FredericSegard/MH6502_v4/README.md

# MH6502-4
 This is my masterpiece MH6502-4.
