FredericSegard/MH6502_v4/Images and docs/Revision 4.pdf

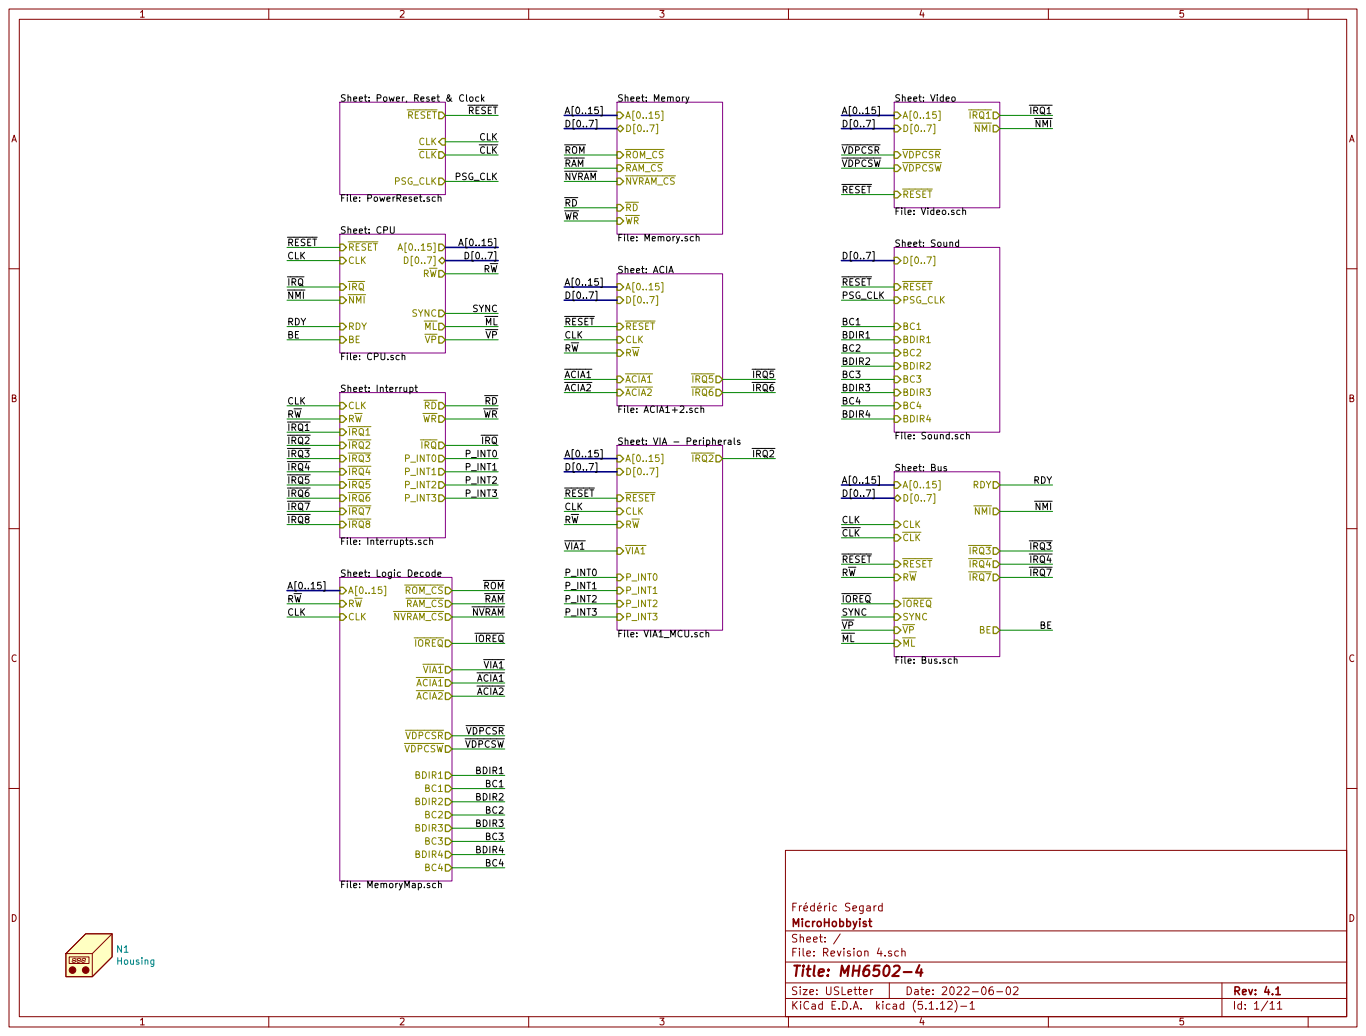
[picture p1: page 1]

Sheet: Power, Reset & Clock File: PowerReset.sch RESET CLK CLK

Sheet: Video File: Video.sch RESET
IRQ1 NMI A[0..15] VDPCSR
Sheet: Sound File: Sound.sch D[0..7] RESET BC1 BDIR1 PSG_CLK

Sheet: ACIA
File: ACIA1+2.sch A[0..15] CLK RW

IRQ
File: CPU.sch NMI

Sheet: Bus File: Bus.sch CLK CLK RESET RW
IRQ3 A[0..15]
NMI SYNC

Frédéric Segard
File: Revision 4.sch Sheet: / MicroHobbyist

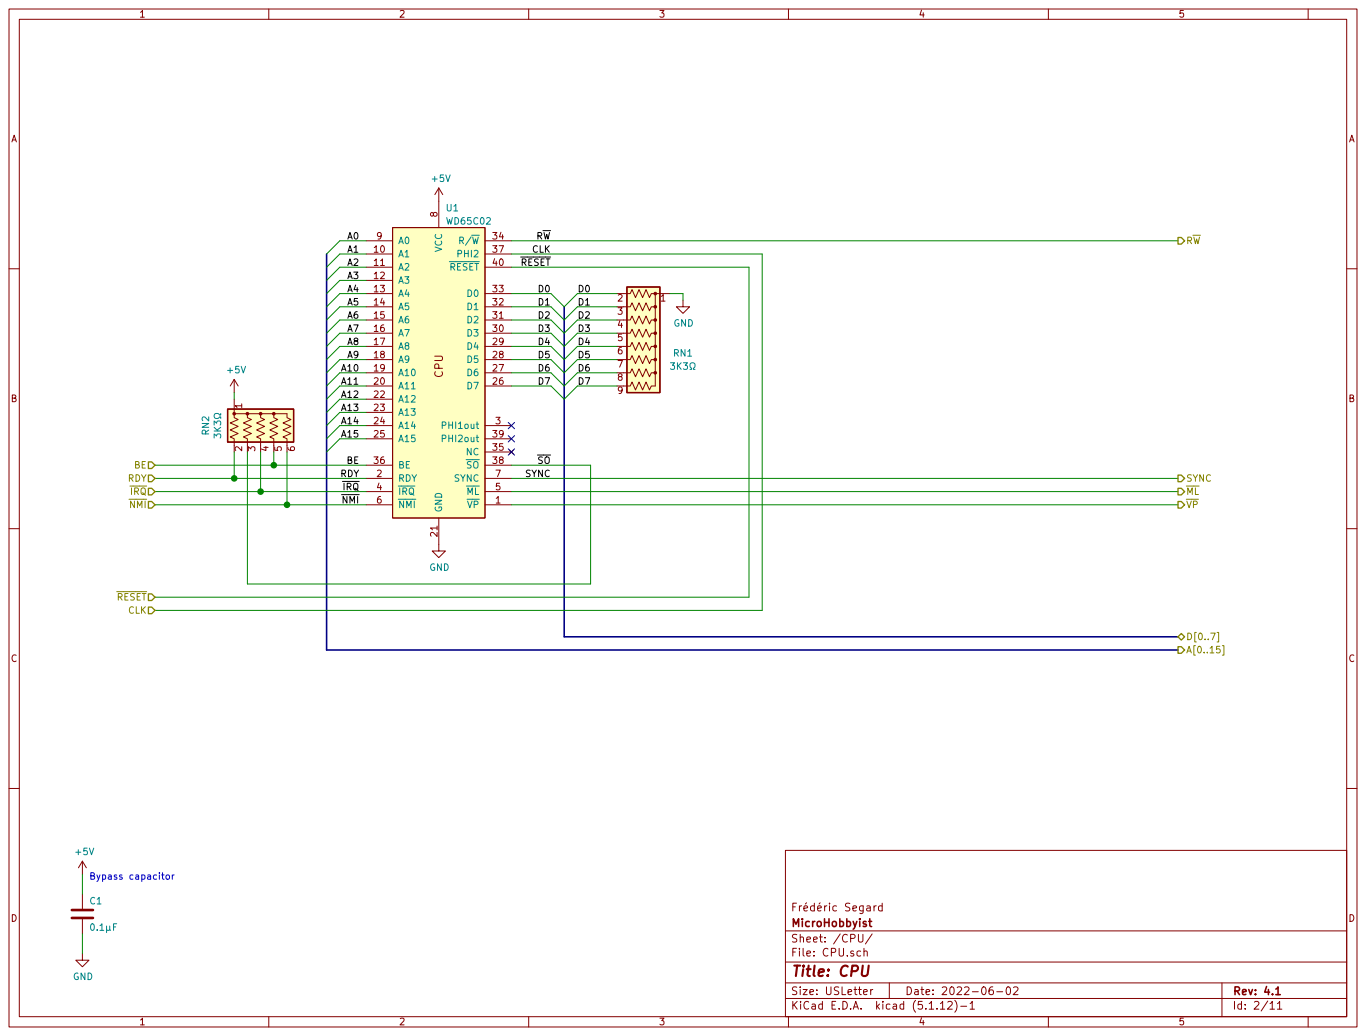
[picture p2: page 2]

Frédéric Segard
File: CPU.sch Sheet: /CPU/ MicroHobbyist

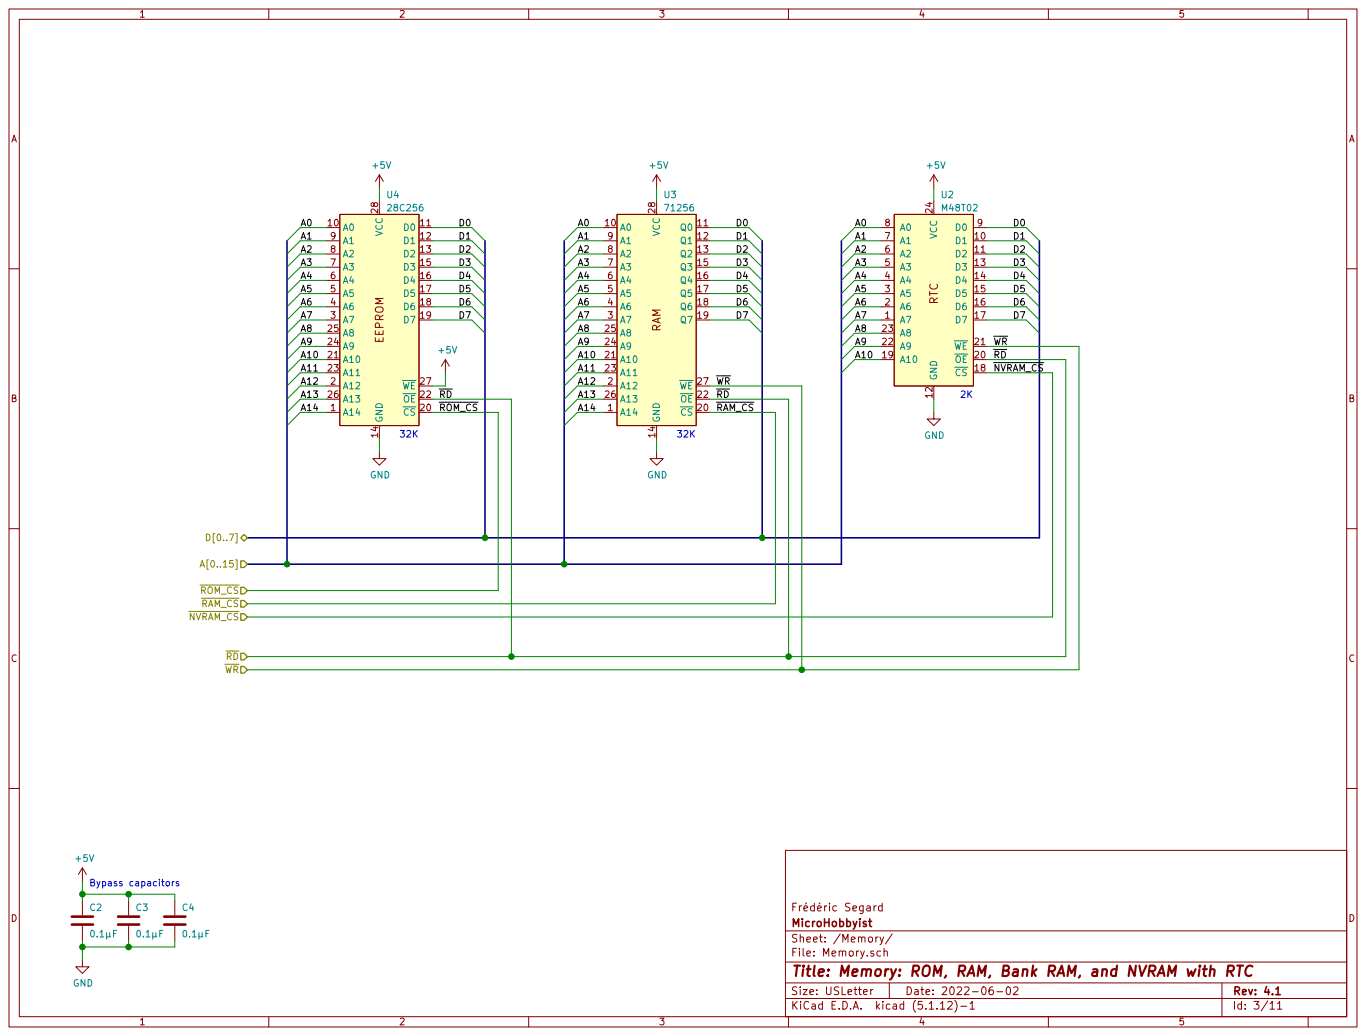
[picture p3: page 3]

Frédéric Segard GND EEPROM

MicroHobbyist
Sheet: /Memory/
File: Memory.sch
Id: 3/11 Title: Memory: ROM, RAM, Bank RAM, and NVRAM with RTC

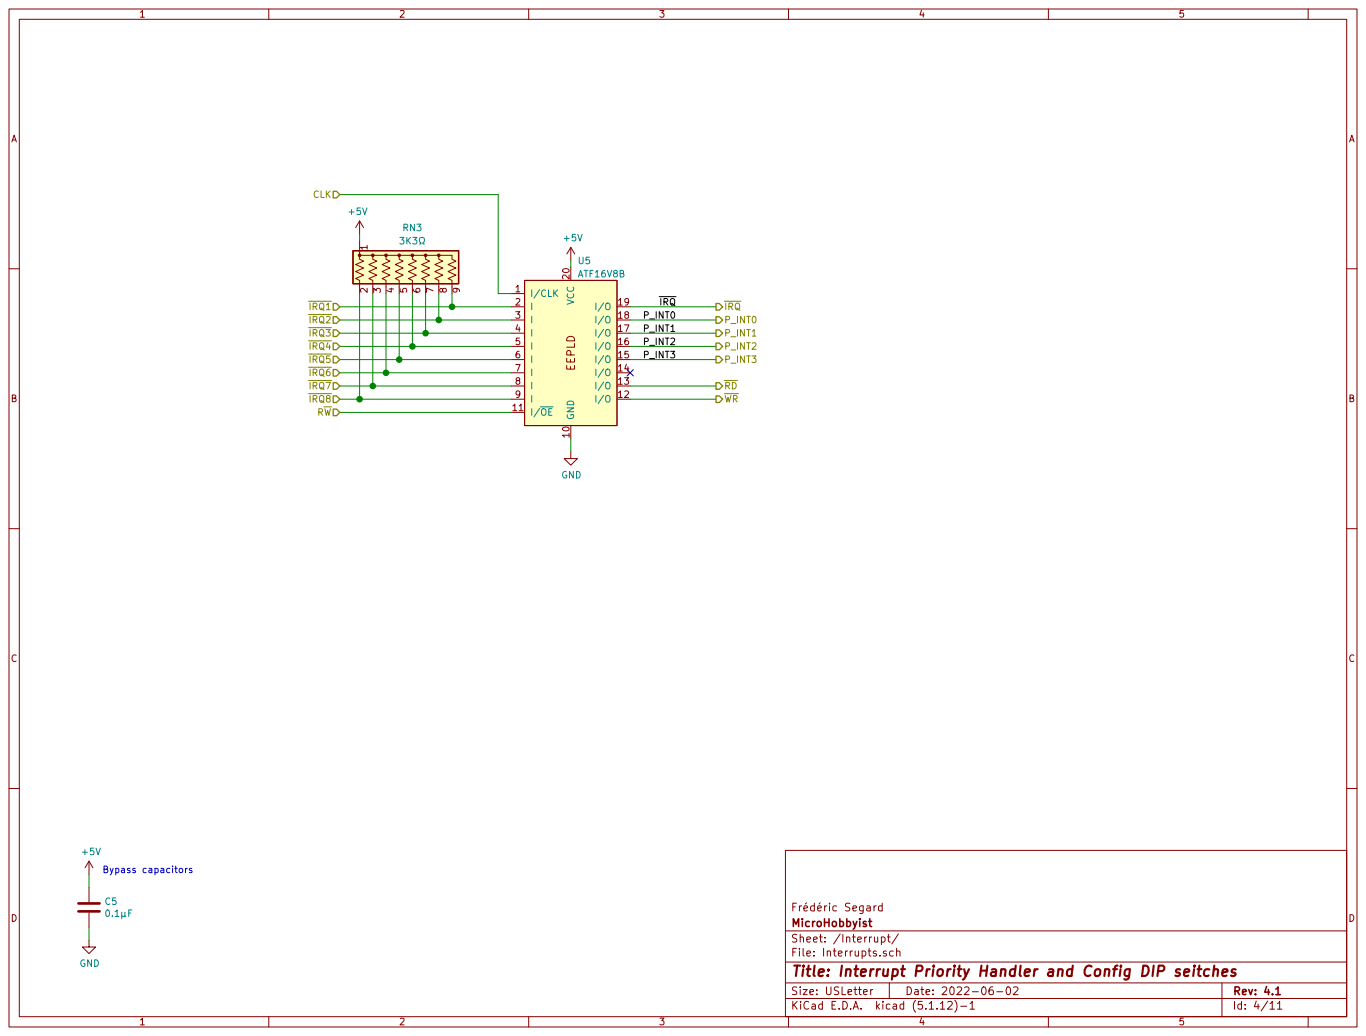
[picture p4: page 4]

MicroHobbyist
Sheet: /Interrupt/
File: Interrupts.sch
Id: 4/11 Title: Interrupt Priority Handler and Config DIP seitches

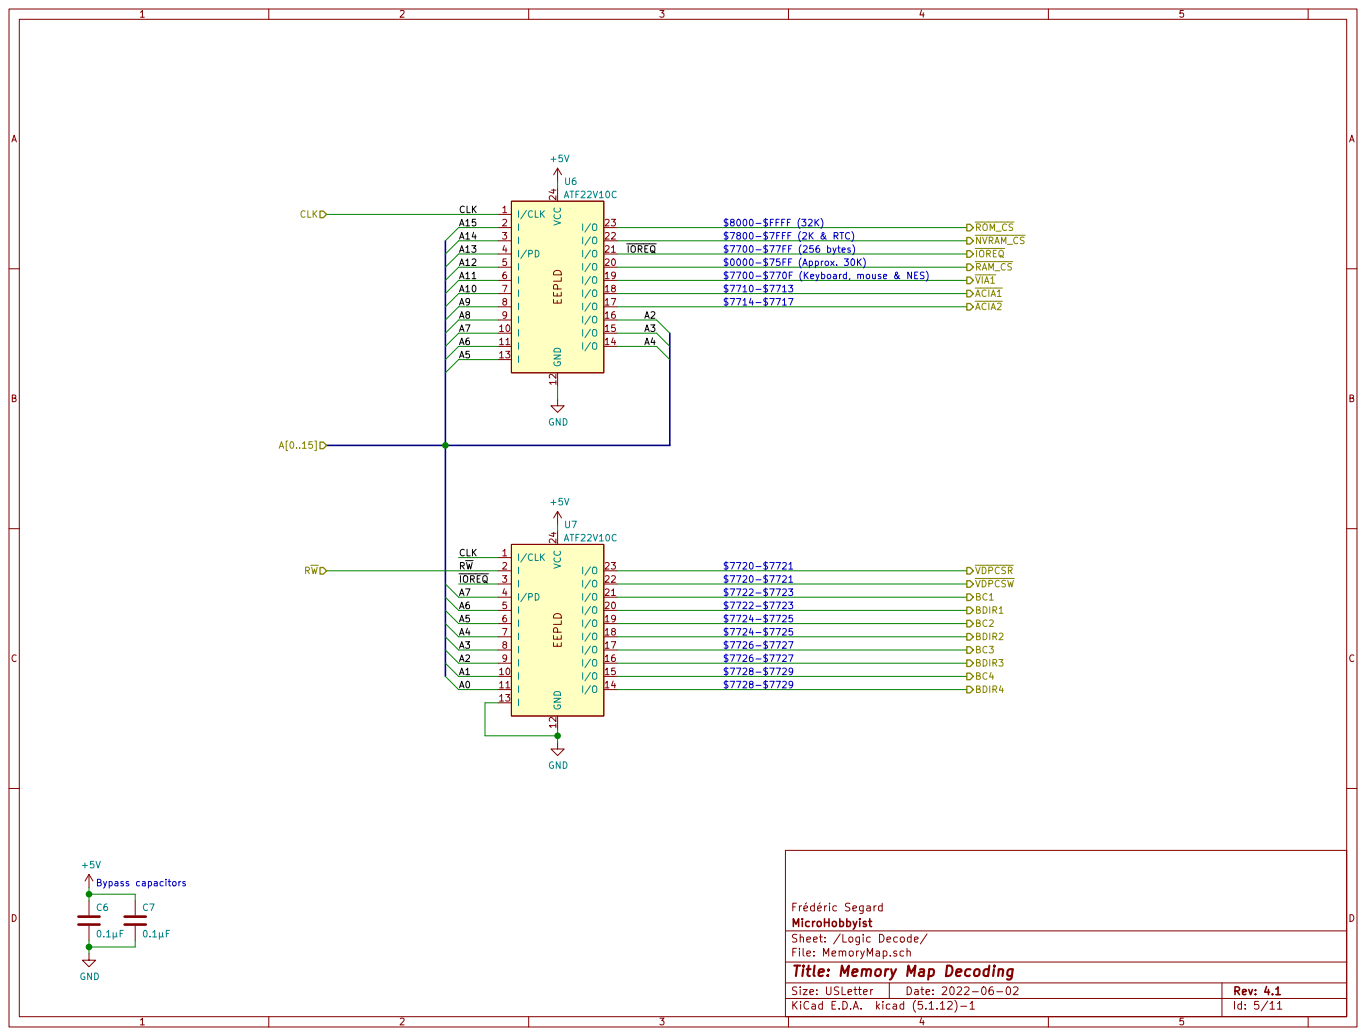
[picture p5: page 5]

MicroHobbyist
Sheet: /Logic Decode/
File: MemoryMap.sch
Id: 5/11 Title: Memory Map Decoding

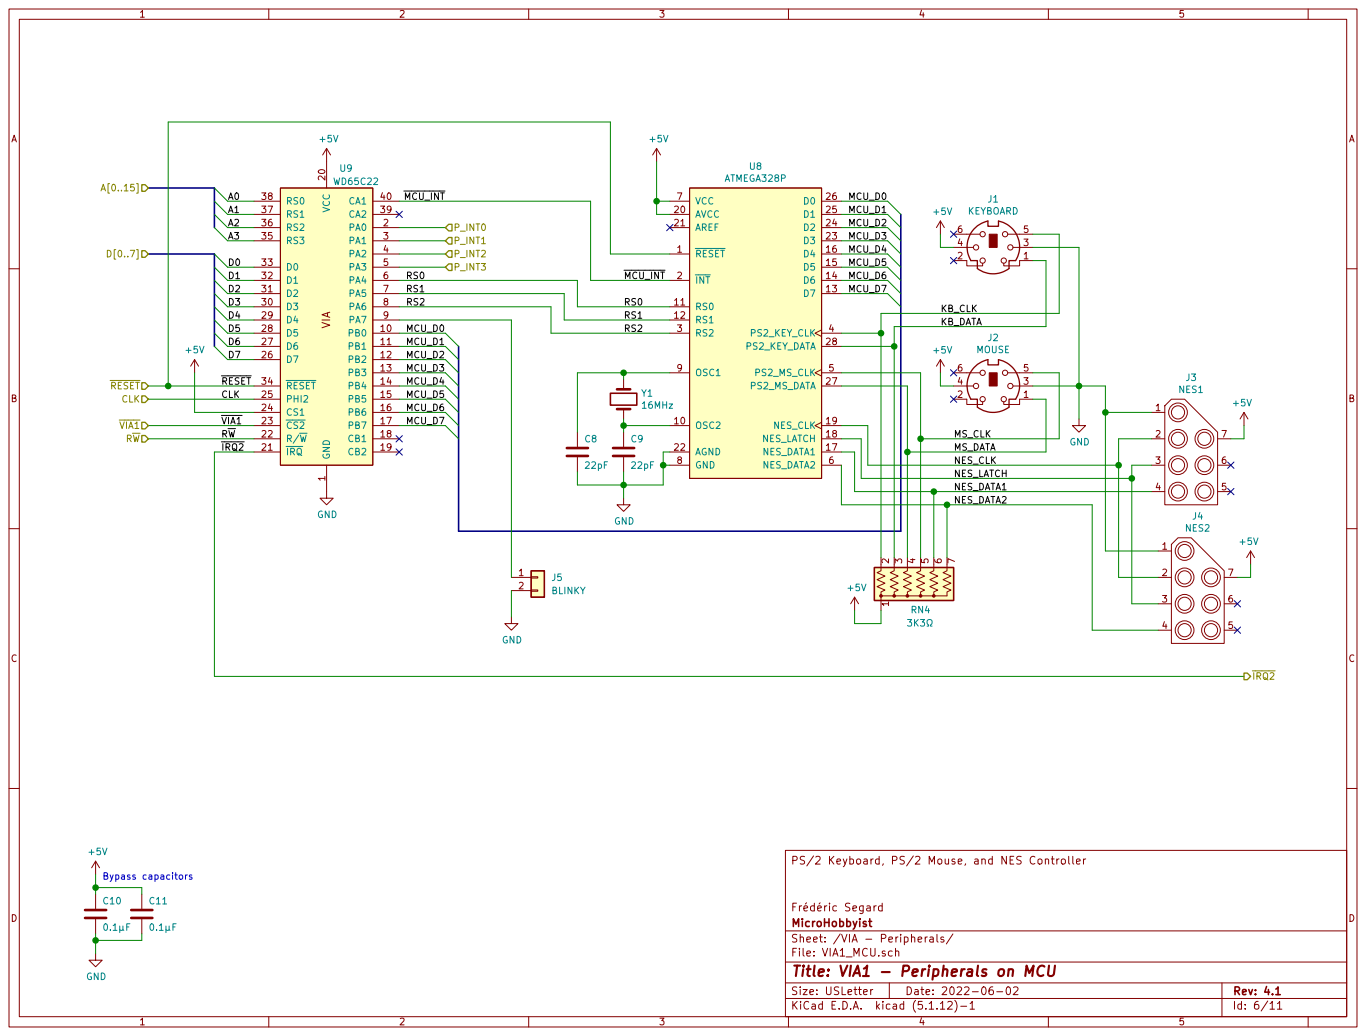
[picture p6: page 6]

PS/2 Keyboard, PS/2 Mouse, and NES Controller

Frédéric Segard
MicroHobbyist
Sheet: /VIA - Peripherals/
File: VIA1_MCU.sch
Id: 6/11 Title: VIA1 - Peripherals on MCU

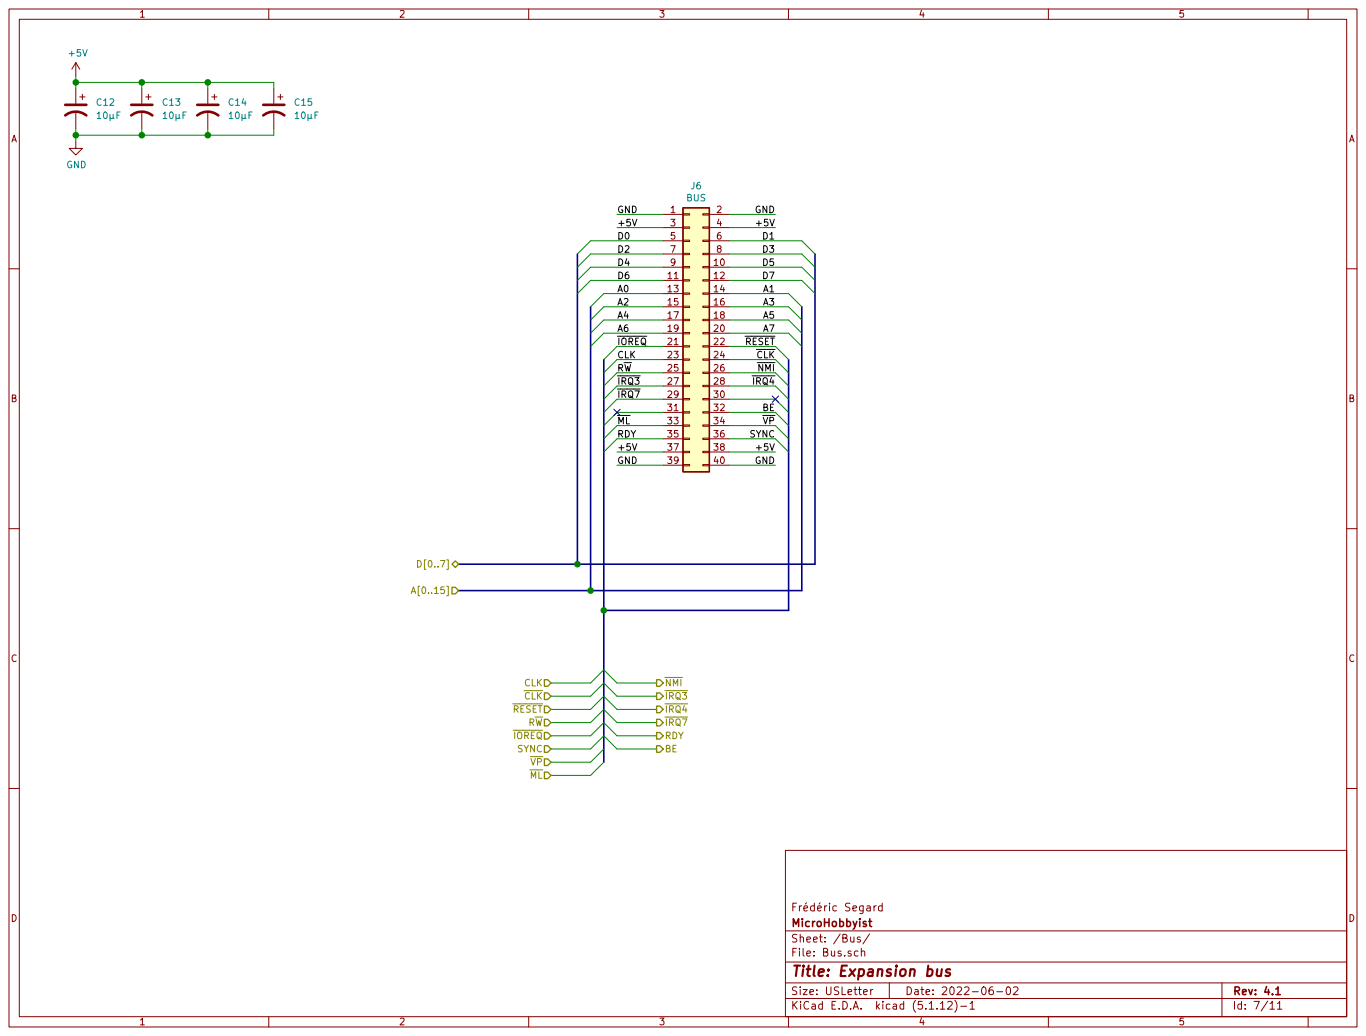
[picture p7: page 7]

Frédéric Segard
File: Bus.sch Sheet: /Bus/ MicroHobbyist

Id: 7/11 Title: Expansion bus

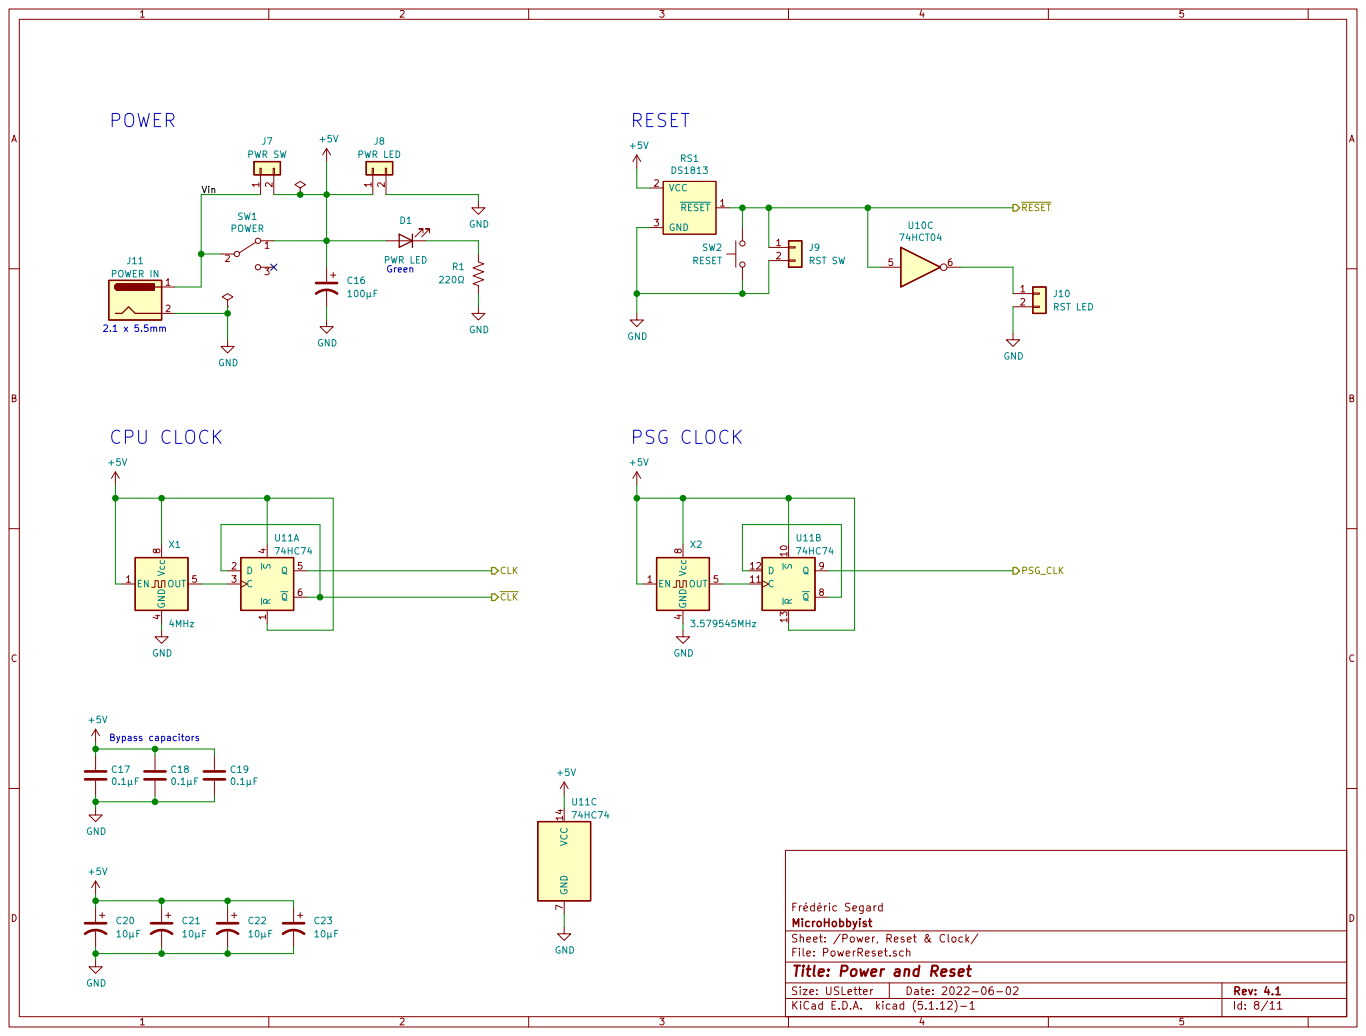
[picture p8: page 8]

Frédéric Segard
MicroHobbyist
Id: 8/11 Title: Power and Reset File: PowerReset.sch Sheet: /Power, Reset & Clock/

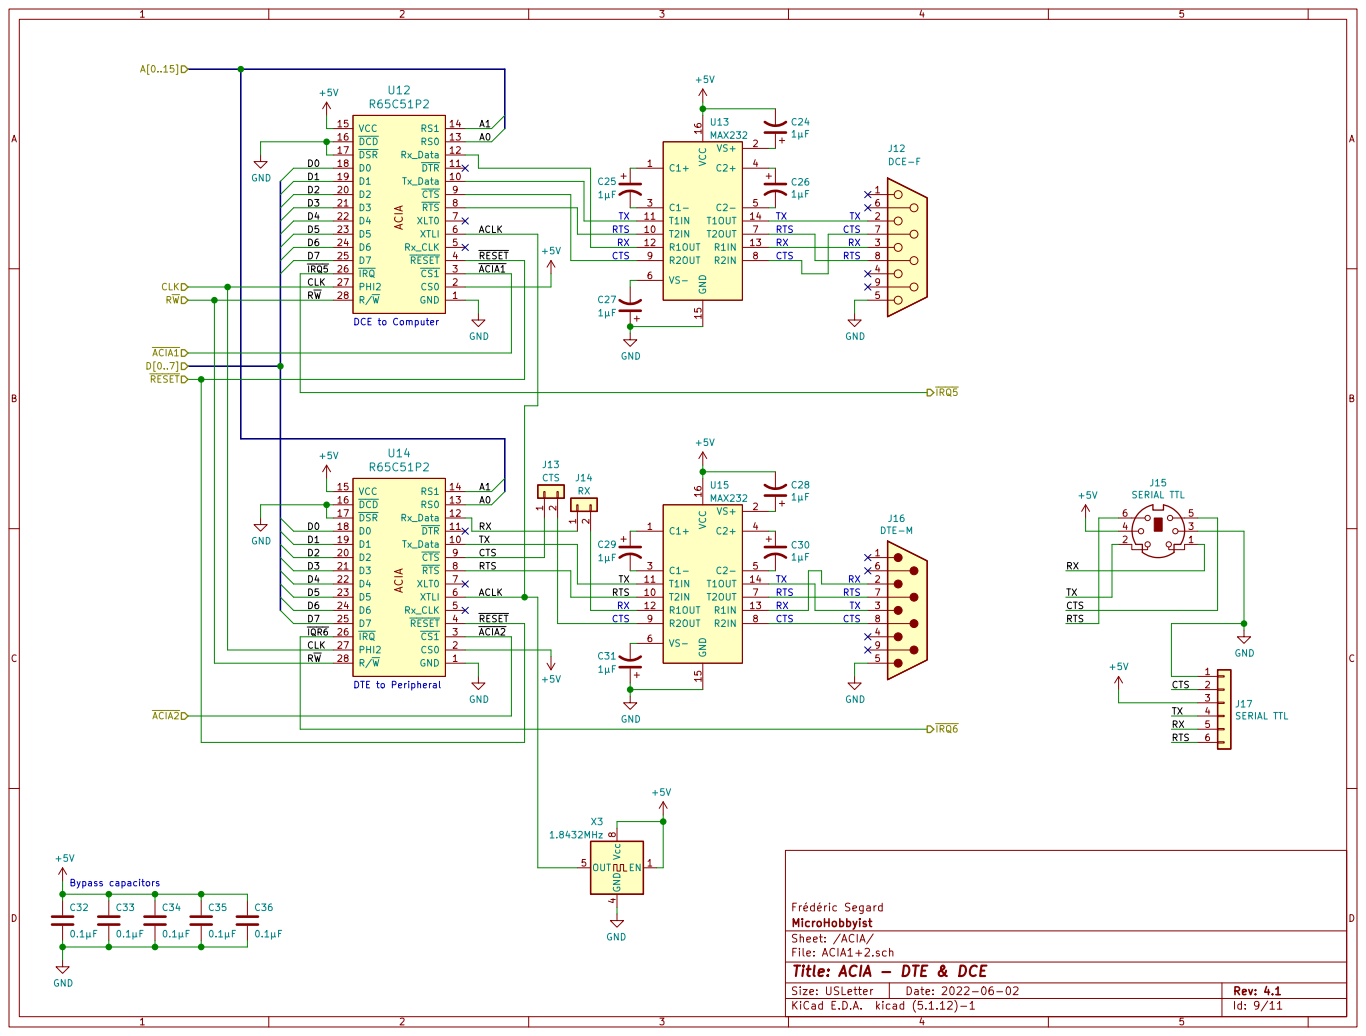
[picture p9: page 9]

Frédéric Segard
File: ACIA1+2.sch Sheet: /ACIA/ MicroHobbyist

Id: 9/11 Title: ACIA - DTE & DCE

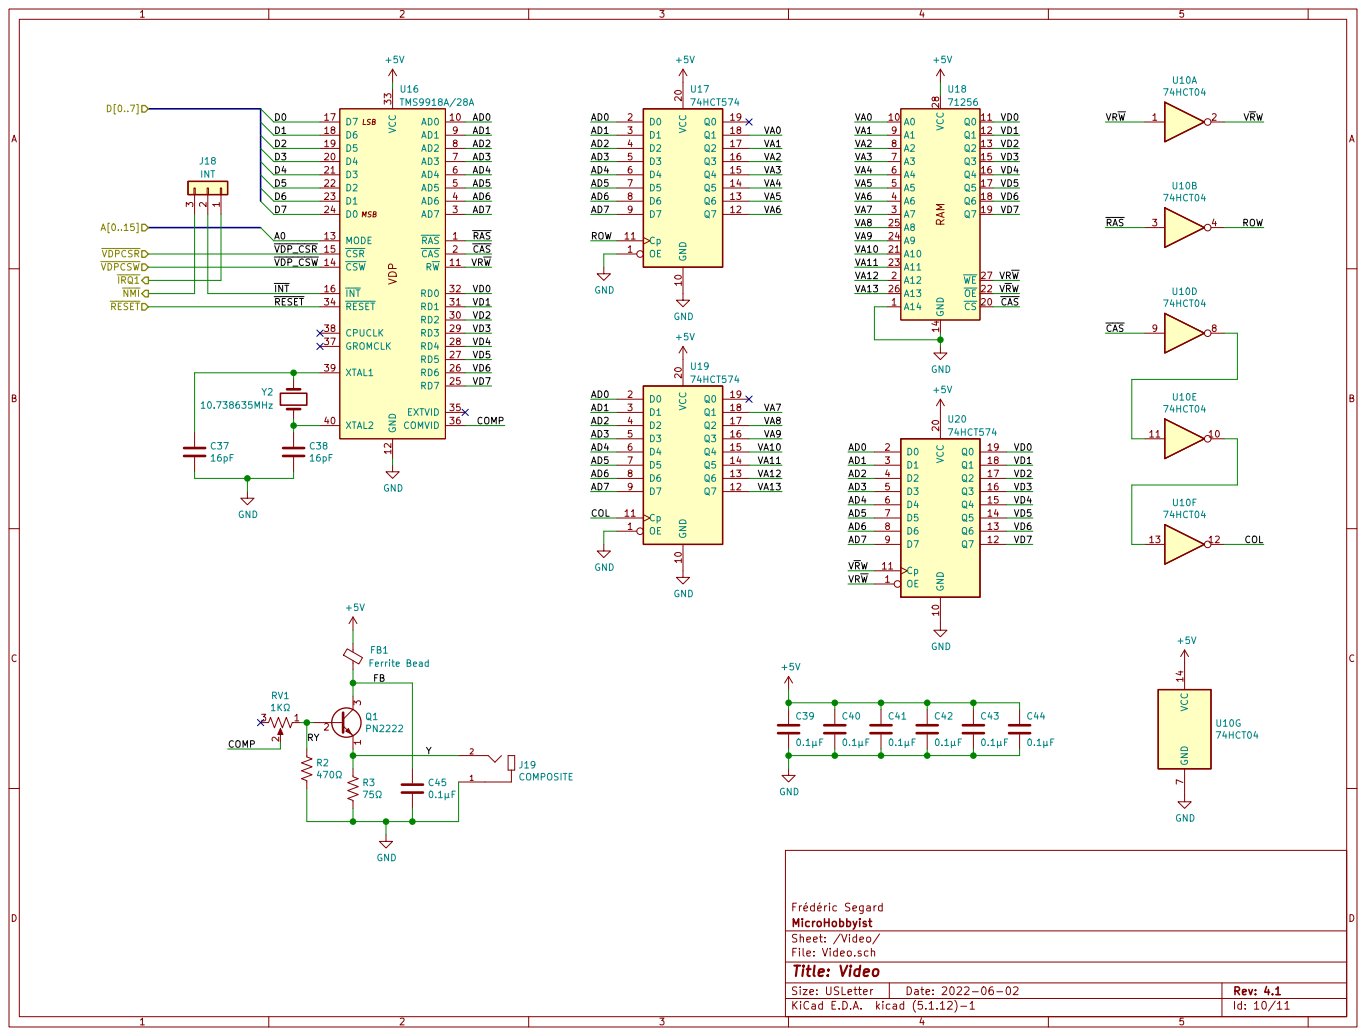
[picture p10: page 10]

File: Video.sch Sheet: /Video/ MicroHobbyist

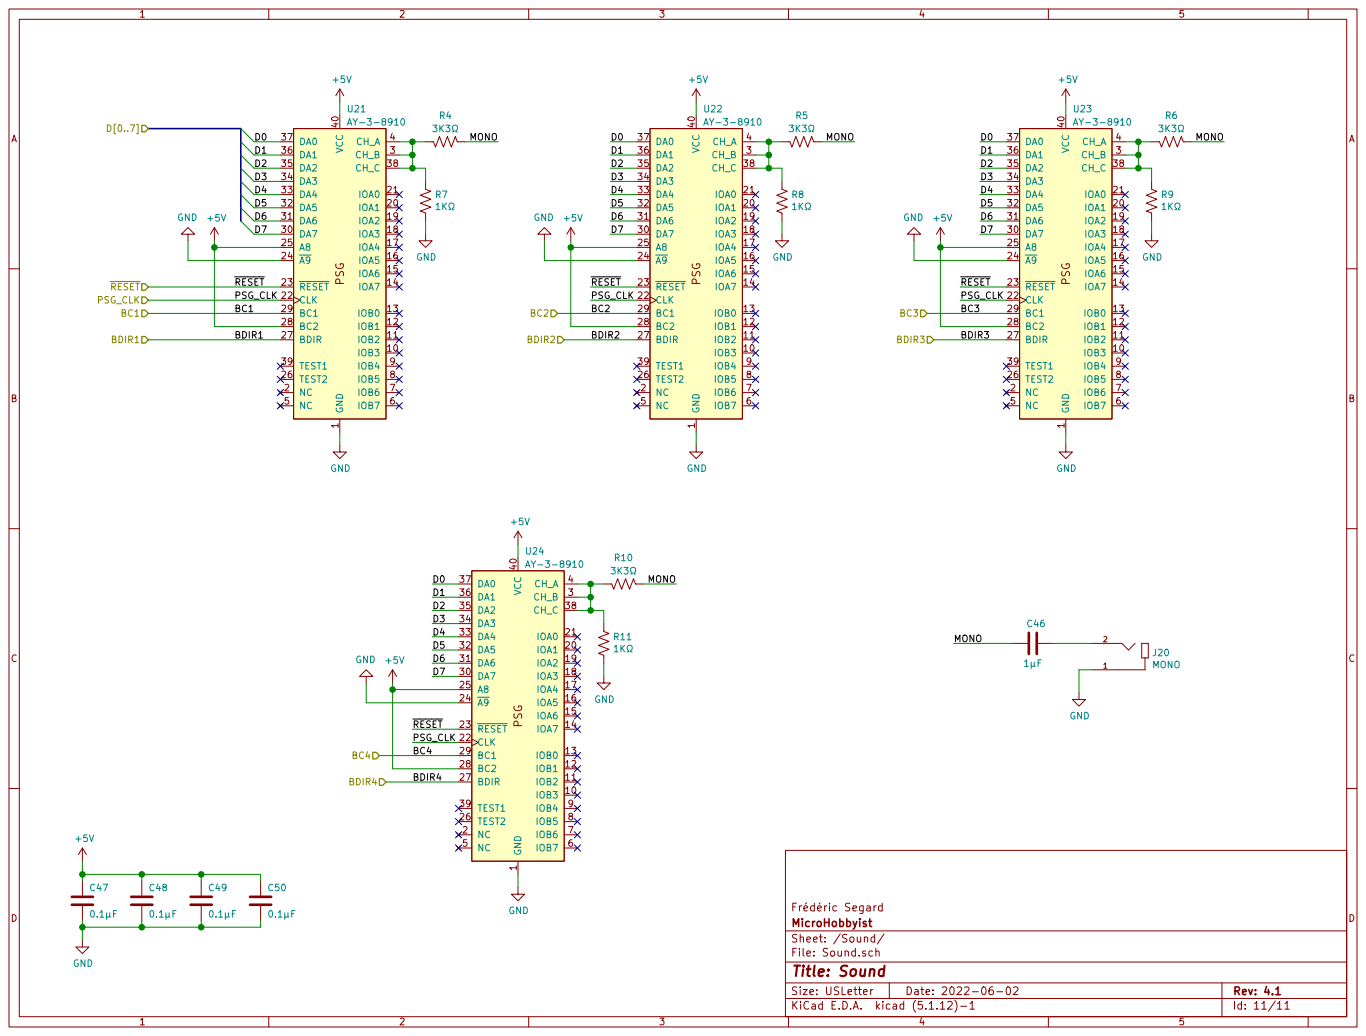
[picture p11: page 11]

Frédéric Segard
File: Sound.sch Sheet: /Sound/ MicroHobbyist
