FredericSegard/MH6502_v4/Schematic/Revision 4.kicad_pcb

## KiCad design Schematic/Revision 4.kicad_pcb (2023-08-16)

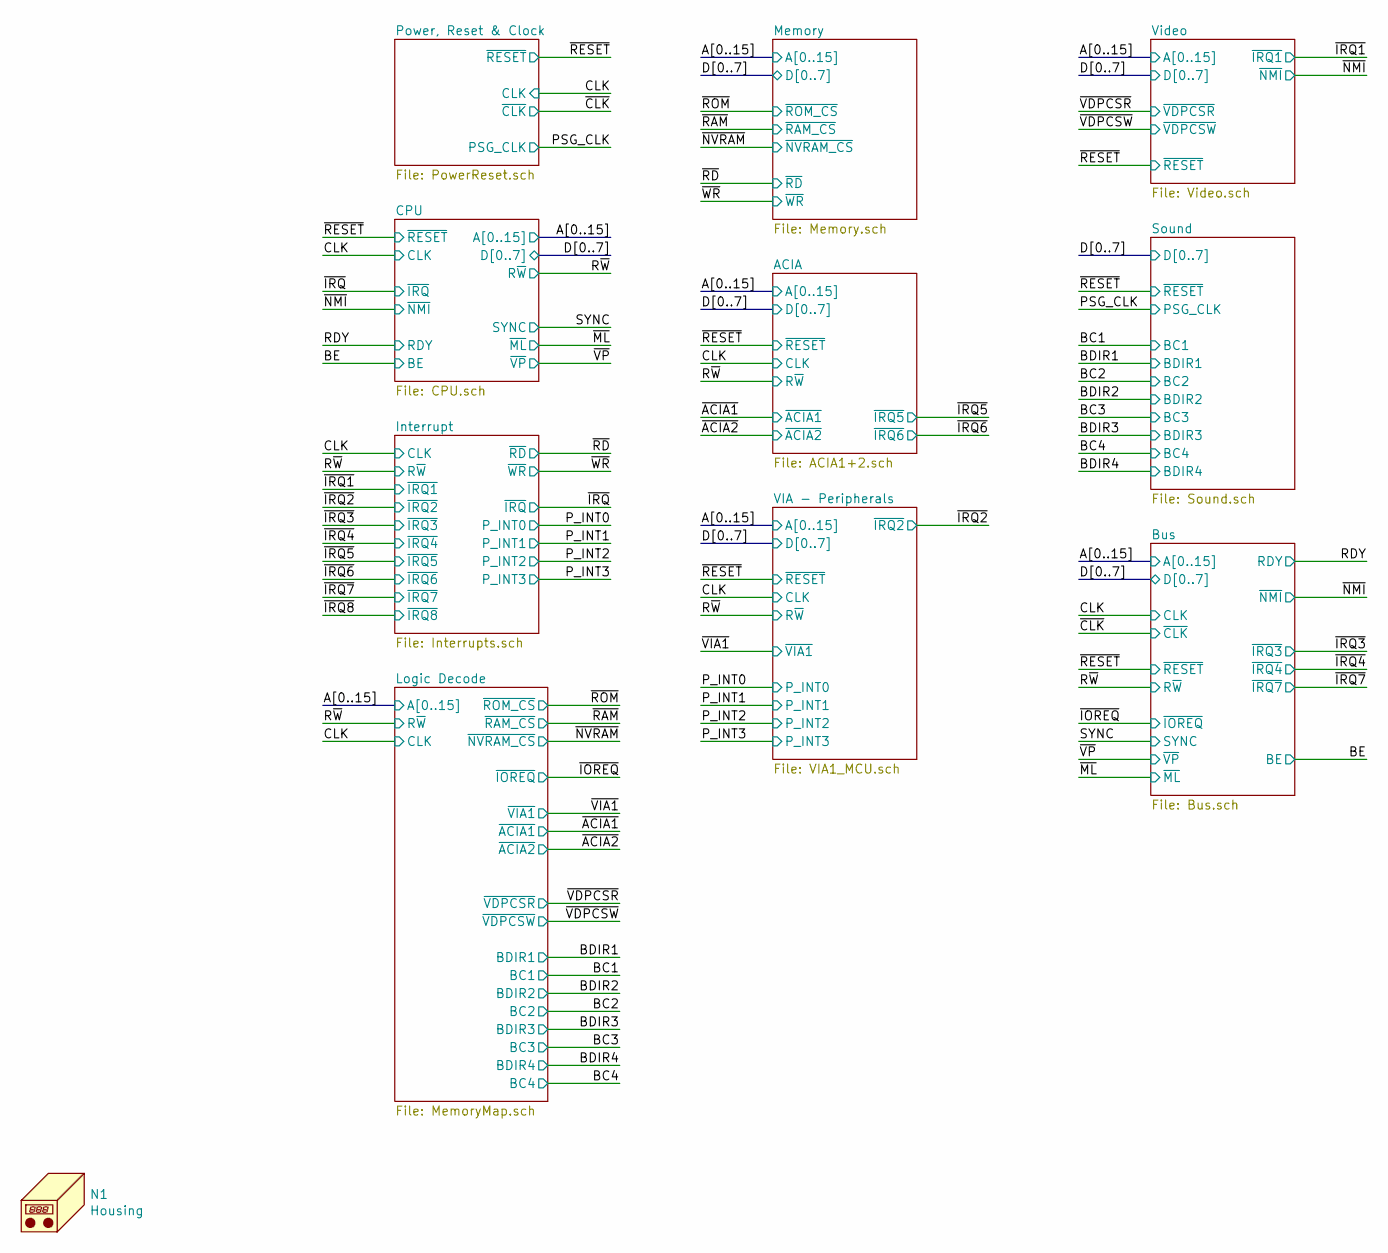
[picture p12: schematic Revision 4.sch, MH6502-4]

Parts:
N1: Housing; 18877_Housing

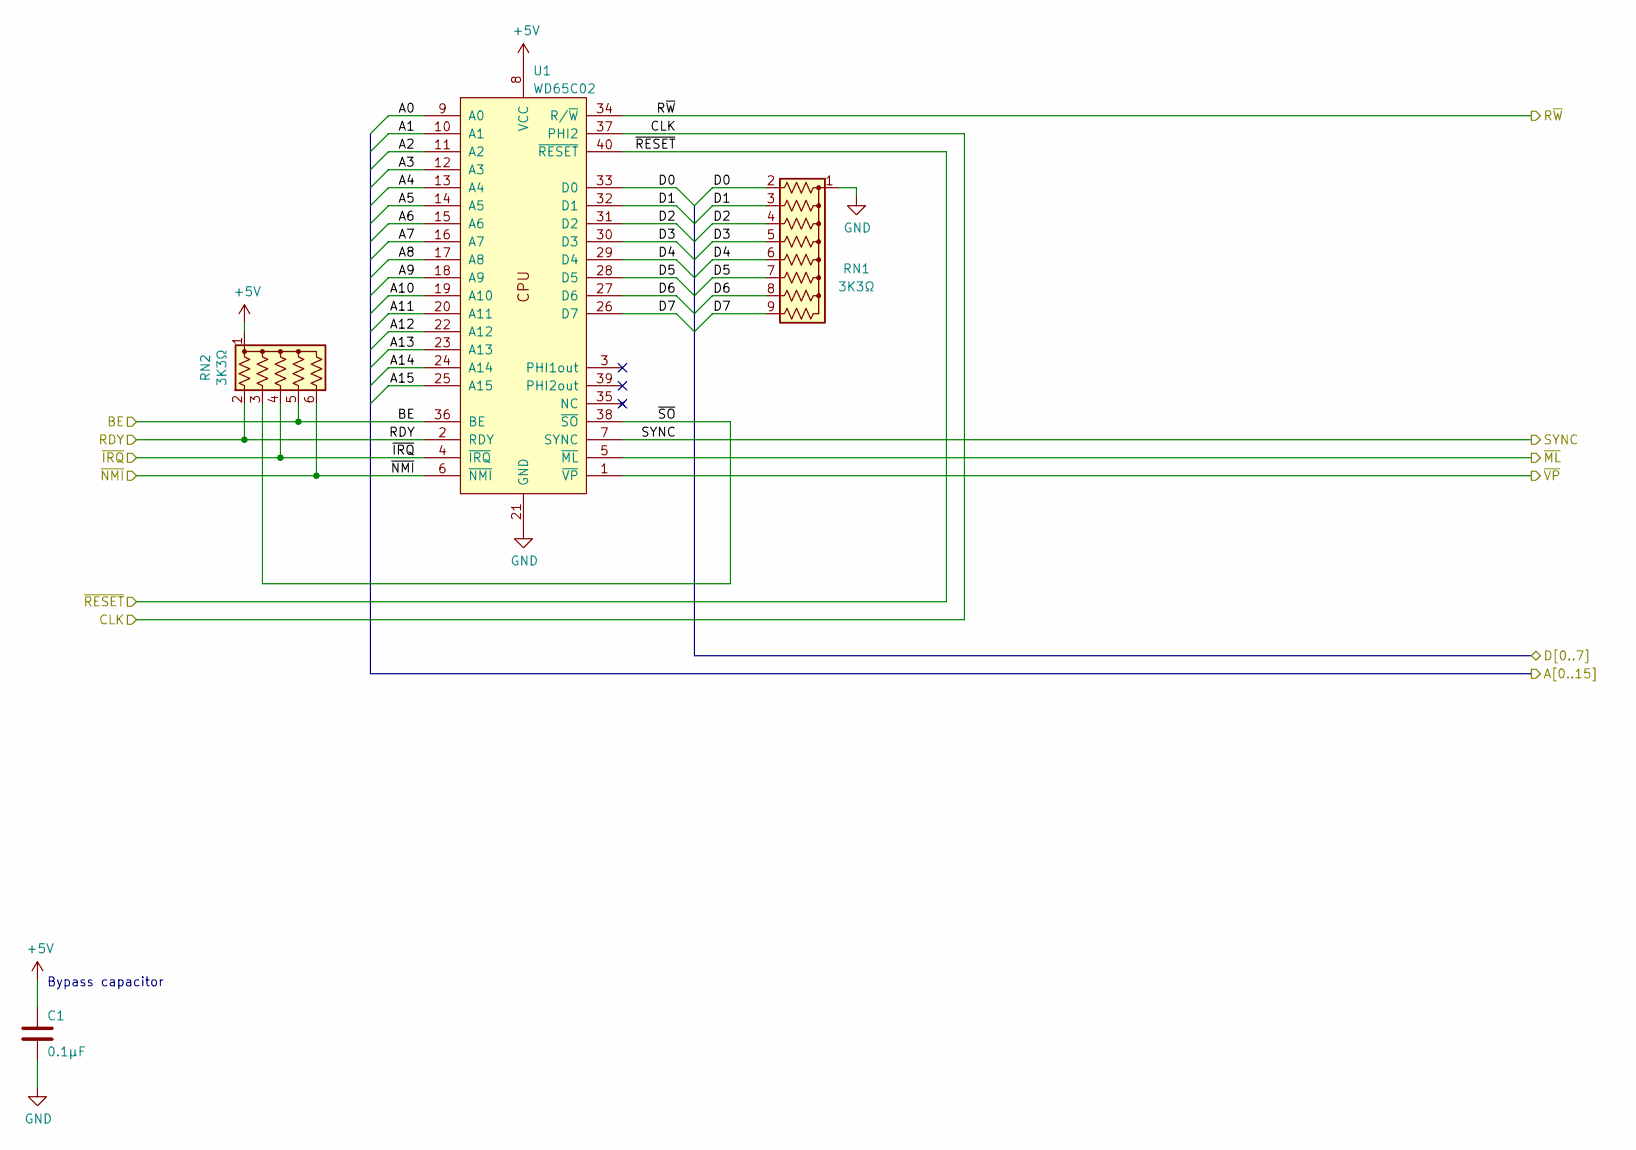
[picture p13: schematic CPU.sch]

Parts:
C1: 0.1µF; C_Disc_D3.0mm_W1.6mm_P2.50mm
RN1: 3K3Ω; R_Array_SIP9
RN2: 3K3Ω; R_Array_SIP6
U1: WD65C02; DIP-40_W15.24mm_Socket

Connections:
+5V: C1.1, RN2.1 (common), U1.8 (VCC); also elsewhere on the board
/ACIA/A0: U1.9 (A0); also elsewhere on the board
/ACIA/A1: U1.10 (A1); also elsewhere on the board
/ACIA/D0: RN1.2 (R1), U1.33 (D0); also elsewhere on the board
/ACIA/D1: RN1.3 (R2), U1.32 (D1); also elsewhere on the board
/ACIA/D2: RN1.4 (R3), U1.31 (D2); also elsewhere on the board
/ACIA/D3: RN1.5 (R4), U1.30 (D3); also elsewhere on the board
/ACIA/D4: RN1.6 (R5), U1.29 (D4); also elsewhere on the board
/ACIA/D5: RN1.7 (R6), U1.28 (D5); also elsewhere on the board
/ACIA/D6: RN1.8 (R7), U1.27 (D6); also elsewhere on the board
/ACIA/D7: RN1.9 (R8), U1.26 (D7); also elsewhere on the board
/BE: RN2.5 (R4), U1.36 (BE); also elsewhere on the board
/Bus/A2: U1.11 (A2); also elsewhere on the board
/Bus/A3: U1.12 (A3); also elsewhere on the board
/Bus/A4: U1.13 (A4); also elsewhere on the board
/Bus/A5: U1.14 (A5); also elsewhere on the board
/Bus/A6: U1.15 (A6); also elsewhere on the board
/Bus/A7: U1.16 (A7); also elsewhere on the board
/CLK: U1.37 (PHI2); also elsewhere on the board
/CPU/A8: U1.17 (A8); also elsewhere on the board
/CPU/A9: U1.18 (A9); also elsewhere on the board
/CPU/A10: U1.19 (A10); also elsewhere on the board
/CPU/A11: U1.20 (A11); also elsewhere on the board
/CPU/A12: U1.22 (A12); also elsewhere on the board
/CPU/A13: U1.23 (A13); also elsewhere on the board
/CPU/A14: U1.24 (A14); also elsewhere on the board
/CPU/A15: U1.25 (A15); also elsewhere on the board
/CPU/~SO: RN2.3 (R2), U1.38 (~SO)
/RDY: RN2.2 (R1), U1.2 (RDY); also elsewhere on the board
/R~W: U1.34 (R/~W); also elsewhere on the board
/SYNC: U1.7 (SYNC); also elsewhere on the board
/~IRQ: RN2.4 (R3), U1.4 (~IRQ); also elsewhere on the board
/~ML: U1.5 (~ML); also elsewhere on the board
/~NMI: RN2.6 (R5), U1.6 (~NMI); also elsewhere on the board
/~RESET: U1.40 (~RESET); also elsewhere on the board
/~VP: U1.1 (~VP); also elsewhere on the board
GND: C1.2, RN1.1 (common), U1.21 (GND); also elsewhere on the board

Notes on the sheet:
Bypass capacitor

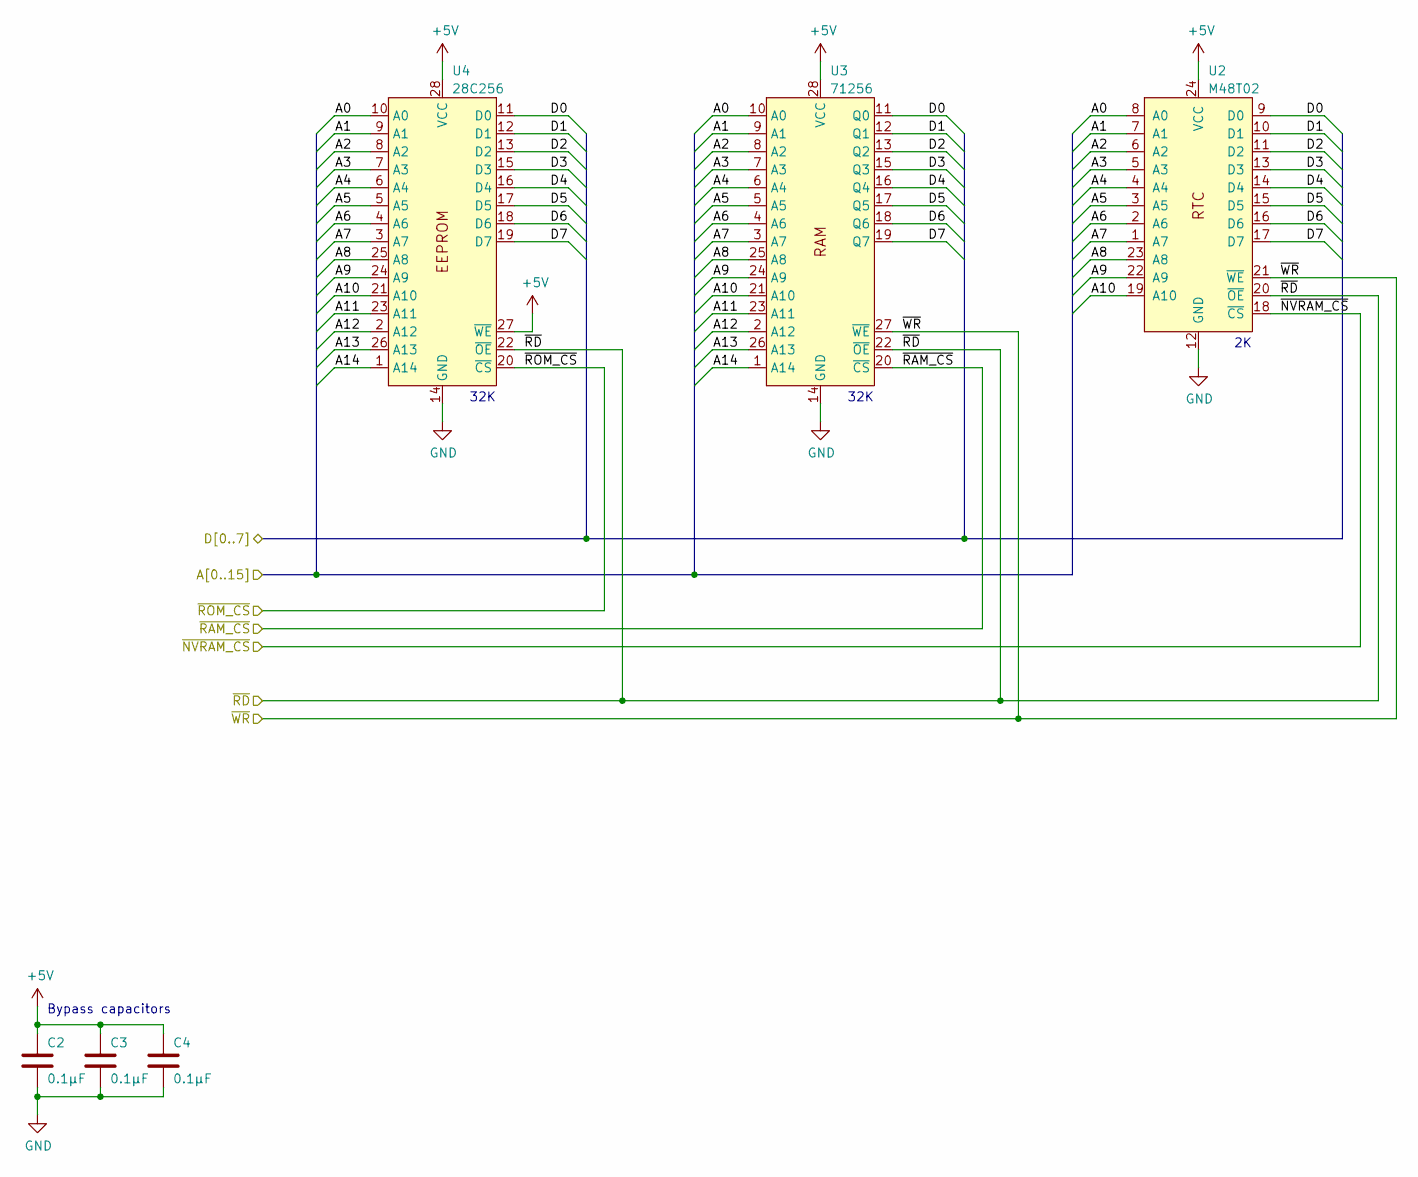
[picture p14: schematic Memory.sch, Memory: ROM, RAM, Bank RAM, and NVRAM with RTC]

Parts:
C2, C3, C4: 0.1µF; C_Disc_D3.0mm_W1.6mm_P2.50mm
U2: M48T02; DIP-24_W15.24mm_Socket
U3: 71256; DIP-28_W7.62mm_Socket
U4: 28C256; ZIF-28

Connections:
+5V: C2.1, C3.1, C4.1, U2.24 (VCC), U3.28 (VCC), U4.27 (~WE), U4.28 (VCC); also elsewhere on the board
/ACIA/A0: U2.8 (A0), U3.10 (A0), U4.10 (A0); also elsewhere on the board
/ACIA/A1: U2.7 (A1), U3.9 (A1), U4.9 (A1); also elsewhere on the board
/ACIA/D0: U2.9 (D0), U3.11 (Q0), U4.11 (D0); also elsewhere on the board
/ACIA/D1: U2.10 (D1), U3.12 (Q1), U4.12 (D1); also elsewhere on the board
/ACIA/D2: U2.11 (D2), U3.13 (Q2), U4.13 (D2); also elsewhere on the board
/ACIA/D3: U2.13 (D3), U3.15 (Q3), U4.15 (D3); also elsewhere on the board
/ACIA/D4: U2.14 (D4), U3.16 (Q4), U4.16 (D4); also elsewhere on the board
/ACIA/D5: U2.15 (D5), U3.17 (Q5), U4.17 (D5); also elsewhere on the board
/ACIA/D6: U2.16 (D6), U3.18 (Q6), U4.18 (D6); also elsewhere on the board
/ACIA/D7: U2.17 (D7), U3.19 (Q7), U4.19 (D7); also elsewhere on the board
/Bus/A2: U2.6 (A2), U3.8 (A2), U4.8 (A2); also elsewhere on the board
/Bus/A3: U2.5 (A3), U3.7 (A3), U4.7 (A3); also elsewhere on the board
/Bus/A4: U2.4 (A4), U3.6 (A4), U4.6 (A4); also elsewhere on the board
/Bus/A5: U2.3 (A5), U3.5 (A5), U4.5 (A5); also elsewhere on the board
/Bus/A6: U2.2 (A6), U3.4 (A6), U4.4 (A6); also elsewhere on the board
/Bus/A7: U2.1 (A7), U3.3 (A7), U4.3 (A7); also elsewhere on the board
/CPU/A8: U2.23 (A8), U3.25 (A8), U4.25 (A8); also elsewhere on the board
/CPU/A9: U2.22 (A9), U3.24 (A9), U4.24 (A9); also elsewhere on the board
/CPU/A10: U2.19 (A10), U3.21 (A10), U4.21 (A10); also elsewhere on the board
/CPU/A11: U3.23 (A11), U4.23 (A11); also elsewhere on the board
/CPU/A12: U3.2 (A12), U4.2 (A12); also elsewhere on the board
/CPU/A13: U3.26 (A13), U4.26 (A13); also elsewhere on the board
/CPU/A14: U3.1 (A14), U4.1 (A14); also elsewhere on the board
/~NVRAM: U2.18 (~CS); also elsewhere on the board
/~RAM: U3.20 (~CS); also elsewhere on the board
/~RD: U2.20 (~OE), U3.22 (~OE), U4.22 (~OE); also elsewhere on the board
/~ROM: U4.20 (~CS); also elsewhere on the board
/~WR: U2.21 (~WE), U3.27 (~WE); also elsewhere on the board
GND: C2.2, C3.2, C4.2, U2.12 (GND), U3.14 (GND), U4.14 (GND); also elsewhere on the board

Notes on the sheet:
32K
Bypass capacitors

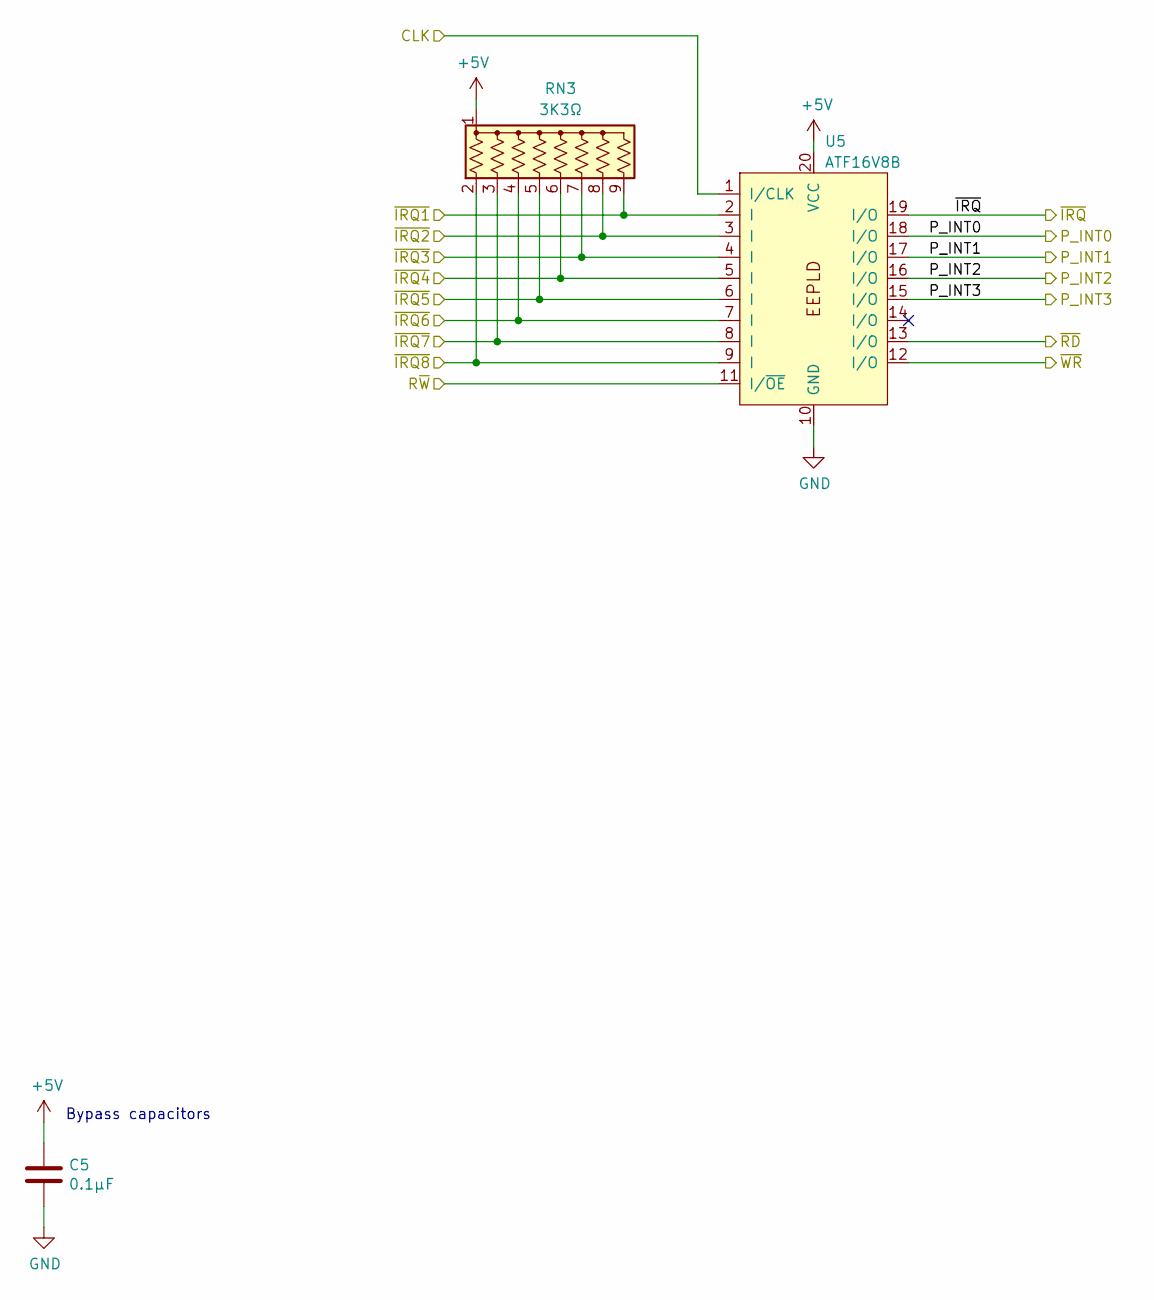
[picture p15: schematic Interrupts.sch, Interrupt Priority Handler and Config DIP seitches]

Parts:
C5: 0.1µF; C_Disc_D3.0mm_W1.6mm_P2.50mm
RN3: 3K3Ω; R_Array_SIP9
U5: ATF16V8B; DIP-20_W7.62mm_Socket

Connections:
+5V: C5.1, RN3.1 (common), U5.20 (VCC); also elsewhere on the board
/CLK: U5.1 (I/CLK); also elsewhere on the board
/P_INT0: U5.18 (I/O); also elsewhere on the board
/P_INT1: U5.17 (I/O); also elsewhere on the board
/P_INT2: U5.16 (I/O); also elsewhere on the board
/P_INT3: U5.15 (I/O); also elsewhere on the board
/R~W: U5.11 (I/~OE); also elsewhere on the board
/~IRQ: U5.19 (I/O); also elsewhere on the board
/~IRQ1: RN3.9 (R8), U5.2 (I); also elsewhere on the board
/~IRQ2: RN3.8 (R7), U5.3 (I); also elsewhere on the board
/~IRQ3: RN3.7 (R6), U5.4 (I); also elsewhere on the board
/~IRQ4: RN3.6 (R5), U5.5 (I); also elsewhere on the board
/~IRQ5: RN3.5 (R4), U5.6 (I); also elsewhere on the board
/~IRQ6: RN3.4 (R3), U5.7 (I); also elsewhere on the board
/~IRQ7: RN3.3 (R2), U5.8 (I); also elsewhere on the board
/~IRQ8: RN3.2 (R1), U5.9 (I)
/~RD: U5.13 (I/O); also elsewhere on the board
/~WR: U5.12 (I/O); also elsewhere on the board
GND: C5.2, U5.10 (GND); also elsewhere on the board

Notes on the sheet:
Bypass capacitors

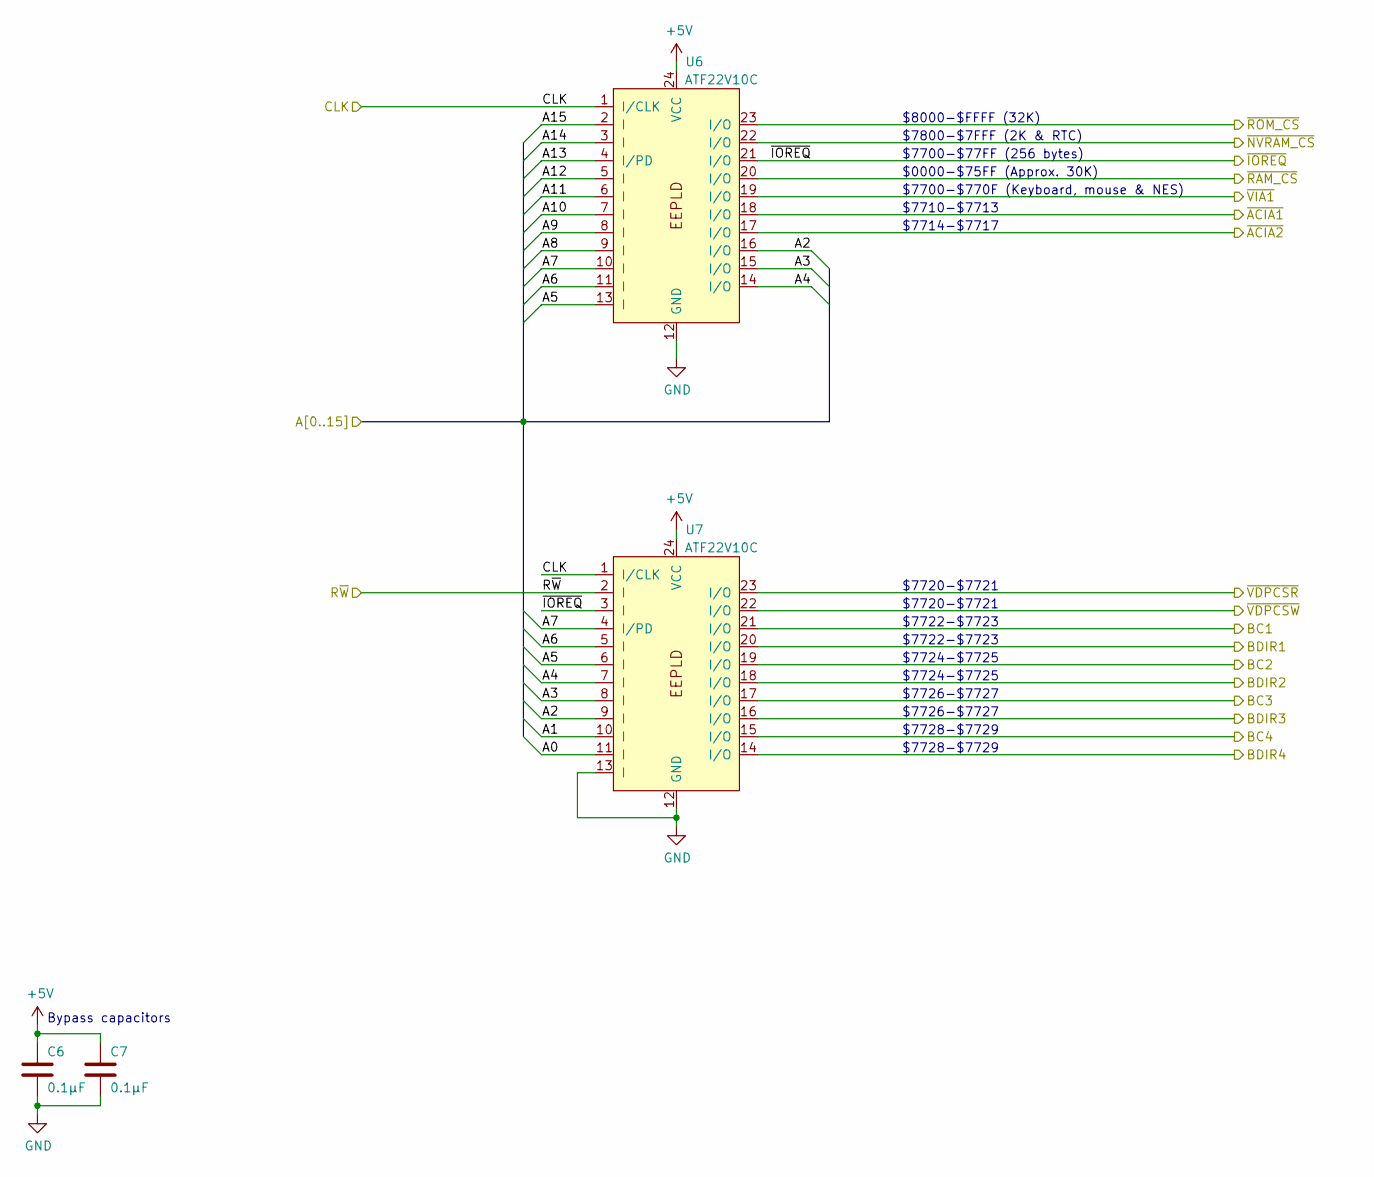
[picture p16: schematic MemoryMap.sch, Memory Map Decoding]

Parts:
C6, C7: 0.1µF; C_Disc_D3.0mm_W1.6mm_P2.50mm
U6, U7: ATF22V10C; DIP-24_W7.62mm_Socket

Connections:
+5V: C6.1, C7.1, U6.24 (VCC), U7.24 (VCC); also elsewhere on the board
/ACIA/A0: U7.11 (I); also elsewhere on the board
/ACIA/A1: U7.10 (I); also elsewhere on the board
/BC1: U7.21 (I/O); also elsewhere on the board
/BC2: U7.19 (I/O); also elsewhere on the board
/BC3: U7.17 (I/O); also elsewhere on the board
/BC4: U7.15 (I/O); also elsewhere on the board
/BDIR1: U7.20 (I/O); also elsewhere on the board
/BDIR2: U7.18 (I/O); also elsewhere on the board
/BDIR3: U7.16 (I/O); also elsewhere on the board
/BDIR4: U7.14 (I/O); also elsewhere on the board
/Bus/A2: U6.16 (I/O), U7.9 (I); also elsewhere on the board
/Bus/A3: U6.15 (I/O), U7.8 (I); also elsewhere on the board
/Bus/A4: U6.14 (I/O), U7.7 (I); also elsewhere on the board
/Bus/A5: U6.13 (I), U7.6 (I); also elsewhere on the board
/Bus/A6: U6.11 (I), U7.5 (I); also elsewhere on the board
/Bus/A7: U6.10 (I), U7.4 (I/PD); also elsewhere on the board
/CLK: U6.1 (I/CLK), U7.1 (I/CLK); also elsewhere on the board
/CPU/A8: U6.9 (I); also elsewhere on the board
/CPU/A9: U6.8 (I); also elsewhere on the board
/CPU/A10: U6.7 (I); also elsewhere on the board
/CPU/A11: U6.6 (I); also elsewhere on the board
/CPU/A12: U6.5 (I); also elsewhere on the board
/CPU/A13: U6.4 (I/PD); also elsewhere on the board
/CPU/A14: U6.3 (I); also elsewhere on the board
/CPU/A15: U6.2 (I); also elsewhere on the board
/R~W: U7.2 (I); also elsewhere on the board
/~ACIA1: U6.18 (I/O); also elsewhere on the board
/~ACIA2: U6.17 (I/O); also elsewhere on the board
/~IOREQ: U6.21 (I/O), U7.3 (I); also elsewhere on the board
/~NVRAM: U6.22 (I/O); also elsewhere on the board
/~RAM: U6.20 (I/O); also elsewhere on the board
/~ROM: U6.23 (I/O); also elsewhere on the board
/~VDPCSR: U7.23 (I/O); also elsewhere on the board
/~VDPCSW: U7.22 (I/O); also elsewhere on the board
/~VIA1: U6.19 (I/O); also elsewhere on the board
GND: C6.2, C7.2, U6.12 (GND), U7.12 (GND), U7.13 (I); also elsewhere on the board

Notes on the sheet:
Bypass capacitors
$8000-$FFFF (32K)
$7800-$7FFF (2K & RTC)
$7700-$77FF (256 bytes)
$0000-$75FF (Approx. 30K)
$7714-$7717
$7700-$770F (Keyboard, mouse & NES)
$7720-$7721
$7722-$7723
$7724-$7725
$7726-$7727
$7710-$7713
$7728-$7729

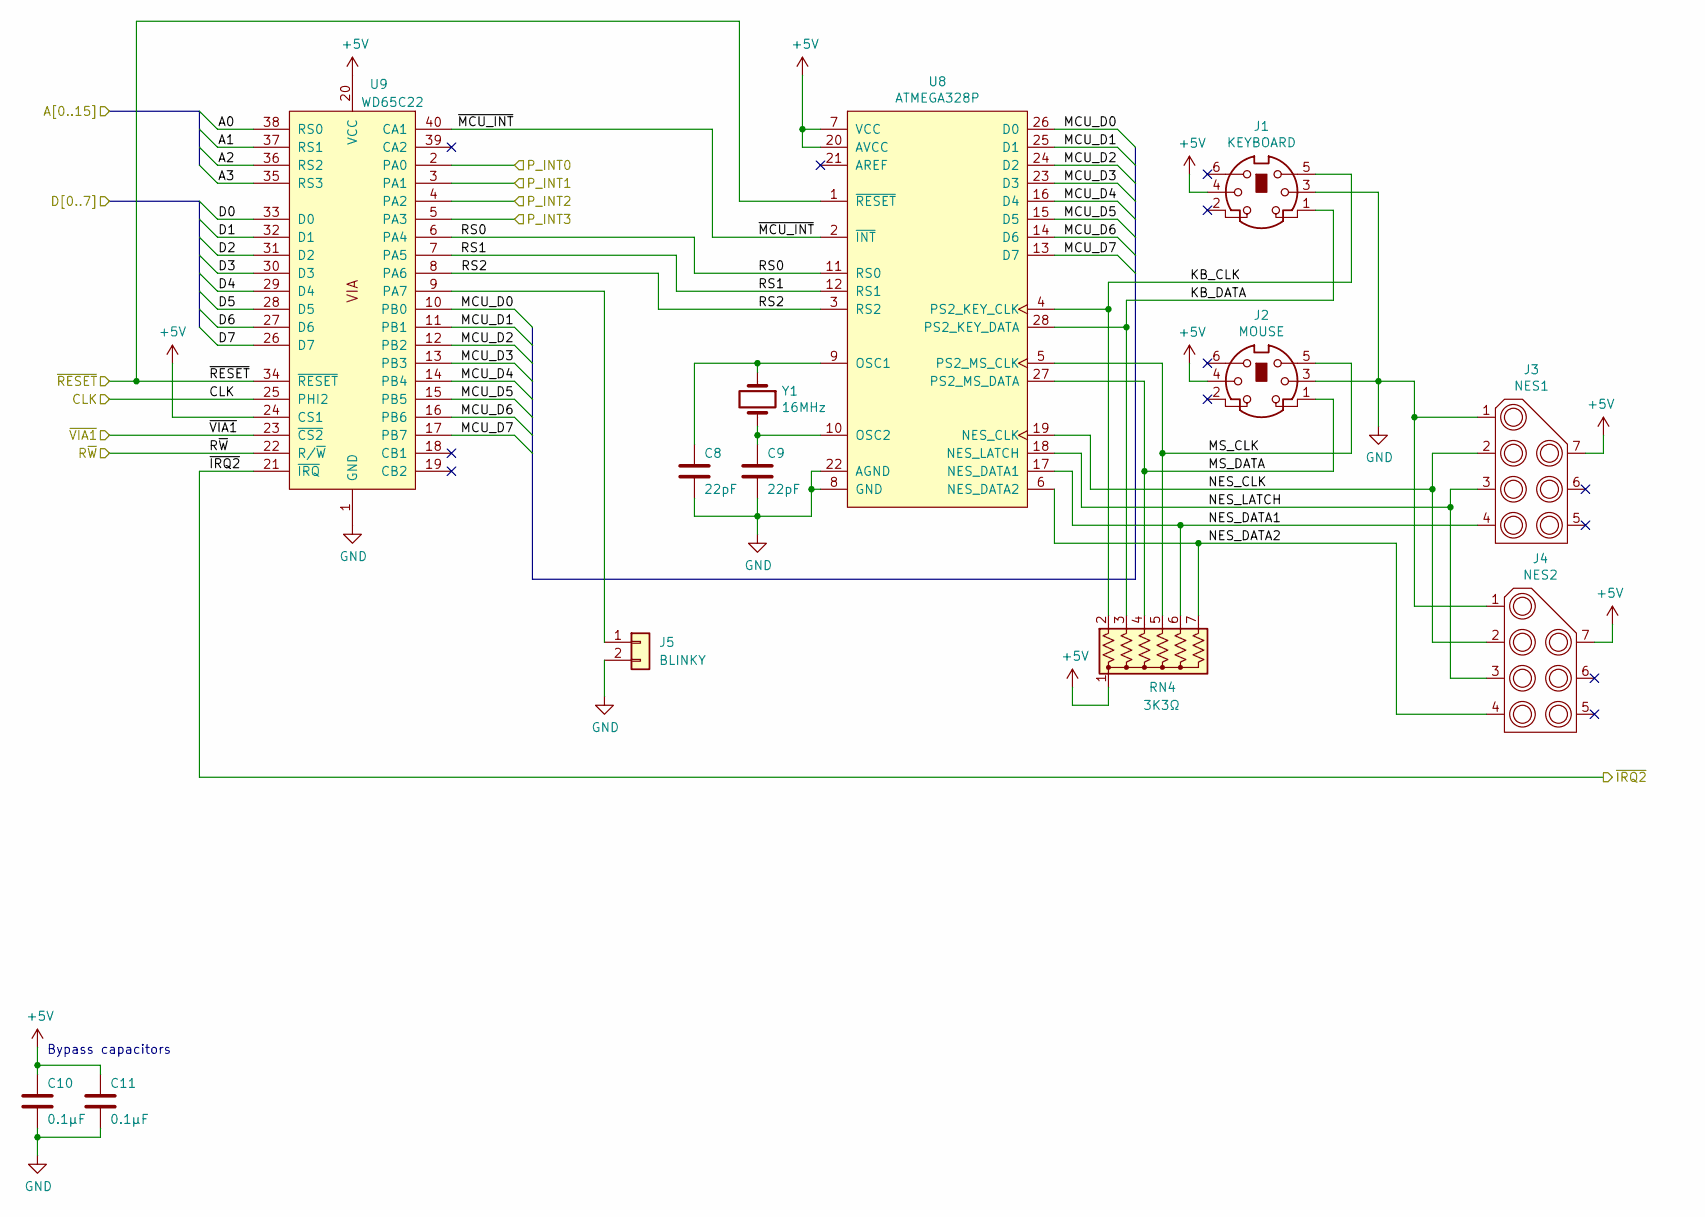
[picture p17: schematic VIA1_MCU.sch, VIA1 - Peripherals on MCU]

Parts:
C8, C9: 22pF; C_Disc_D3.0mm_W1.6mm_P2.50mm
C10, C11: 0.1µF; C_Disc_D3.0mm_W1.6mm_P2.50mm
J1: KEYBOARD; Mini-DIN_6p
J2: MOUSE; Mini-DIN_6p
J3: NES1; NES_Connector
J4: NES2; NES_Connector
J5: BLINKY; PinHeader_1x02_P2.54mm_Vertical
RN4: 3K3Ω; R_Array_SIP7
U8: ATMEGA328P; DIP-28_W7.62mm_Socket
U9: WD65C22; DIP-40_W15.24mm_Socket
Y1: 16MHz; Crystal_HC18-U_Vertical

Connections:
+5V: C10.1, C11.1, J1.4, J2.4, J3.7, J4.7, RN4.1 (common), U8.7 (VCC), U8.20 (AVCC), U9.20 (VCC), U9.24 (CS1); also elsewhere on the board
/ACIA/A0: U9.38 (RS0); also elsewhere on the board
/ACIA/A1: U9.37 (RS1); also elsewhere on the board
/ACIA/D0: U9.33 (D0); also elsewhere on the board
/ACIA/D1: U9.32 (D1); also elsewhere on the board
/ACIA/D2: U9.31 (D2); also elsewhere on the board
/ACIA/D3: U9.30 (D3); also elsewhere on the board
/ACIA/D4: U9.29 (D4); also elsewhere on the board
/ACIA/D5: U9.28 (D5); also elsewhere on the board
/ACIA/D6: U9.27 (D6); also elsewhere on the board
/ACIA/D7: U9.26 (D7); also elsewhere on the board
/Bus/A2: U9.36 (RS2); also elsewhere on the board
/Bus/A3: U9.35 (RS3); also elsewhere on the board
/CLK: U9.25 (PHI2); also elsewhere on the board
/P_INT0: U9.2 (PA0); also elsewhere on the board
/P_INT1: U9.3 (PA1); also elsewhere on the board
/P_INT2: U9.4 (PA2); also elsewhere on the board
/P_INT3: U9.5 (PA3); also elsewhere on the board
/R~W: U9.22 (R/~W); also elsewhere on the board
/VIA - Peripherals/KB_CLK: J1.5, RN4.2 (R1), U8.4 (PS2_KEY_CLK)
/VIA - Peripherals/KB_DATA: J1.1, RN4.3 (R2), U8.28 (PS2_KEY_DATA)
/VIA - Peripherals/MCU_D0: U8.26 (D0), U9.10 (PB0)
/VIA - Peripherals/MCU_D1: U8.25 (D1), U9.11 (PB1)
/VIA - Peripherals/MCU_D2: U8.24 (D2), U9.12 (PB2)
/VIA - Peripherals/MCU_D3: U8.23 (D3), U9.13 (PB3)
/VIA - Peripherals/MCU_D4: U8.16 (D4), U9.14 (PB4)
/VIA - Peripherals/MCU_D5: U8.15 (D5), U9.15 (PB5)
/VIA - Peripherals/MCU_D6: U8.14 (D6), U9.16 (PB6)
/VIA - Peripherals/MCU_D7: U8.13 (D7), U9.17 (PB7)
/VIA - Peripherals/MS_CLK: J2.5, RN4.5 (R4), U8.5 (PS2_MS_CLK)
/VIA - Peripherals/MS_DATA: J2.1, RN4.4 (R3), U8.27 (PS2_MS_DATA)
/VIA - Peripherals/NES_CLK: J3.2, J4.2, U8.19 (NES_CLK)
/VIA - Peripherals/NES_DATA1: J3.4, RN4.6 (R5), U8.17 (NES_DATA1)
/VIA - Peripherals/NES_DATA2: J4.4, RN4.7 (R6), U8.6 (NES_DATA2)
/VIA - Peripherals/NES_LATCH: J3.3, J4.3, U8.18 (NES_LATCH)
/VIA - Peripherals/RS0: U8.11 (RS0), U9.6 (PA4)
/VIA - Peripherals/RS1: U8.12 (RS1), U9.7 (PA5)
/VIA - Peripherals/RS2: U8.3 (RS2), U9.8 (PA6)
/VIA - Peripherals/~MCU_INT: U8.2 (~INT), U9.40 (CA1)
/~IRQ2: U9.21 (~IRQ); also elsewhere on the board
/~RESET: U8.1 (~RESET), U9.34 (~RESET); also elsewhere on the board
/~VIA1: U9.23 (~CS2); also elsewhere on the board
GND: C8.2, C9.2, C10.2, C11.2, J1.3, J2.3, J3.1, J4.1, J5.2, U8.8 (GND), U8.22 (AGND), U9.1 (GND); also elsewhere on the board
unnamed: C8.1, U8.9 (OSC1), Y1.1
unnamed: C9.1, U8.10 (OSC2), Y1.2
unnamed: J5.1, U9.9 (PA7)

Notes on the sheet:
Bypass capacitors

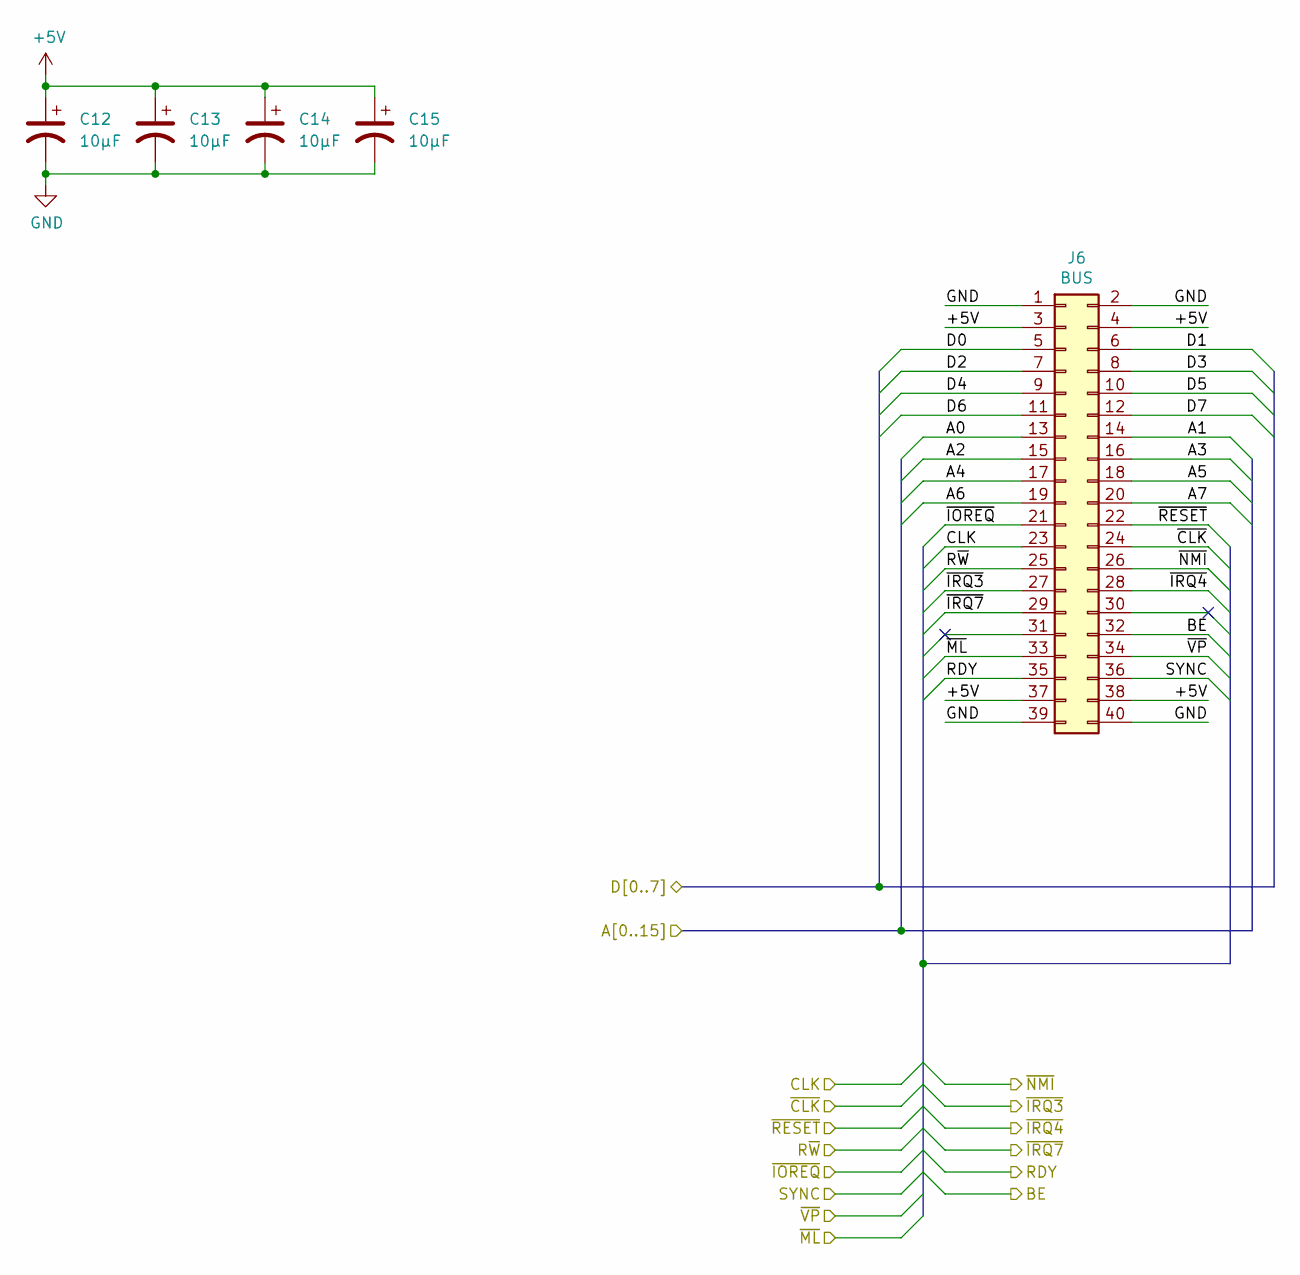
[picture p18: schematic Bus.sch, Expansion bus]

Parts:
C12, C13, C14, C15: 10µF; CP_Radial_D6.3mm_P2.50mm
J6: BUS; PinHeader_2x20_P2.54mm_Vertical

Connections:
+5V: C12.1, C13.1, C14.1, C15.1, J6.3, J6.4, J6.37, J6.38; also elsewhere on the board
/ACIA/A0: J6.13; also elsewhere on the board
/ACIA/A1: J6.14; also elsewhere on the board
/ACIA/D0: J6.5; also elsewhere on the board
/ACIA/D1: J6.6; also elsewhere on the board
/ACIA/D2: J6.7; also elsewhere on the board
/ACIA/D3: J6.8; also elsewhere on the board
/ACIA/D4: J6.9; also elsewhere on the board
/ACIA/D5: J6.10; also elsewhere on the board
/ACIA/D6: J6.11; also elsewhere on the board
/ACIA/D7: J6.12; also elsewhere on the board
/BE: J6.32; also elsewhere on the board
/Bus/A2: J6.15; also elsewhere on the board
/Bus/A3: J6.16; also elsewhere on the board
/Bus/A4: J6.17; also elsewhere on the board
/Bus/A5: J6.18; also elsewhere on the board
/Bus/A6: J6.19; also elsewhere on the board
/Bus/A7: J6.20; also elsewhere on the board
/CLK: J6.23; also elsewhere on the board
/RDY: J6.35; also elsewhere on the board
/R~W: J6.25; also elsewhere on the board
/SYNC: J6.36; also elsewhere on the board
/~CLK: J6.24; also elsewhere on the board
/~IOREQ: J6.21; also elsewhere on the board
/~IRQ3: J6.27; also elsewhere on the board
/~IRQ4: J6.28; also elsewhere on the board
/~IRQ7: J6.29; also elsewhere on the board
/~ML: J6.33; also elsewhere on the board
/~NMI: J6.26; also elsewhere on the board
/~RESET: J6.22; also elsewhere on the board
/~VP: J6.34; also elsewhere on the board
GND: C12.2, C13.2, C14.2, C15.2, J6.1, J6.2, J6.39, J6.40; also elsewhere on the board

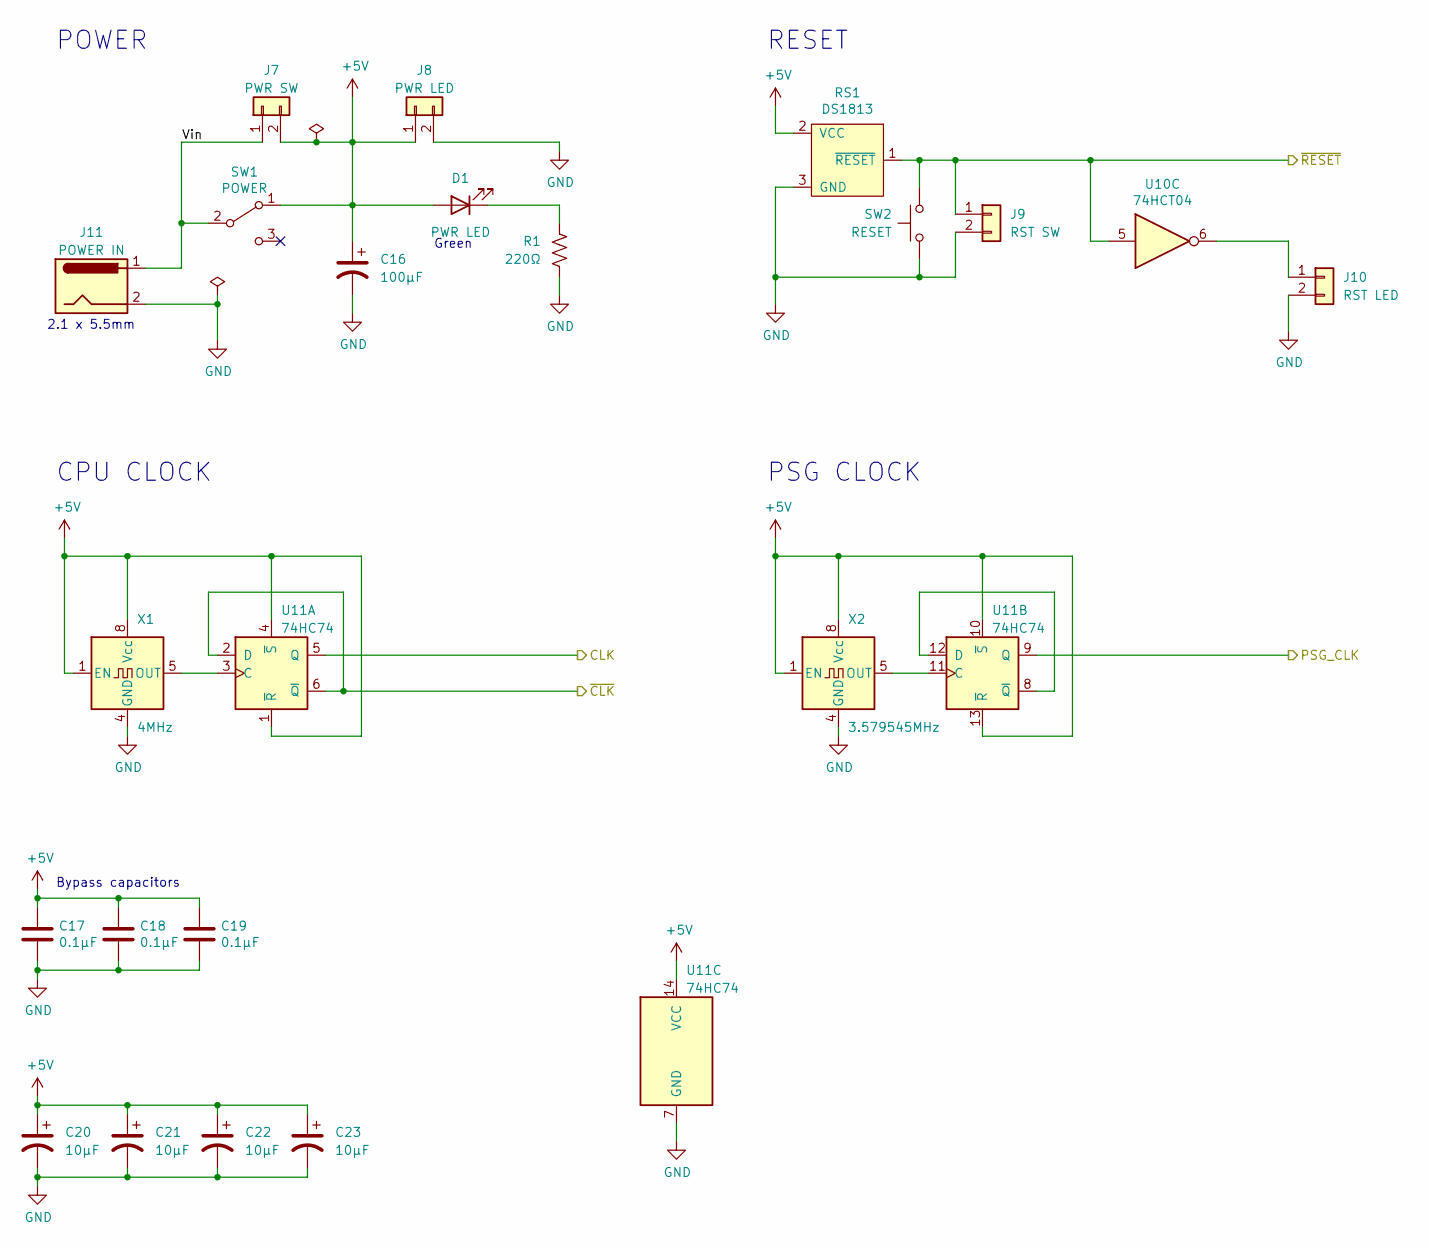
[picture p19: schematic PowerReset.sch, Power and Reset]

Parts:
C16: 100µF; CP_Radial_D8.0mm_P3.80mm
C17, C18, C19: 0.1µF; C_Disc_D3.0mm_W1.6mm_P2.50mm
C20, C21, C22, C23: 10µF; CP_Radial_D6.3mm_P2.50mm
D1: PWR LED; LED_D3.0mm
J7: PWR SW; PinHeader_1x02_P2.54mm_Vertical
J8: PWR LED; PinHeader_1x02_P2.54mm_Vertical
J9: RST SW; PinHeader_1x02_P2.54mm_Vertical
J10: RST LED; PinHeader_1x02_P2.54mm_Vertical
J11: POWER IN; BarrelJack_Horizontal
R1: 220Ω; R_Axial_DIN0207_L6.3mm_D2.5mm_P10.16mm_Horizontal
RS1: DS1813; TO-92L_Inline_Wide
SW1: POWER; Microswitch_3mm_spacing_2
SW2: RESET; SW_PUSH_6mm
U10: 74HCT04; DIP-14_W7.62mm_Socket
U11: 74HC74; DIP-14_W7.62mm_Socket
X1: 4MHz; Oscillator_DIP-8
X2: 3.579545MHz; Oscillator_DIP-8

Connections:
+5V: C16.1, C17.1, C18.1, C19.1, C20.1, C21.1, C22.1, C23.1, D1.2 (A), J7.2, J8.1, RS1.2 (VCC), SW1.1 (A), U11.1 (~R), U11.4 (~S), U11.10 (~S), U11.13 (~R), U11.14 (VCC), X1.1 (EN), X1.8 (Vcc), X2.1 (EN), X2.8 (Vcc); also elsewhere on the board
/CLK: U11.5 (Q); also elsewhere on the board
/PSG_CLK: U11.9 (Q); also elsewhere on the board
/Power, Reset & Clock/Vin: J7.1, J11.1, SW1.2 (B)
/~CLK: U11.2 (D), U11.6 (~Q); also elsewhere on the board
/~RESET: J9.1, RS1.1 (~RESET), SW2.1, U10.5; also elsewhere on the board
GND: C16.2, C17.2, C18.2, C19.2, C20.2, C21.2, C22.2, C23.2, J8.2, J9.2, J10.2, J11.2, R1.1, RS1.3 (GND), SW2.2, U11.7 (GND), X1.4 (GND), X2.4 (GND); also elsewhere on the board
unnamed: D1.1 (K), R1.2
unnamed: J10.1, U10.6
unnamed: U11.3 (C), X1.5 (OUT)
unnamed: U11.11 (C), X2.5 (OUT)
unnamed: U11.8 (~Q), U11.12 (D)

Notes on the sheet:
Bypass capacitors
RESET
CPU CLOCK
PSG CLOCK
POWER
Green
2.1 x 5.5mm
