FredericSegard/MH6502_v4/Schematic/Revision 4.kicad_pcb

## KiCad design Schematic/Revision 4.kicad_pcb (continued)

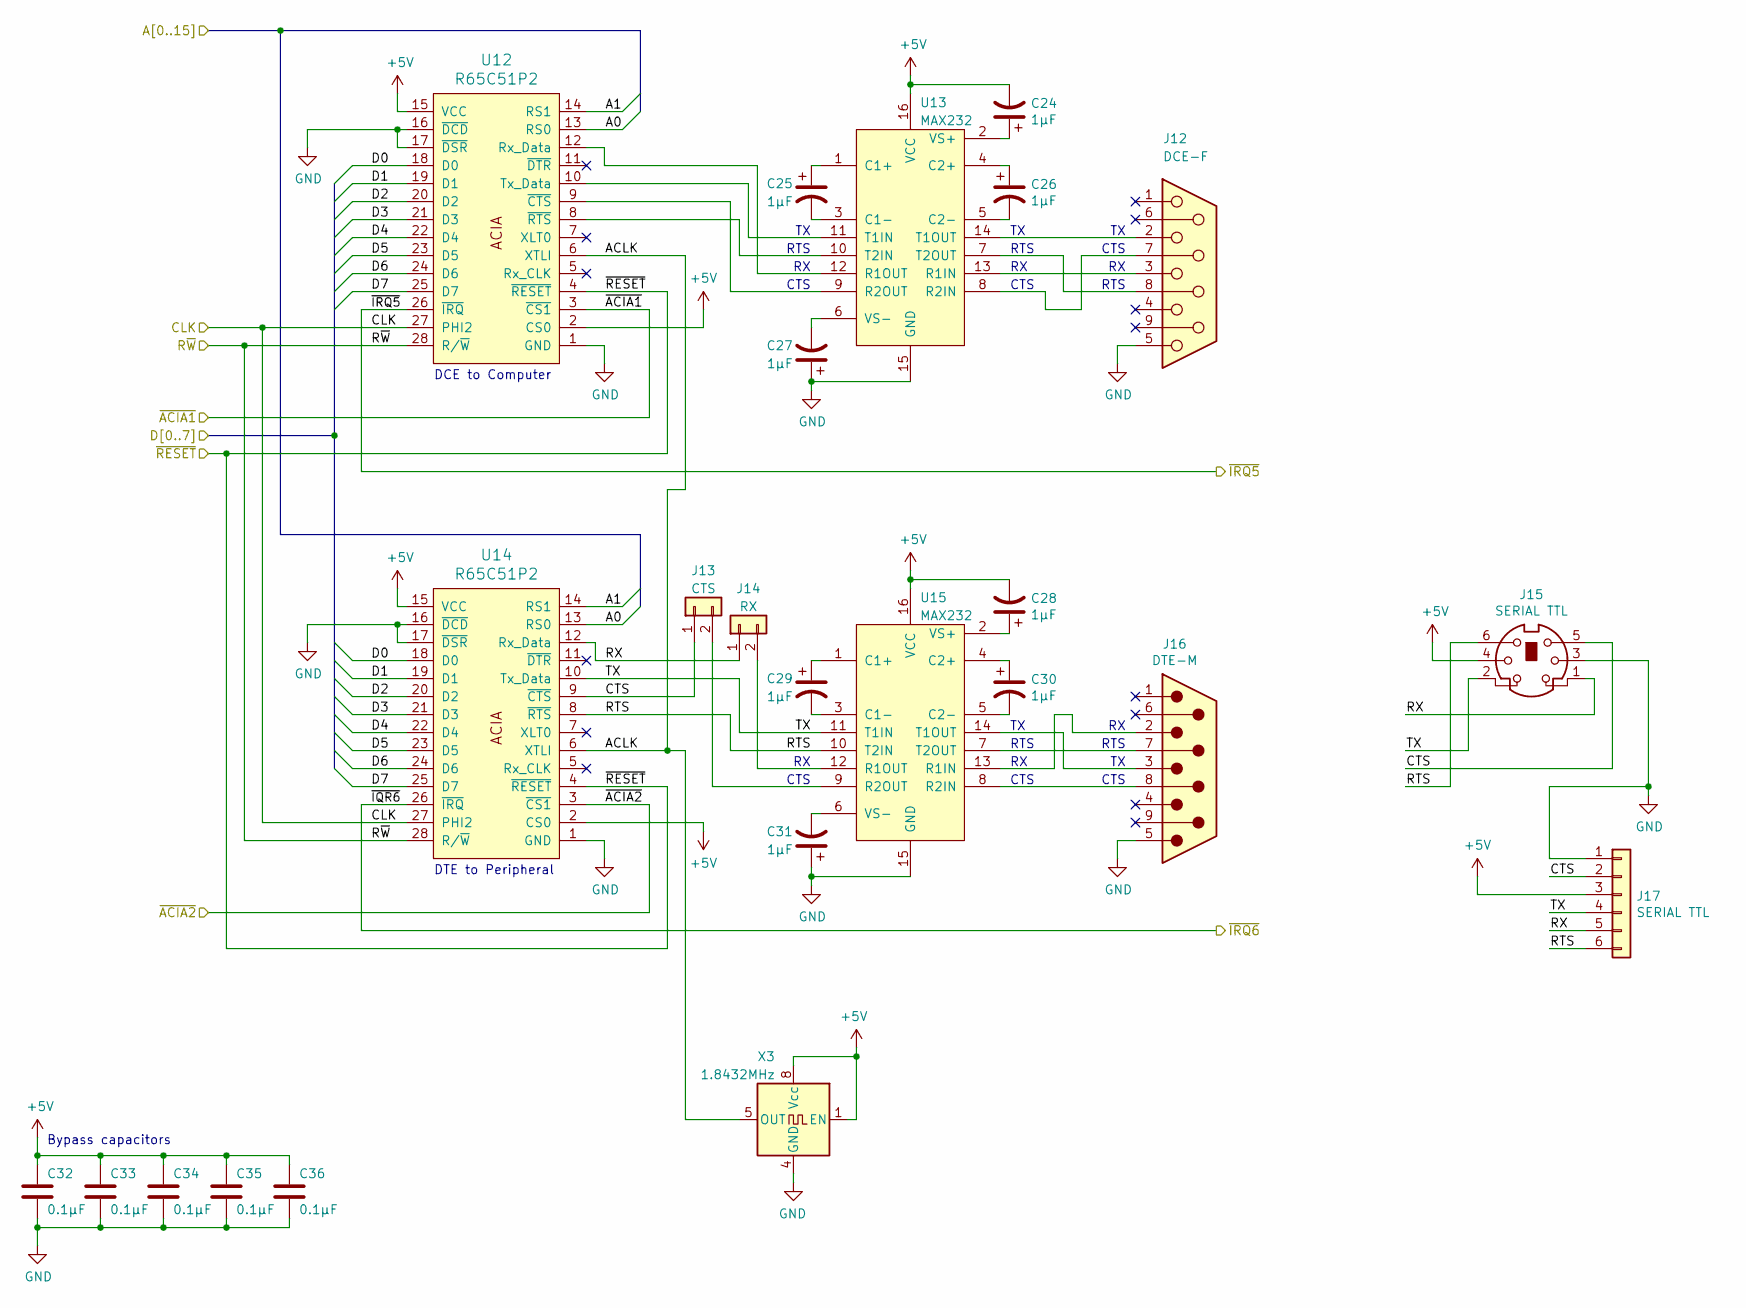
[picture p20: schematic ACIA1+2.sch, ACIA - DTE & DCE]

Parts:
C24, C25, C26, C27, C28, C29, C30, C31: 1µF; C_Disc_D3.0mm_W1.6mm_P2.50mm
C32, C33, C34, C35, C36: 0.1µF; C_Disc_D3.0mm_W1.6mm_P2.50mm
J12: DCE-F; DSUB-9_Female_Horizontal_P2.77x2.84mm_EdgePinOffset7.70mm_H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
J13: CTS; PinHeader_1x02_P2.54mm_Vertical
J14: RX; PinHeader_1x02_P2.54mm_Vertical
J15: SERIAL TTL; Mini-DIN_6p
J16: DTE-M; DSUB-9_Male_Horizontal_P2.77x2.84mm_EdgePinOffset7.70mm_Hou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
J17: SERIAL TTL; PinHeader_1x06_P2.54mm_Vertical
U12, U14: R65C51P2; DIP-28_W15.24mm_Socket
U13, U15: MAX232; DIP-16_W7.62mm_Socket
X3: 1.8432MHz; Oscillator_DIP-8

Connections:
+5V: C24.2, C28.2, C32.1, C33.1, C34.1, C35.1, C36.1, J15.4, J17.3, U12.2 (CS0), U12.15 (VCC), U13.16 (VCC), U14.2 (CS0), U14.15 (VCC), U15.16 (VCC), X3.1 (EN), X3.8 (Vcc); also elsewhere on the board
/ACIA/A0: U12.13 (RS0), U14.13 (RS0); also elsewhere on the board
/ACIA/A1: U12.14 (RS1), U14.14 (RS1); also elsewhere on the board
/ACIA/ACLK: U12.6 (XTLI), U14.6 (XTLI), X3.5 (OUT)
/ACIA/CTS: J13.1, J15.5, J17.2, U14.9 (~CTS)
/ACIA/D0: U12.18 (D0), U14.18 (D0); also elsewhere on the board
/ACIA/D1: U12.19 (D1), U14.19 (D1); also elsewhere on the board
/ACIA/D2: U12.20 (D2), U14.20 (D2); also elsewhere on the board
/ACIA/D3: U12.21 (D3), U14.21 (D3); also elsewhere on the board
/ACIA/D4: U12.22 (D4), U14.22 (D4); also elsewhere on the board
/ACIA/D5: U12.23 (D5), U14.23 (D5); also elsewhere on the board
/ACIA/D6: U12.24 (D6), U14.24 (D6); also elsewhere on the board
/ACIA/D7: U12.25 (D7), U14.25 (D7); also elsewhere on the board
/ACIA/RTS: J15.6, J17.6, U14.8 (~RTS), U15.10 (T2IN)
/ACIA/RX: J14.1, J15.1, J17.5, U14.12 (Rx_Data)
/ACIA/TX: J15.2, J17.4, U14.10 (Tx_Data), U15.11 (T1IN)
/CLK: U12.27 (PHI2), U14.27 (PHI2); also elsewhere on the board
/R~W: U12.28 (R/~W), U14.28 (R/~W); also elsewhere on the board
/~ACIA1: U12.3 (~CS1); also elsewhere on the board
/~ACIA2: U14.3 (~CS1); also elsewhere on the board
/~IRQ5: U12.26 (~IRQ); also elsewhere on the board
/~IRQ6: U14.26 (~IRQ); also elsewhere on the board
/~RESET: U12.4 (~RESET), U14.4 (~RESET); also elsewhere on the board
GND: C27.1, C31.1, C32.2, C33.2, C34.2, C35.2, C36.2, J12.5, J15.3, J16.5, J17.1, U12.1 (GND), U12.16 (~DCD), U12.17 (~DSR), U13.15 (GND), U14.1 (GND), U14.16 (~DCD), U14.17 (~DSR), U15.15 (GND), X3.4 (GND); also elsewhere on the board
unnamed: C24.1, U13.2 (VS+)
unnamed: C25.1, U13.1 (C1+)
unnamed: C25.2, U13.3 (C1-)
unnamed: C26.1, U13.4 (C2+)
unnamed: C26.2, U13.5 (C2-)
unnamed: C27.2, U13.6 (VS-)
unnamed: C28.1, U15.2 (VS+)
unnamed: C29.1, U15.1 (C1+)
unnamed: C29.2, U15.3 (C1-)
unnamed: C30.1, U15.4 (C2+)
unnamed: C30.2, U15.5 (C2-)
unnamed: C31.2, U15.6 (VS-)
unnamed: J12.2, U13.14 (T1OUT)
unnamed: J12.3, U13.13 (R1IN)
unnamed: J12.7, U13.8 (R2IN)
unnamed: J12.8, U13.7 (T2OUT)
unnamed: J13.2, U15.9 (R2OUT)
unnamed: J14.2, U15.12 (R1OUT)
unnamed: J16.2, U15.13 (R1IN)
unnamed: J16.3, U15.14 (T1OUT)
unnamed: J16.7, U15.7 (T2OUT)
unnamed: J16.8, U15.8 (R2IN)
unnamed: U12.8 (~RTS), U13.10 (T2IN)
unnamed: U12.9 (~CTS), U13.9 (R2OUT)
unnamed: U12.10 (Tx_Data), U13.11 (T1IN)
unnamed: U12.12 (Rx_Data), U13.12 (R1OUT)

Notes on the sheet:
RTS
CTS
DCE to Computer
DTE to Peripheral
Bypass capacitors

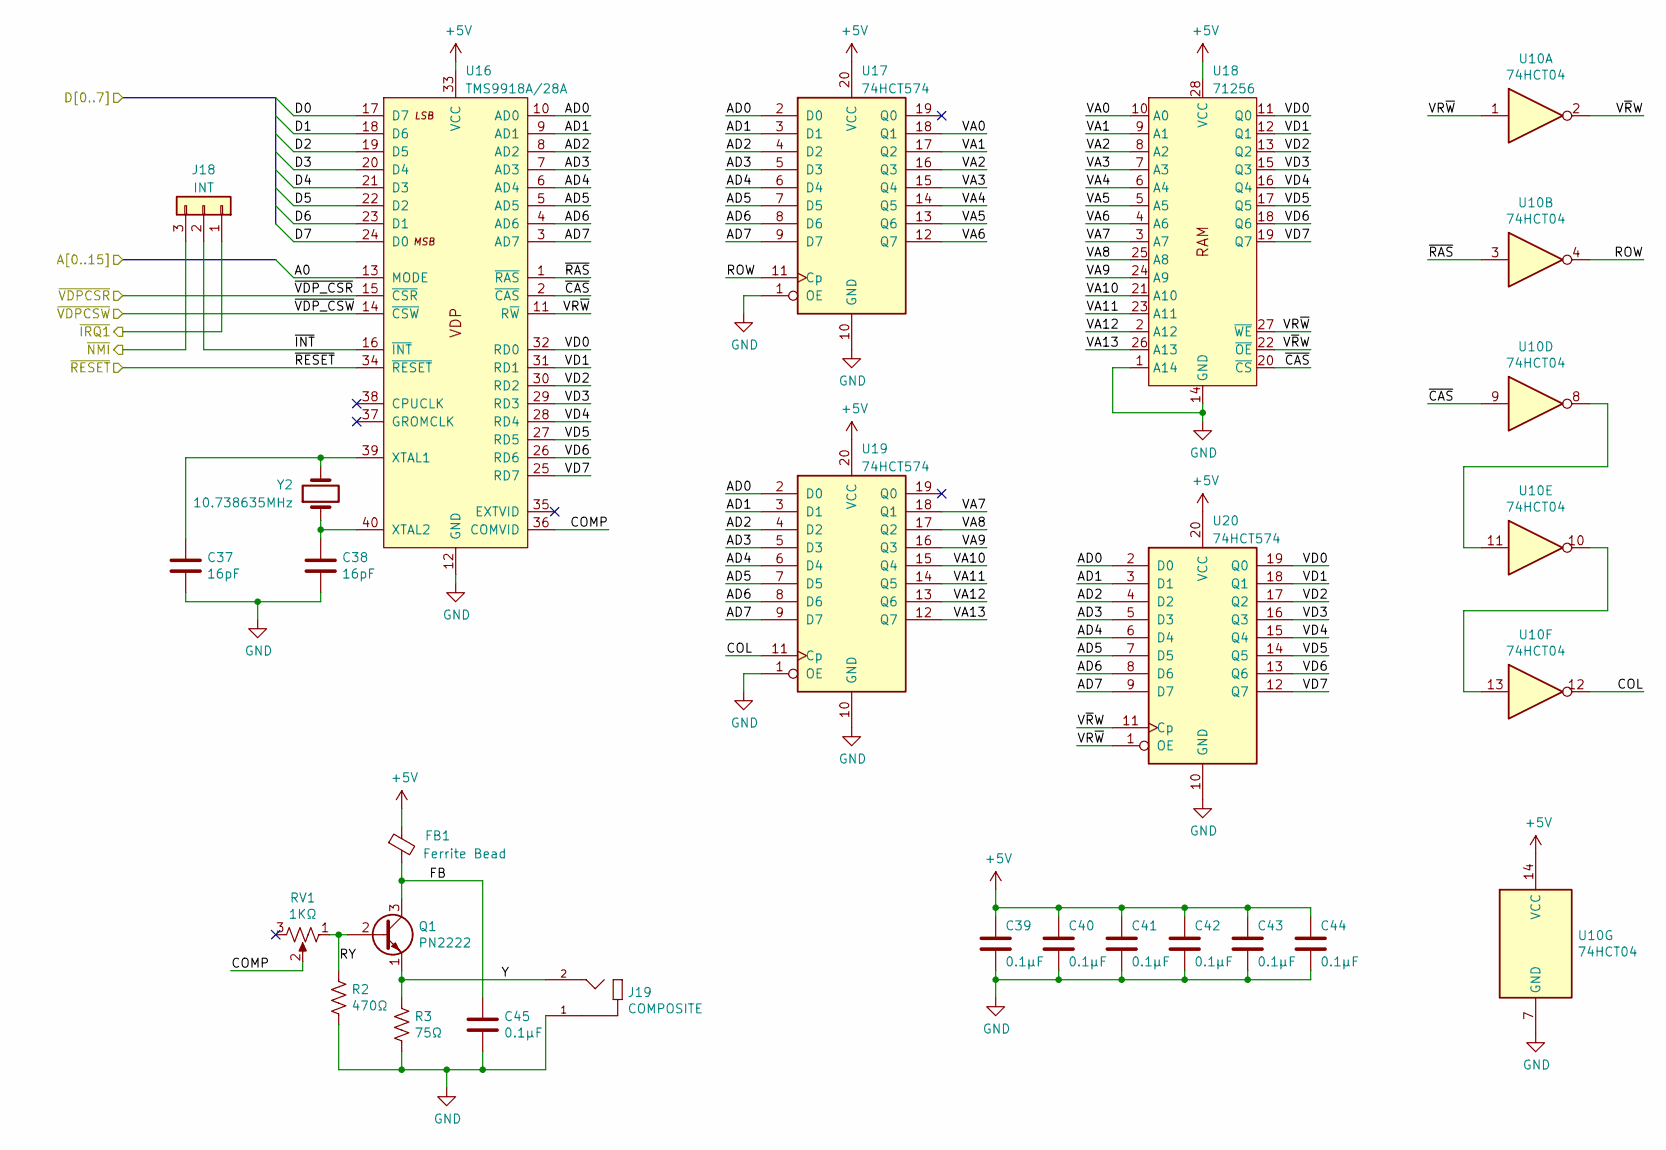
[picture p21: schematic Video.sch]

Parts:
C37, C38: 16pF; C_Disc_D3.4mm_W2.1mm_P2.50mm
C39, C40, C41, C42, C43, C44, C45: 0.1µF; C_Disc_D3.0mm_W1.6mm_P2.50mm
FB1: Ferrite Bead; L_Axial_L5.3mm_D2.2mm_P10.16mm_Horizontal_Vishay_IM-1
J18: INT; PinHeader_1x03_P2.54mm_Vertical
J19: COMPOSITE; RCAJackCUI
Q1: PN2222; TO-92L_Inline_Wide
R2: 470Ω; R_Axial_DIN0207_L6.3mm_D2.5mm_P10.16mm_Horizontal
R3: 75Ω; R_Axial_DIN0207_L6.3mm_D2.5mm_P10.16mm_Horizontal
RV1: 1KΩ; Potentiometer_Bourns_3296W_Vertical
U10: 74HCT04; DIP-14_W7.62mm_Socket
U16: TMS9918A/28A; DIP-40_W15.24mm_Socket
U17, U19, U20: 74HCT574; DIP-20_W7.62mm_Socket
U18: 71256; DIP-28_W7.62mm_Socket
Y2: 10.738635MHz; Crystal_HC18-U_Vertical

Connections:
+5V: C39.1, C40.1, C41.1, C42.1, C43.1, C44.1, FB1.1, U10.14 (VCC), U16.33 (VCC), U17.20 (VCC), U18.28 (VCC), U19.20 (VCC), U20.20 (VCC); also elsewhere on the board
/ACIA/A0: U16.13 (MODE); also elsewhere on the board
/ACIA/D0: U16.17 (D7); also elsewhere on the board
/ACIA/D1: U16.18 (D6); also elsewhere on the board
/ACIA/D2: U16.19 (D5); also elsewhere on the board
/ACIA/D3: U16.20 (D4); also elsewhere on the board
/ACIA/D4: U16.21 (D3); also elsewhere on the board
/ACIA/D5: U16.22 (D2); also elsewhere on the board
/ACIA/D6: U16.23 (D1); also elsewhere on the board
/ACIA/D7: U16.24 (D0); also elsewhere on the board
/Video/AD0: U16.10 (AD0), U17.2 (D0), U19.2 (D0), U20.2 (D0)
/Video/AD1: U16.9 (AD1), U17.3 (D1), U19.3 (D1), U20.3 (D1)
/Video/AD2: U16.8 (AD2), U17.4 (D2), U19.4 (D2), U20.4 (D2)
/Video/AD3: U16.7 (AD3), U17.5 (D3), U19.5 (D3), U20.5 (D3)
/Video/AD4: U16.6 (AD4), U17.6 (D4), U19.6 (D4), U20.6 (D4)
/Video/AD5: U16.5 (AD5), U17.7 (D5), U19.7 (D5), U20.7 (D5)
/Video/AD6: U16.4 (AD6), U17.8 (D6), U19.8 (D6), U20.8 (D6)
/Video/AD7: U16.3 (AD7), U17.9 (D7), U19.9 (D7), U20.9 (D7)
/Video/COL: U10.12, U19.11 (Cp)
/Video/COMP: RV1.2, U16.36 (COMVID)
/Video/FB: C45.1, FB1.2, Q1.3 (C)
/Video/ROW: U10.4, U17.11 (Cp)
/Video/RY: Q1.2 (B), R2.1, RV1.1
/Video/VA0: U17.18 (Q1), U18.10 (A0)
/Video/VA1: U17.17 (Q2), U18.9 (A1)
/Video/VA2: U17.16 (Q3), U18.8 (A2)
/Video/VA3: U17.15 (Q4), U18.7 (A3)
/Video/VA4: U17.14 (Q5), U18.6 (A4)
/Video/VA5: U17.13 (Q6), U18.5 (A5)
/Video/VA6: U17.12 (Q7), U18.4 (A6)
/Video/VA7: U18.3 (A7), U19.18 (Q1)
/Video/VA8: U18.25 (A8), U19.17 (Q2)
/Video/VA9: U18.24 (A9), U19.16 (Q3)
/Video/VA10: U18.21 (A10), U19.15 (Q4)
/Video/VA11: U18.23 (A11), U19.14 (Q5)
/Video/VA12: U18.2 (A12), U19.13 (Q6)
/Video/VA13: U18.26 (A13), U19.12 (Q7)
/Video/VD0: U16.32 (RD0), U18.11 (Q0), U20.19 (Q0)
/Video/VD1: U16.31 (RD1), U18.12 (Q1), U20.18 (Q1)
/Video/VD2: U16.30 (RD2), U18.13 (Q2), U20.17 (Q2)
/Video/VD3: U16.29 (RD3), U18.15 (Q3), U20.16 (Q3)
/Video/VD4: U16.28 (RD4), U18.16 (Q4), U20.15 (Q4)
/Video/VD5: U16.27 (RD5), U18.17 (Q5), U20.14 (Q5)
/Video/VD6: U16.26 (RD6), U18.18 (Q6), U20.13 (Q6)
/Video/VD7: U16.25 (RD7), U18.19 (Q7), U20.12 (Q7)
/Video/VR~W: U10.1, U16.11 (R~W), U18.27 (~WE), U20.1 (OE)
/Video/V~R~W: U10.2, U18.22 (~OE), U20.11 (Cp)
/Video/Y: J19.2, Q1.1 (E), R3.1
/Video/~CAS: U10.9, U16.2 (~CAS), U18.20 (~CS)
/Video/~INT: J18.2, U16.16 (~INT)
/Video/~RAS: U10.3, U16.1 (~RAS)
/~IRQ1: J18.1; also elsewhere on the board
/~NMI: J18.3; also elsewhere on the board
/~RESET: U16.34 (~RESET); also elsewhere on the board
/~VDPCSR: U16.15 (~CSR); also elsewhere on the board
/~VDPCSW: U16.14 (~CSW); also elsewhere on the board
GND: C37.2, C38.2, C39.2, C40.2, C41.2, C42.2, C43.2, C44.2, C45.2, J19.1, R2.2, R3.2, U10.7 (GND), U16.12 (GND), U17.1 (OE), U17.10 (GND), U18.1 (A14), U18.14 (GND), U19.1 (OE), U19.10 (GND), U20.10 (GND); also elsewhere on the board
unnamed: C37.1, U16.39 (XTAL1), Y2.2
unnamed: C38.1, U16.40 (XTAL2), Y2.1
unnamed: U10.10, U10.13
unnamed: U10.8, U10.11

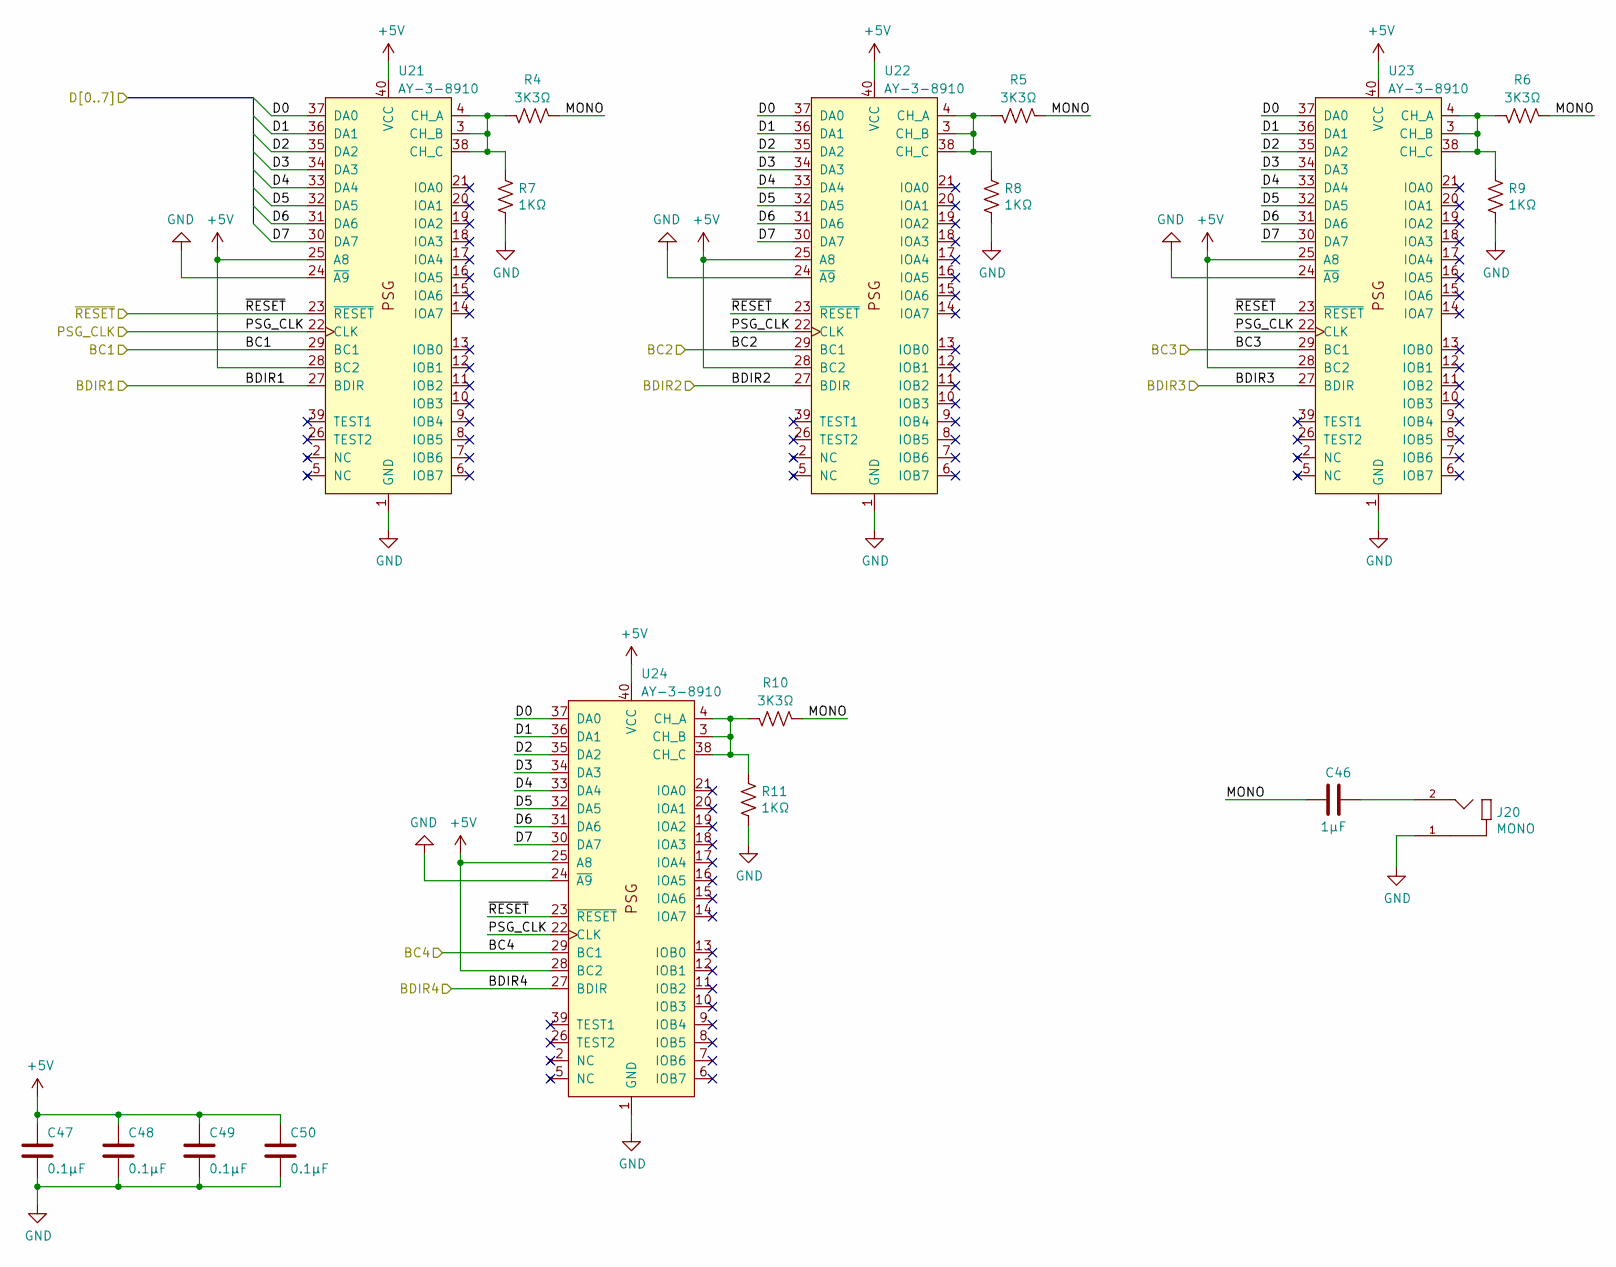
[picture p22: schematic Sound.sch]

Parts:
C46: 1µF; C_Disc_D3.0mm_W1.6mm_P2.50mm
C47, C48, C49, C50: 0.1µF; C_Disc_D3.0mm_W1.6mm_P2.50mm
J20: MONO; RCAJackCUI
R4, R5, R6, R10: 3K3Ω; R_Axial_DIN0207_L6.3mm_D2.5mm_P10.16mm_Horizontal
R7, R8, R9, R11: 1KΩ; R_Axial_DIN0207_L6.3mm_D2.5mm_P10.16mm_Horizontal
U21, U22, U23, U24: AY-3-8910; DIP-40_W15.24mm_Socket

Connections:
+5V: C47.1, C48.1, C49.1, C50.1, U21.25 (A8), U21.28 (BC2), U21.40 (VCC), U22.25 (A8), U22.28 (BC2), U22.40 (VCC), U23.25 (A8), U23.28 (BC2), U23.40 (VCC), U24.25 (A8), U24.28 (BC2), U24.40 (VCC); also elsewhere on the board
/ACIA/D0: U21.37 (DA0), U22.37 (DA0), U23.37 (DA0), U24.37 (DA0); also elsewhere on the board
/ACIA/D1: U21.36 (DA1), U22.36 (DA1), U23.36 (DA1), U24.36 (DA1); also elsewhere on the board
/ACIA/D2: U21.35 (DA2), U22.35 (DA2), U23.35 (DA2), U24.35 (DA2); also elsewhere on the board
/ACIA/D3: U21.34 (DA3), U22.34 (DA3), U23.34 (DA3), U24.34 (DA3); also elsewhere on the board
/ACIA/D4: U21.33 (DA4), U22.33 (DA4), U23.33 (DA4), U24.33 (DA4); also elsewhere on the board
/ACIA/D5: U21.32 (DA5), U22.32 (DA5), U23.32 (DA5), U24.32 (DA5); also elsewhere on the board
/ACIA/D6: U21.31 (DA6), U22.31 (DA6), U23.31 (DA6), U24.31 (DA6); also elsewhere on the board
/ACIA/D7: U21.30 (DA7), U22.30 (DA7), U23.30 (DA7), U24.30 (DA7); also elsewhere on the board
/BC1: U21.29 (BC1); also elsewhere on the board
/BC2: U22.29 (BC1); also elsewhere on the board
/BC3: U23.29 (BC1); also elsewhere on the board
/BC4: U24.29 (BC1); also elsewhere on the board
/BDIR1: U21.27 (BDIR); also elsewhere on the board
/BDIR2: U22.27 (BDIR); also elsewhere on the board
/BDIR3: U23.27 (BDIR); also elsewhere on the board
/BDIR4: U24.27 (BDIR); also elsewhere on the board
/PSG_CLK: U21.22 (CLK), U22.22 (CLK), U23.22 (CLK), U24.22 (CLK); also elsewhere on the board
/Sound/MONO: C46.2, R4.2, R5.2, R6.2, R10.2
/~RESET: U21.23 (~RESET), U22.23 (~RESET), U23.23 (~RESET), U24.23 (~RESET); also elsewhere on the board
GND: C47.2, C48.2, C49.2, C50.2, J20.1, R7.1, R8.1, R9.1, R11.1, U21.1 (GND), U21.24 (~A9), U22.1 (GND), U22.24 (~A9), U23.1 (GND), U23.24 (~A9), U24.1 (GND), U24.24 (~A9); also elsewhere on the board
unnamed: C46.1, J20.2
unnamed: R4.1, R7.2, U21.3 (CH_B), U21.4 (CH_A), U21.38 (CH_C)
unnamed: R5.1, R8.2, U22.3 (CH_B), U22.4 (CH_A), U22.38 (CH_C)
unnamed: R6.1, R9.2, U23.3 (CH_B), U23.4 (CH_A), U23.38 (CH_C)
unnamed: R10.1, R11.2, U24.3 (CH_B), U24.4 (CH_A), U24.38 (CH_C)

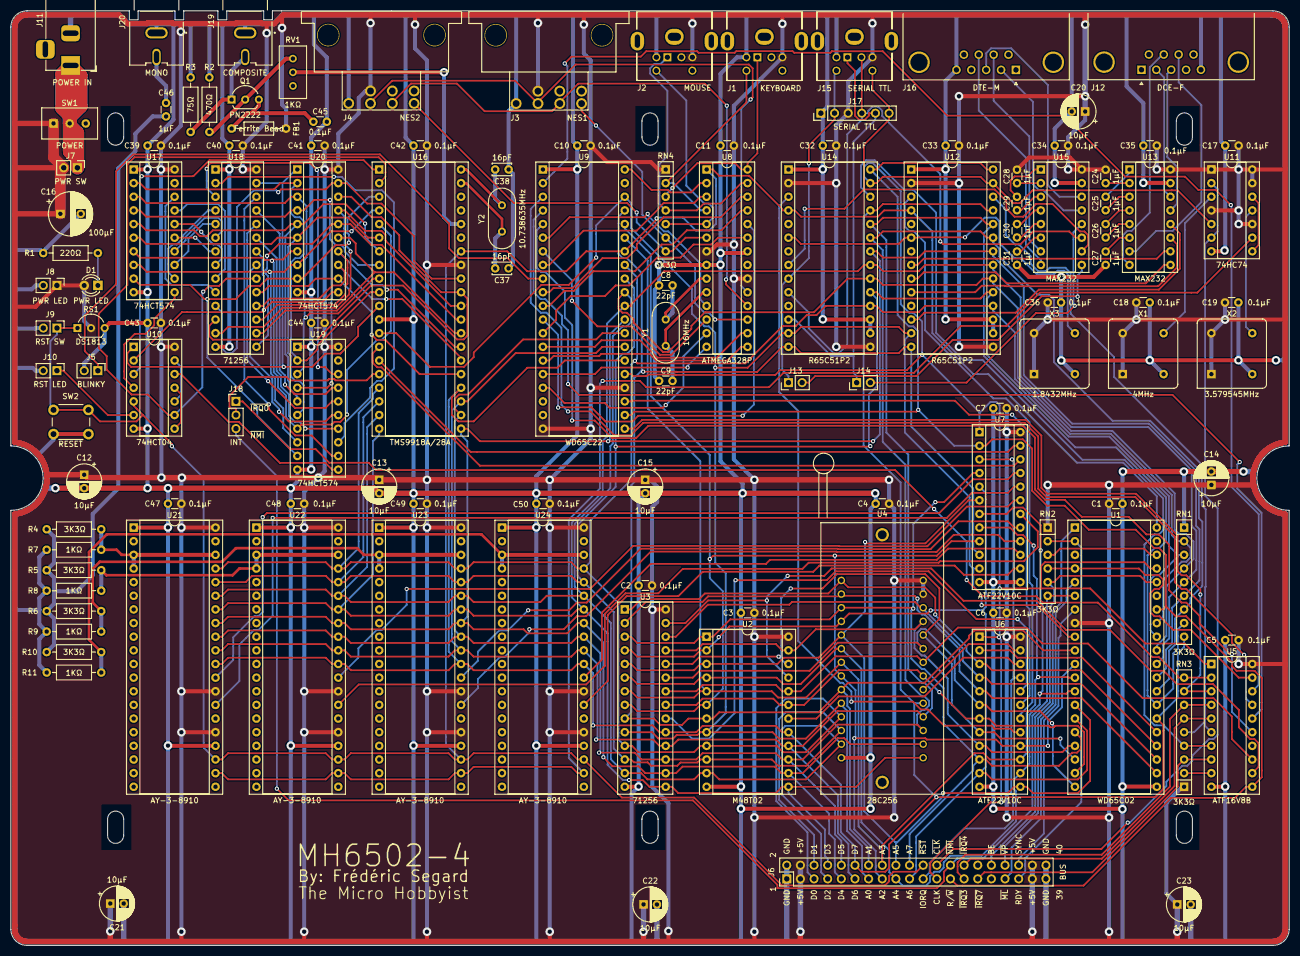
[picture p23: board Revision 4.kicad_pcb from above]

Board: 2 copper layers, 238.0 x 174.0 mm, 121 parts (0 on the bottom side), 181 nets.
