FredericSegard/MH6502_v4/Code/Monkey.asm

;  __  __                   _                       ___         _                       _ 
; |  \/  |   ___    _ __   | | __   ___   _   _    |_ _|  ___  | |   __ _   _ __     __| |
; | |\/| |  / _ \  | '_ \  | |/ /  / _ \ | | | |    | |  / __| | |  / _` | | '_ \   / _` |
; | |  | | | (_) | | | | | |   <  |  __/ | |_| |    | |  \__ \ | | | (_| | | | | | | (_| |
; |_|  |_|  \___/  |_| |_| |_|\_\  \___|  \__, |   |___| |___/ |_|  \__,_| |_| |_|  \__,_|
;                                         |___/                                           

; Monkey Island Song
; ----------------------------------------------------------------------------------------------------------------------

play_monkey_island_song:
	lda	#18			; Load tempo
	sta	PSG_TEMPO

	ldx	#<monkey_island		; Get LSB address
	ldy	#>monkey_island		; Get MSB address
	jsr	play_tune		; 
	
	rts

; ----------------------------------------------------------------------------------------------------------------------

monkey_island:
	; Voice 1-2 = Panflote 5
	; Voice 3-4 = Marimba 4
	; Voice 5-7 = Steel Drum 3
	; Voice 8 = Elektrischer Bass 2
	
	; 22:1	 Voice    Note   Vol   Dur
	.word	(VOICE8 | E2),  (MID | EIGHTH)
	.word	(VOICE8 | XX),  (OFF | PAUSE)

	; 22:2	 Voice    Note   Vol   Dur
	.word	(VOICE5 | B3),  (MID | NONE)
	.word	(VOICE6 | G3),  (MID | NONE)
	.word	(VOICE7 | E3),  (MID | NONE)
	.word	(VOICE8 | E2),  (MID | SIXTEENTH)
	.word	(VOICE5 | XX),  (OFF | NONE)
	.word	(VOICE6 | XX),  (OFF | NONE)
	.word	(VOICE7 | XX),  (OFF | NONE)
	.word	(VOICE8 | XX),  (OFF | PAUSE)

	; 22:3	 Voice    Note   Vol   Dur
	.word	(VOICE5 | B3),  (MID | NONE)
	.word	(VOICE6 | G3),  (MID | NONE)
	.word	(VOICE7 | E3),  (MID | NONE)
	.word	(VOICE8 | E2),  (MID | SIXTEENTH)
	.word	(VOICE5 | XX),  (OFF | NONE)
	.word	(VOICE6 | XX),  (OFF | NONE)
	.word	(VOICE7 | XX),  (OFF | NONE)
	.word	(VOICE8 | XX),  (OFF | EIGHTH)

	; 22:4	 Voice    Note   Vol   Dur
	.word	(VOICE5 | B3),  (MID | NONE)
	.word	(VOICE6 | G3),  (MID | NONE)
	.word	(VOICE7 | E3),  (MID | SIXTEENTH)
	.word	(VOICE5 | XX),  (OFF | NONE)
	.word	(VOICE6 | XX),  (OFF | NONE)
	.word	(VOICE7 | XX),  (OFF | NONE)
	.word	(VOICE8 | XX),  (OFF | PAUSE)

	; 22:5	 Voice    Note   Vol   Dur
	.word	(VOICE5 | B3),  (MID | NONE)
	.word	(VOICE6 | G3),  (MID | NONE)
	.word	(VOICE7 | E3),  (MID | NONE)
	.word	(VOICE8 | E2),  (MID | SIXTEENTH)
	.word	(VOICE5 | XX),  (OFF | NONE)
	.word	(VOICE6 | XX),  (OFF | NONE)
	.word	(VOICE7 | XX),  (OFF | EIGHTH)

	; 22:6	 Voice    Note   Vol   Dur
	.word	(VOICE5 | A3),  (MID | NONE)
	.word	(VOICE6 | Fs3), (MID | NONE)
	.word	(VOICE7 | D3),  (MID | NONE)
	.word	(VOICE8 | D2),  (MID | SIXTEENTH)
	.word	(VOICE5 | XX),  (OFF | NONE)
	.word	(VOICE6 | XX),  (OFF | NONE)
	.word	(VOICE7 | XX),  (OFF | NONE)
	.word	(VOICE8 | XX),  (OFF | PAUSE)

	; 22:7	 Voice    Note   Vol   Dur
	.word	(VOICE5 | A3),  (MID | NONE)
	.word	(VOICE6 | Fs3), (MID | NONE)
	.word	(VOICE7 | D3),  (MID | NONE)
	.word	(VOICE8 | D2),  (MID | SIXTEENTH)
	.word	(VOICE5 | XX),  (OFF | NONE)
	.word	(VOICE6 | XX),  (OFF | NONE)
	.word	(VOICE7 | XX),  (OFF | NONE)
	.word	(VOICE8 | XX),  (OFF | PAUSE)

	; 23:1	 Voice    Note   Vol   Dur
	.word	(VOICE8 | E2),  (MID | EIGHTH)
	.word	(VOICE8 | XX),  (OFF | PAUSE)

	; 23:2	 Voice    Note   Vol   Dur
	.word	(VOICE5 | B3),  (MID | NONE)
	.word	(VOICE6 | G3),  (MID | NONE)
	.word	(VOICE7 | E3),  (MID | NONE)
	.word	(VOICE8 | E2),  (MID | SIXTEENTH)
	.word	(VOICE5 | XX),  (OFF | NONE)
	.word	(VOICE6 | XX),  (OFF | NONE)
	.word	(VOICE7 | XX),  (OFF | NONE)
	.word	(VOICE8 | XX),  (OFF | PAUSE)

	; 23:3	 Voice    Note   Vol   Dur
	.word	(VOICE5 | B3),  (MID | NONE)
	.word	(VOICE6 | G3),  (MID | NONE)
	.word	(VOICE7 | E3),  (MID | NONE)
	.word	(VOICE8 | E2),  (MID | SIXTEENTH)
	.word	(VOICE5 | XX),  (OFF | NONE)
	.word	(VOICE6 | XX),  (OFF | NONE)
	.word	(VOICE7 | XX),  (OFF | NONE)
	.word	(VOICE8 | XX),  (OFF | EIGHTH)

	; 23:4	 Voice    Note   Vol   Dur
	.word	(VOICE5 | B3),  (MID | NONE)
	.word	(VOICE6 | G3),  (MID | NONE)
	.word	(VOICE7 | E3),  (MID | SIXTEENTH)
	.word	(VOICE5 | XX),  (OFF | NONE)
	.word	(VOICE6 | XX),  (OFF | NONE)
	.word	(VOICE7 | XX),  (OFF | PAUSE)

	; 23:5	 Voice    Note   Vol   Dur
	.word	(VOICE5 | B3),  (MID | NONE)
	.word	(VOICE6 | G3),  (MID | NONE)
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
	.word	(VOICE1 | XX),  (OFF | NONE)
	.word	(VOICE3 | XX),  (OFF | NONE)
	.word	(VOICE5 | XX),  (OFF | NONE)
	.word	(VOICE6 | XX),  (OFF | NONE)
	.word	(VOICE7 | XX),  (OFF | NONE)
	.word	(VOICE8 | XX),  (OFF | PAUSE)
	
	; 31:6	 Voice    Note   Vol   Dur
	.word	(VOICE1 | D5),  (MID | NONE)
	.word	(VOICE3 | D4),  (MID | NONE)
	.word	(VOICE5 | G3),  (MID | NONE)
	.word	(VOICE6 | D3),  (MID | NONE)
	.word	(VOICE7 | B3),  (MID | NONE)
	.word	(VOICE8 | G2),  (MID | SIXTEENTH)
	.word	(VOICE1 | XX),  (OFF | NONE)
	.word	(VOICE3 | XX),  (OFF | NONE)
	.word	(VOICE5 | XX),  (OFF | NONE)
	.word	(VOICE6 | XX),  (OFF | NONE)
	.word	(VOICE7 | XX),  (OFF | NONE)
	.word	(VOICE8 | XX),  (OFF | PAUSE)
	
	; 31:7	 Voice    Note   Vol   Dur
	.word	(VOICE1 | C5),  (MID | NONE)
	.word	(VOICE3 | C4),  (MID | NONE)
	.word	(VOICE8 | A2),  (MID | EIGHTH)
	.word	(VOICE1 | XX),  (OFF | NONE)
	.word	(VOICE3 | XX),  (OFF | NONE)
	.word	(VOICE8 | XX),  (OFF | PAUSE)
	
	; 31:8	 Voice    Note   Vol   Dur
	.word	(VOICE1 | C5),  (MID | NONE)
	.word	(VOICE3 | C4),  (MID | NONE)
	.word	(VOICE5 | A3),  (MID | NONE)
	.word	(VOICE6 | E3),  (MID | NONE)
	.word	(VOICE7 | C3),  (MID | NONE)
	.word	(VOICE8 | A2),  (MID | SIXTEENTH)
	.word	(VOICE5 | XX),  (OFF | NONE)
	.word	(VOICE6 | XX),  (OFF | NONE)
	.word	(VOICE7 | XX),  (OFF | PAUSE)
	
	; 31:9	 Voice    Note   Vol   Dur
	.word	(VOICE5 | A3),  (MID | NONE)
	.word	(VOICE6 | E3),  (MID | NONE)
	.word	(VOICE7 | C3),  (MID | SIXTEENTH)
	.word	(VOICE1 | XX),  (OFF | NONE)
	.word	(VOICE3 | XX),  (OFF | NONE)
	.word	(VOICE5 | XX),  (OFF | NONE)
	.word	(VOICE6 | XX),  (OFF | NONE)
	.word	(VOICE7 | XX),  (OFF | NONE)
	.word	(VOICE8 | XX),  (OFF | PAUSE)
	
	; Voice 1-2 = Panflote 5
	; Voice 3-4 = Marimba 4
	; Voice 5-7 = Steel Drum 3
	; Voice 8 = Elektrischer Bass 2

	; 32:1	 Voice    Note   Vol   Dur
	.word	(VOICE1 | B4),  (MID | NONE)
	.word	(VOICE3 | B3),  (MID | NONE)
	.word	(VOICE8 | E1),  (MID | EIGHTH)
	.word	(VOICE8 | XX),  (OFF | PAUSE)
	
	; 32:2	 Voice    Note   Vol   Dur
	.word	(VOICE5 | B3),  (MID | NONE)
	.word	(VOICE6 | G3),  (MID | NONE)
	.word	(VOICE7 | E3),  (MID | NONE)
	.word	(VOICE8 | E1),  (MID | SIXTEENTH)
	.word	(VOICE5 | XX),  (OFF | NONE)
	.word	(VOICE6 | XX),  (OFF | NONE)
	.word	(VOICE7 | XX),  (OFF | NONE)
	.word	(VOICE8 | XX),  (OFF | PAUSE)
	
	; 32:3	 Voice    Note   Vol   Dur
	.word	(VOICE5 | B3),  (MID | NONE)
	.word	(VOICE6 | G3),  (MID | NONE)
	.word	(VOICE7 | E3),  (MID | NONE)
	.word	(VOICE8 | E1),  (MID | SIXTEENTH)
	.word	(VOICE1 | XX),  (OFF | NONE)
	.word	(VOICE3 | XX),  (OFF | NONE)
	.word	(VOICE5 | XX),  (OFF | NONE)
	.word	(VOICE6 | XX),  (OFF | NONE)
	.word	(VOICE7 | XX),  (OFF | NONE)
	.word	(VOICE8 | XX),  (OFF | EIGHTH)
	
	; 32:4	 Voice    Note   Vol   Dur
	.word	(VOICE5 | B3),  (MID | NONE)
	.word	(VOICE6 | G3),  (MID | NONE)
	.word	(VOICE7 | E3),  (MID | SIXTEENTH)
	.word	(VOICE5 | XX),  (OFF | NONE)
	.word	(VOICE6 | XX),  (OFF | NONE)
	.word	(VOICE7 | XX),  (OFF | PAUSE)
	
	; 32:5	 Voice    Note   Vol   Dur
	.word	(VOICE5 | B3),  (MID | NONE)
	.word	(VOICE6 | G3),  (MID | NONE)
	.word	(VOICE7 | E3),  (MID | SIXTEENTH)
	.word	(VOICE5 | XX),  (OFF | NONE)
	.word	(VOICE6 | XX),  (OFF | NONE)
	.word	(VOICE7 | XX),  (OFF | EIGHTH)
	
	; 32:6	 Voice    Note   Vol   Dur
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
	.word	(VOICE7 | XX),  (OFF | NONE)
	.word	(VOICE8 | XX),  (OFF | PAUSE)

	; 50:12	 Voice    Note   Vol   Dur
	.word	(VOICE1 | G5),  (MID | NONE)
	.word	(VOICE3 | G4),  (MID | NONE)
	.word	(VOICE8 | C2),  (MID | SIXTEENTH)
	.word	(VOICE1 | XX),  (OFF | NONE)
	.word	(VOICE3 | XX),  (OFF | PAUSE)

	; 50:13	 Voice    Note   Vol   Dur
	.word	(VOICE1 | E5),  (MID | NONE)
	.word	(VOICE3 | E4),  (MID | SIXTEENTH)
	.word	(VOICE1 | XX),  (OFF | NONE)
	.word	(VOICE3 | XX),  (OFF | NONE)
	.word	(VOICE8 | XX),  (OFF | PAUSE)

	; 50:14	 Voice    Note   Vol   Dur
	.word	(VOICE1 | Fs5), (MID | NONE)
	.word	(VOICE3 | Fs4), (MID | NONE)
	.word	(VOICE5 | A3),  (MID | NONE)
	.word	(VOICE6 | Fs3), (MID | NONE)
	.word	(VOICE7 | D3),  (MID | NONE)
	.word	(VOICE8 | D2),  (MID | SIXTEENTH)
	.word	(VOICE1 | XX),  (OFF | NONE)
	.word	(VOICE3 | XX),  (OFF | NONE)
	.word	(VOICE5 | XX),  (OFF | NONE)
	.word	(VOICE6 | XX),  (OFF | NONE)
	.word	(VOICE7 | XX),  (OFF | PAUSE)

	; 50:15	 Voice    Note   Vol   Dur
	.word	(VOICE5 | A3),  (MID | NONE)
	.word	(VOICE6 | Fs3), (MID | NONE)
	.word	(VOICE7 | D3),  (MID | SIXTEENTH)
	.word	(VOICE5 | XX),  (OFF | NONE)
	.word	(VOICE6 | XX),  (OFF | NONE)
	.word	(VOICE7 | XX),  (OFF | NONE)
	.word	(VOICE8 | XX),  (OFF | PAUSE)

	; Voice 1-2 = Panflote 5
	; Voice 3-4 = Marimba 4
	; Voice 5-7 = Steel Drum 3
	; Voice 8 = Elektrischer Bass 2

	; 51:1	 Voice    Note   Vol   Du
	.word	(VOICE1 | E5),  (MID | NONE)
	.word	(VOICE3 | E4),  (MID | NONE)
	.word	(VOICE5 | G3),  (MID | NONE)
	.word	(VOICE6 | E3),  (MID | NONE)
	.word	(VOICE7 | B2),  (MID | NONE)
	.word	(VOICE8 | E2),  (MID | QUARTER)
	.word	(VOICE1 | XX),  (OFF | NONE)
	.word	(VOICE3 | XX),  (OFF | NONE)
	.word	(VOICE5 | XX),  (OFF | NONE)
	.word	(VOICE6 | XX),  (OFF | NONE)
	.word	(VOICE7 | XX),  (OFF | NONE)
	.word	(VOICE8 | XX),  (OFF | PAUSE)








	; EOT
	.word	$0000, $0000
