FredericSegard/MH6502_v4/Code/data.asm

; ----------------------------------------------------------------------------------------------------------------------
; DATA
; ----------------------------------------------------------------------------------------------------------------------

lcd_bios_msg:
	.byte	"MH6502-4, v3.05", 0

welcome_msg:
	.byte	"MH6502-4 @ 4MHz, BIOS v3.05", CR
	.byte	"32K ROM, 30K RAM, 2K NVRAM + RTC", CR, 0

hexascii:
	.byte	"0123456789ABCDEF",0

invalid_addr_msg:
	.byte	"Invalid address!", CR, 0

invalid_byte_msg:
	.byte	"Invalid byte!", CR, 0

invalid_param_msg:
	.byte	"Invalid parameter!", CR, 0

write_error_msg:
	.byte	"Write mismatch!", CR, 0

no_parameter_msg:
	.byte	"No parameter was specified.", CR, 0

invalid_command_msg:
	.byte	"Invalid command!",CR, 0

syntax_error_msg:
	.byte	"Syntax error!",CR, 0

date_error:
	.byte	"Invalid date format!",CR, 0

time_error:
	.byte	"Invalid time format!",CR, 0

cant_write_address:
	.byte	"Cannot write to address $", 0

diag_zeropage_msg:
	.byte	"Testing ZeroPage   $0000-00FF:", 0

diag_stack_msg:
	.byte	"Testing Stack      $0100-01FF:", 0

diag_ramtest_msg:
	.byte	"Testing System RAM $", 0

diag_bankramtest_msg:
	.byte	"Testing Bank RAM   $", 0

diag_nvramtest_msg:
	.byte	"Testing 2K NVRAM   $", 0

diag_ram_error_msg:
	.byte	"  Error at ", 0

diag_ram_error2_msg:
	.byte	", expected ", 0

diag_skip_test_msg:
	.byte	CR, "skipping test  ", CR, 0

diag_psg_channel:
	.byte	"Testing PSG channel #", 0
	
find_validate_msg:
	.byte	"Searching for: ", 0
	
zero_clearing_zp_msg:
	.byte	"Skipping zero page",CR,0

zero_clearing_stack_msg:
	.byte	"Skipping stack page",CR,0

zero_clearing_ram_msg:
	.byte	"Zeroing system RAM",CR,0

zero_clearing_bank_msg:
	.byte	"Zeroing bank RAM: bank ",0

zero_clearing_nvram_msg:
	.byte	"NVRAM not zeroed to preserve data",CR,0

day:	.byte	1, "Sunday", 0, 2, "Monday", 0, 3, "Tuesday", 0, 4, "Wednesday", 0, 5, "Thursday", 0
	.byte	6, "Friday", 0, 7, "Saturday", 0, $FF

month:	.byte	$01, "January", 0, $02, "February", 0, $03, "March", 0, $04, "April", 0, $05, "May"
	.byte	0, $06, "June", 0, $07, "July", 0, $08, "August", 0, $09, "September", 0, $10, "October", 0
	.byte	$11, "November", 0, $12, "December", 0, $FF

io_map_msg:
	.byte	"MEMORY MAP:", CR
	.byte	"-----------", CR
	.byte	"  RAM:   $0000-$76FF (30K)", CR
	.byte	"  NVRAM: $7800-$7FF7 (2K)", CR
	.byte	"  ROM:   $8000-$FFFF (32K)", CR, CR
	.byte	"I/O MAP:", CR
	.byte	"--------", CR
	.byte	"  RTC:   $7FF8-$7FFF (Clock)", CR
	.byte	"  VIA1:  $7700-$770F (PS/2 & NES)", CR
	.byte	"  ACIA1: $7710-$7013 (DCE)", CR
	.byte	"  ACIA2: $7714-$7017 (DTE)", CR, 0

commands:
	.byte	"$", $80
	.word	cur_address		; Set current address for commands requiring only one parameter
	.byte	"?", $80
	.word	help			; Help for various commands
	.byte	"ADDR", $80
	.word	cur_address		; Set current address for commands requiring only one parameter
;	.byte	"BASIC", $80
;	.word	basic_interpreter	; Start EhBasic interpreter
	.byte	"CLOCK",$80
	.word	clock			; Print or save clock data
	.byte	"DIAG",	$80
	.word	diagnostics		; Diagnose RAM
	.byte	"DIS",  $80
	.word	disassemble		; Disassemble memory
	.byte	"FIND", $80
	.word	find			; Find a byte or a series of bytes in memory
	.byte	"FILL", $80
	.word	fill_mem		; Fill a region of memory with a byte
	.byte	"HELP", $80
	.word	help			; Help for various commands
	.byte	"LOAD", $80
	.word	intel_hex_load		; Load a program using Intel Hex (Perhaps x-modem soon)
	.byte	"MAP",  $80
	.word	io_map			; Display memory map of computer
	.byte	"MEM",	$80
	.word	memory			; Memory dump
	.byte	"PEEK", $80
	.word	peek			; Read a value at a specific memory location
	.byte	"PLAY", $80
	.word	play
	.byte	"POKE", $80
	.word	poke			; Write a value at a specific memory location
	.byte	"REG",  $80
	.word	registers		; Display register values
	.byte	"RUN",	$80
	.word	run			; Run a loaded or assembled program
	.byte	"STREAM",$80
	.word	stream			; Run a loaded or assembled program
	.byte	"WRITE",$80
	.word	write_mem		; Write a series of bytes to memory
	.byte	"ZERO", $80
	.word	zero_mem		; Zero out a region of memory
	.byte	EOF			; End of commands

help_msg:;	"                                        "
	.byte	"ADDR/$:  Change current address", CR
;	.byte	"BASIC:   Enhanced Basic interpreter", CR
	.byte	"CLOCK:   Set and display time & date", CR
	.byte	"DIAG:    Test memory", CR
	.byte	"DIS:     Disassemble code", CR
	.byte	"FILL:    Fill a region of memory", CR
	.byte	"FIND:    Find a byte or sequence", CR
;	.byte	"FORTH:   Forth interpreter (FIG 1.1)", CR
	.byte	"HELP/?:  Display help", CR
	.byte	"LOAD:    Load program", CR
	.byte   "MEM:     Display content of memory", CR
	.byte	"PEEK:    Read a byte of data from memory", CR
	.byte	"PLAY:    Play Super Mario Bros song",CR
	.byte	"POKE:    Write a byte of data to memory", CR
	.byte	"REG:     Display & modify registers", CR
	.byte	"RUN:     Execute a program", CR
	.byte	"STREAM:  Send bytes to a single address", CR
	.byte	"WRITE:   Write byte(s) to memory", CR
	.byte	"ZERO:    Zero out the RAM", CR, 0

help_address:;	"                                        "
	.byte	CR
	.byte	"Set current address pointer", CR
	.byte	"---------------------------", CR
	.byte	"  ADDR  (defaults to 0000)", CR
	.byte	"  ADDR AAAA  (specific address)", CR
	.byte	"  $ [AAAA]  (alternative syntax)", CR
	.byte	"    Example:", CR
	.byte	"      ADDR $1000", CR, CR, 0

help_assemble:;	"                                        "
	.byte	CR
	.byte	"Assemble to machine language", CR
	.byte	"----------------------------"
	.byte	"  ASM AAAA opcode operand", CR
	.byte	"    Example:", CR
	.byte	"      ASM $1000 LDA #$12", CR, CR, 0

help_basic:;	"                                        "
;	.byte	CR
;	.byte	"Enhanced BASIC, version 2.22", CR
;	.byte	"----------------------------", CR
;	.byte	"  BASIC", CR, CR, 0

help_clock:;	"                                        "
	.byte	CR
	.byte	"Set or read date & time", CR
	.byte	"-----------------------", CR
	.byte	"  CLOCK  (display date and time)", CR
	.byte	"  CLOCK YY-MM-DD D HH:MM:SS  (set clock)", CR
	.byte	"  (YY=Year YY=month DD=date D=weekday)", CR
	.byte	"  (HH=hour MM=minutes SS=seconds)", CR
	.byte	"    Example:", CR
	.byte	"      CLOCK 22-02-25 6 17:35:00", CR, CR, 0

help_diag:;	"                                        "
	.byte	CR
	.byte	"Tests system memory", CR
	.byte	"-------------------", CR
	.byte	"  DIAG", CR, CR, 0

help_disassemble:
	;	"                                        "
	.byte	CR
	.byte	"Disassemble a portion of memory", CR
	.byte	"-------------------------------", CR
	.byte	"  DIS  (defaults current address)", CR
	.byte	"  DIS AAAA  (start at address AAAA)", CR, CR, 0

help_fill:;	"                                        "
	.byte	CR
	.byte	"Fill a region of memory with a byte", CR
	.byte	"-----------------------------------", CR
	.byte	"  FILL SSSS EEEE BB", CR
	.byte	"  (START address, END address, BYTE)", CR, CR, 0

help_hunt:;	"                                        "
	.byte	CR
	.byte	"Find byte(s) in memory starting @ $0000", CR
	.byte	"---------------------------------------", CR
	.byte	"  FIND BB [BB] [BB] [BB] [BB] ... [BB]", CR, CR, 0

help_iomap:;	"                                        "
	.byte	CR
	.byte	"Displays the memory map of the system", CR
	.byte	"-------------------------------------", CR
	.byte	"  MAP", CR, CR, 0

help_load:;	"                                        "
	.byte	CR
	.byte	"Load code from computer via Intel Hex", CR
	.byte	"-------------------------------------", CR
	.byte	"  LOAD  (loads at address $1000)", CR, CR, 0

help_registers:
	;	"                                        "
	.byte	CR
	.byte	"Prints the CPU's status and registers", CR
	.byte	"-------------------------------------", CR
	.byte	"  REG", CR, CR, 0

help_play:;	"                                        "
	.byte	CR
	.byte	"Play a song", CR
	.byte	"-----------", CR
	.byte	"  PLAY  (defaults to boot tune)", CR
	.byte	"  PLAY 1  (Super Mario Bros)", CR
	.byte	"  PLAY 2  (Monkey Island)", CR, CR, 0

help_run:;	"                                        "
	.byte	CR
	.byte	"Runs loaded code", CR
	.byte	"----------------", CR
	.byte	"  RUN  (defaults to $1000)", CR
	.byte	"  RUN AAAA  (runs at specific address)", CR, CR, 0

help_memory:;	"                                        "
	.byte	CR
	.byte	"Displays a portion of memory", CR
	.byte	"----------------------------", CR
	.byte	"  MEM  (defaults to current address)", CR
	.byte	"  MEM AAAA  (display @ specific address)", CR, CR, 0

help_save:;	"                                        "
	.byte	CR
	.byte	"Save code or data to computer", CR
	.byte	"-----------------------------", CR
	.byte	"  SAVE SSSS EEEE", CR
	.byte	"  (START address, END address)", CR, CR, 0

help_write:;	"                                        "
	.byte	CR
	.byte	"Writes a or many bytes to RAM", CR
	.byte	"-----------------------------", CR
	.byte	"  W AAAA BB [BB] [BB] [BB] ... [BB]", CR, CR, 0

help_zero:;	"                                        "
	.byte	CR
	.byte	"Writes zeros in RAM", CR
	.byte	"-------------------", CR
	.byte	"  Z", CR, CR, 0

playaborted:
	.byte	"Play aborted by user.",CR,0

starthex:
	.byte   "Send 6502 code in Intel Hex format.",CR
	.byte	"Press ESC to cancel.",CR,0

transferaborted:
	.byte	"Transfer aborted by user.",CR,0

unknownrecordtype:
	.byte   CR,"Unknown record type $",0

badrecordchecksum:
	.byte   CR,"Bad record checksum!",CR,0

downloadfailed:
	.byte   CR,"Download Failed",CR,"Aborting!",CR,0

downloadsuccessful:
	.byte   CR,"Download Successful!",CR,0

dis_mnemonic_blk1:
	.byte	"brk ", "ora ", "??? ", "??? ", "tsb ", "ora ", "asl ", "rmb0"		; $00-$07
	.byte	"php ", "ora ", "asl ", "??? ", "tsb ", "ora ", "asl ", "bbr0"		; $08-$0F
	.byte	"bpl ", "ora ", "ora ", "??? ", "trb ", "ora ", "asl ", "rmb1"		; $10-$17
	.byte	"clc ", "ora ", "inc ", "??? ", "trb ", "ora ", "asl ", "bbr1"		; $18-$1F
	.byte	"jsr ", "and ", "??? ", "??? ", "bit ", "and ", "rol ", "rmb2"		; $20-$27
	.byte	"plp ", "and ", "rol ", "??? ", "bit ", "and ", "rol ", "bbr2"		; $28-$2F
	.byte	"bmi ", "and ", "and ", "??? ", "bit ", "and ", "rol ", "rmb3"		; $30-$37
	.byte	"sec ", "and ", "dec ", "??? ", "bit ", "and ", "rol ", "bbr3"		; $38-$3F

dis_mnemonic_blk2:	
	.byte	"rti ", "eor ", "??? ", "??? ", "??? ", "eor ", "lsr ", "rmb4"		; $40-$47
	.byte	"pha ", "eor ", "lsr ", "??? ", "jmp ", "eor ", "lsr ", "bbr4"		; $48-$4F
	.byte	"bvc ", "eor ", "eor ", "??? ", "??? ", "eor ", "lsr ", "rmb5"		; $50-$57
	.byte	"cli ", "eor ", "phy ", "??? ", "??? ", "eor ", "lsr ", "bbr5"		; $58-$5F
	.byte	"rts ", "adc ", "??? ", "??? ", "stz ", "adc ", "ror ", "rmb6"		; $60-$67
	.byte	"pla ", "adc ", "ror ", "??? ", "jmp ", "adc ", "ror ", "bbr6"		; $68-$6F
	.byte	"bvs ", "adc ", "adc ", "??? ", "stz ", "adc ", "ror ", "rmb7"		; $70-$77
	.byte	"sei ", "adc ", "ply ", "??? ", "jmp ", "adc ", "ror ", "bbr7"		; $78-$7F

dis_mnemonic_blk3:	
	.byte	"bra ", "sta ", "??? ", "??? ", "sty ", "sta ", "stx ", "smb0"		; $80-$87
	.byte	"dey ", "bit ", "txa ", "??? ", "sty ", "sta ", "stx ", "bbs0"		; $88-$8F
	.byte	"bcc ", "sta ", "sta ", "??? ", "sty ", "sta ", "stx ", "smb1"		; $90-$97
	.byte	"tya ", "sta ", "txs ", "??? ", "stz ", "sta ", "stz ", "bbs1"		; $98-$9F
	.byte	"ldy ", "lda ", "ldx ", "??? ", "ldy ", "lda ", "ldx ", "smb2"		; $A0-$A7
	.byte	"tay ", "lda ", "tax ", "??? ", "ldy ", "lda ", "ldx ", "bbs2"		; $A8-$AF
	.byte	"bcs ", "lda ", "lda ", "??? ", "ldy ", "lda ", "ldx ", "smb3"		; $B0-$B7
	.byte	"clv ", "lda ", "tsx ", "??? ", "ldy ", "lda ", "ldx ", "bbs3"		; $B8-$BF

dis_mnemonic_blk4:	
	.byte	"cpy ", "cmp ", "??? ", "??? ", "cpy ", "cmp ", "dec ", "smb4"		; $C0-$C7
	.byte	"iny ", "cmp ", "dex ", "wai ", "cpy ", "cmp ", "dec ", "bbs4"		; $C8-$CF
	.byte	"bne ", "cmp ", "cmp ", "??? ", "??? ", "cmp ", "dec ", "smb5"		; $D0-$D7
	.byte	"cld ", "cmp ", "phx ", "stp ", "??? ", "cmp ", "dec ", "bbs5"		; $D8-$DF
	.byte	"cpx ", "sbc ", "??? ", "??? ", "cpx ", "sbc ", "inc ", "smb6"		; $E0-$E7
	.byte	"inx ", "sbc ", "nop ", "??? ", "cpx ", "sbc ", "inc ", "bbs6"		; $E8-$EF
	.byte	"beq ", "sbc ", "sbc ", "??? ", "??? ", "sbc ", "inc ", "smb7"		; $F0-$F7
	.byte	"sed ", "sbc ", "plx ", "??? ", "??? ", "sbc ", "inc ", "bbs7"		; $F8-$FF
	
dis_addressing:
	.byte	IMP, IZX, 0  , 0  , ZP , ZP , ZP , ZP , IMP, IMM, IMP, 0  , ABS, ABS, ABS, ZPR
	.byte	REL, IZY, IZP, 0  , ZP , ZPX, ZPX, ZP , IMP, ABY, IMP, 0  , ABS, ABX, ABX, ZPR
	.byte	ABS, IZX, 0  , 0  , ZP , ZP , ZP , ZP , IMP, IMM, IMP, 0  , ABS, ABS, ABS, ZPR
	.byte	REL, IZY, IZP, 0  , ZPX, ZPX, ZPX, ZP , IMP, ABY, IMP, 0  , ABX, ABX, ABX, ZPR
	.byte	IMP, IZX, 0  , 0  , 0  , ZP , ZP , ZP , IMP, IMM, IMP, 0  , ABS, ABS, ABS, ZPR
	.byte	REL, IZY, IZP, 0  , 0  , ZPX, ZPX, ZP , IMP, ABY, IMP, 0  , 0  , ABX, ABX, ZPR
	.byte	IMP, IZX, 0  , 0  , ZP , ZP , ZP , ZP , IMP, IMM, IMP, 0  , IND, ABS, ABS, ZPR
	.byte	REL, IZY, IZP, 0  , ZPX, ZPX, ZPX, ZP , IMP, ABY, IMP, 0  , IAX, ABX, ABX, ZPR
	.byte	REL, IZX, 0  , 0  , ZP , ZP , ZP , ZP , IMP, IMM, IMP, 0  , ABS, ABS, ABS, ZPR
	.byte	REL, IZY, IZP, 0  , ZPX, ZPX, ZPY, ZP , IMP, ABY, IMP, 0  , ABS, ABX, ABX, ZPR
	.byte	IMM, IZX, IMM, 0  , ZP , ZP , ZP , ZP , IMP, IMM, IMP, 0  , ABS, ABS, ABS, ZPR
	.byte	REL, IZY, IZP, 0  , ZPX, ZPX, ZPY, ZP , IMP, ABY, IMP, 0  , ABX, ABX, ABY, ZPR
	.byte	IMM, IZX, 0  , 0  , ZP , ZP , ZP , ZP , IMP, IMM, IMP, IMP, ABS, ABS, ABS, ZPR
	.byte	REL, IZY, IZP, 0  , 0  , ZPX, ZPX, ZP , IMP, ABY, IMP, IMP, 0  , ABX, ABX, ZPR
	.byte	IMM, IZX, 0  , 0  , ZP , ZP , ZP , ZP , IMP, IMM, IMP, 0  , ABS, ABS, ABS, ZPR
	.byte	REL, IZY, IZP, 0  , 0  , ZPX, ZPX, ZP , IMP, ABY, IMP, 0  , 0  , ABX, ABX, ZPR
