FredericSegard/MH6502_v4/Misc/APLS.asm

Char_000	.byte	$00, $00, $00, $00, $00, $00, $00, $00	; (.)
Char_001	.byte	$00, $38, $40, $70, $40, $38, $00, $FE	; (.)
Char_002	.byte	$00, $20, $20, $20, $24, $18, $00, $FE	; (.)
Char_003	.byte	$00, $6C, $FE, $FE, $7C, $38, $10, $00	; (.)
Char_004	.byte	$10, $38, $7C, $FE, $7C, $38, $10, $00	; (.)
Char_005	.byte	$38, $38, $FE, $FE, $54, $10, $38, $00	; (.)
Char_006	.byte	$10, $38, $7C, $FE, $D6, $10, $38, $00	; (.)
Char_007	.byte	$00, $00, $18, $3C, $3C, $18, $00, $00	; (.)
Char_008	.byte	$FE, $FE, $C6, $82, $82, $C6, $FE, $FE	; (.)
Char_009	.byte	$00, $38, $44, $44, $44, $38, $00, $00	; (.)
Char_010	.byte	$FF, $C3, $99, $BD, $BD, $99, $C3, $FF	; (.)
Char_011	.byte	$00, $FC, $00, $FC, $00, $FC, $00, $00	; (.)
Char_012	.byte	$38, $44, $44, $38, $10, $7C, $10, $00	; (.)
Char_013	.byte	$3E, $22, $3E, $20, $20, $60, $E0, $C0	; (.)
Char_014	.byte	$3E, $22, $3E, $22, $22, $2E, $E4, $40	; (.)
Char_015	.byte	$00, $7C, $AA, $D6, $AA, $7C, $00, $00	; (.)
Char_016	.byte	$80, $E0, $F8, $FE, $F8, $E0, $80, $00	; (.)
Char_017	.byte	$02, $0E, $3E, $FE, $3E, $0E, $02, $00	; (.)
Char_018	.byte	$00, $44, $44, $00, $00, $10, $10, $00	; (.)
Char_019	.byte	$78, $48, $48, $48, $48, $48, $78, $00	; (.)
Char_020	.byte	$7E, $92, $92, $72, $12, $12, $12, $00	; (.)
Char_021	.byte	$1C, $22, $18, $24, $24, $18, $44, $38	; (.)
Char_022	.byte	$FE, $C2, $A2, $92, $8A, $86, $FE, $00	; (.)
Char_023	.byte	$FE, $82, $92, $AA, $92, $82, $FE, $00	; (.)
Char_024	.byte	$10, $38, $7C, $10, $10, $10, $10, $00	; (.)
Char_025	.byte	$10, $10, $10, $10, $7C, $38, $10, $00	; (.)
Char_026	.byte	$00, $10, $08, $FC, $08, $10, $00, $00	; (.)
Char_027	.byte	$00, $20, $40, $FC, $40, $20, $00, $00	; (.)
Char_028	.byte	$20, $20, $20, $20, $20, $20, $20, $3C	; (.)
Char_029	.byte	$00, $00, $44, $FE, $44, $00, $00, $00	; (.)
Char_030	.byte	$10, $28, $28, $44, $44, $82, $FE, $00	; (.)
Char_031	.byte	$FE, $82, $44, $44, $28, $28, $10, $00	; (.)
Char_032	.byte	$00, $00, $00, $00, $00, $00, $00, $00	; ( )
Char_033	.byte	$10, $38, $38, $10, $10, $00, $10, $00	; (!)
Char_034	.byte	$84, $84, $48, $00, $00, $00, $00, $00	; (")
Char_035	.byte	$48, $48, $FC, $48, $FC, $48, $48, $00	; (#)
Char_036	.byte	$10, $7E, $80, $7C, $02, $FC, $10, $00	; ($)
Char_037	.byte	$00, $84, $88, $10, $20, $44, $84, $00	; (%)
Char_038	.byte	$30, $48, $30, $64, $98, $98, $64, $00	; (&)
Char_039	.byte	$10, $10, $20, $00, $00, $00, $00, $00	; (')
Char_040	.byte	$08, $10, $20, $20, $20, $10, $08, $00	; (()
Char_041	.byte	$20, $10, $08, $08, $08, $10, $20, $00	; ())
Char_042	.byte	$00, $48, $30, $FC, $30, $48, $00, $00	; (*)
Char_043	.byte	$00, $10, $10, $FE, $10, $10, $00, $00	; (+)
Char_044	.byte	$00, $00, $00, $00, $00, $10, $10, $20	; (,)
Char_045	.byte	$00, $00, $00, $FC, $00, $00, $00, $00	; (-)
Char_046	.byte	$00, $00, $00, $00, $00, $10, $10, $00	; (.)
Char_047	.byte	$00, $04, $08, $10, $20, $40, $80, $00	; (/)
Char_048	.byte	$38, $44, $44, $54, $44, $44, $38, $00	; (0)
Char_049	.byte	$10, $70, $10, $10, $10, $10, $7C, $00	; (1)
Char_050	.byte	$78, $04, $08, $10, $20, $40, $7C, $00	; (2)
Char_051	.byte	$78, $04, $04, $38, $04, $04, $78, $00	; (3)
Char_052	.byte	$18, $28, $48, $48, $7C, $08, $1C, $00	; (4)
Char_053	.byte	$7C, $40, $78, $04, $04, $04, $78, $00	; (5)
Char_054	.byte	$38, $40, $40, $78, $44, $44, $38, $00	; (6)
Char_055	.byte	$7C, $04, $08, $10, $20, $20, $20, $00	; (7)
Char_056	.byte	$38, $44, $44, $38, $44, $44, $38, $00	; (8)
Char_057	.byte	$38, $44, $44, $3C, $04, $08, $30, $00	; (9)
Char_058	.byte	$00, $10, $10, $00, $00, $10, $10, $00	; (:)
Char_059	.byte	$00, $10, $10, $00, $00, $10, $10, $20	; (;)
Char_060	.byte	$08, $10, $20, $40, $20, $10, $08, $00	; (<)
Char_061	.byte	$00, $00, $FC, $00, $00, $FC, $00, $00	; (=)
Char_062	.byte	$20, $10, $08, $04, $08, $10, $20, $00	; (>)
Char_063	.byte	$38, $44, $04, $08, $10, $00, $10, $00	; (?)
Char_064	.byte	$38, $44, $5C, $54, $58, $40, $38, $00	; (@)
Char_065	.byte	$10, $28, $44, $44, $7C, $44, $44, $00	; (A)
Char_066	.byte	$78, $44, $44, $78, $44, $44, $78, $00	; (B)
Char_067	.byte	$18, $24, $40, $40, $40, $24, $18, $00	; (C)
Char_068	.byte	$70, $48, $44, $44, $44, $48, $70, $00	; (D)
Char_069	.byte	$7C, $40, $40, $78, $40, $40, $7C, $00	; (E)
Char_070	.byte	$7C, $40, $40, $78, $40, $40, $40, $00	; (F)
Char_071	.byte	$18, $24, $40, $40, $4C, $2C, $14, $00	; (G)
Char_072	.byte	$44, $44, $44, $7C, $44, $44, $44, $00	; (H)
Char_073	.byte	$38, $10, $10, $10, $10, $10, $38, $00	; (I)
Char_074	.byte	$08, $08, $08, $08, $08, $48, $30, $00	; (J)
Char_075	.byte	$44, $48, $50, $70, $48, $44, $44, $00	; (K)
Char_076	.byte	$40, $40, $40, $40, $40, $40, $7C, $00	; (L)
Char_077	.byte	$44, $6C, $54, $44, $44, $44, $44, $00	; (M)
Char_078	.byte	$44, $64, $64, $54, $4C, $4C, $44, $00	; (N)
Char_079	.byte	$38, $44, $44, $44, $44, $44, $38, $00	; (O)
Char_080	.byte	$78, $44, $44, $78, $40, $40, $40, $00	; (P)
Char_081	.byte	$38, $44, $44, $44, $54, $54, $38, $0C	; (Q)
Char_082	.byte	$78, $44, $44, $78, $48, $44, $44, $00	; (R)
Char_083	.byte	$38, $44, $40, $38, $04, $44, $38, $00	; (S)
Char_084	.byte	$7C, $10, $10, $10, $10, $10, $10, $00	; (T)
Char_085	.byte	$44, $44, $44, $44, $44, $44, $38, $00	; (U)
Char_086	.byte	$44, $44, $44, $44, $44, $28, $10, $00	; (V)
Char_087	.byte	$44, $44, $44, $44, $54, $54, $28, $00	; (W)
Char_088	.byte	$44, $44, $28, $10, $28, $44, $44, $00	; (X)
Char_089	.byte	$44, $44, $44, $38, $10, $10, $10, $00	; (Y)
Char_090	.byte	$7C, $04, $08, $10, $20, $40, $7C, $00	; (Z)
Char_091	.byte	$38, $20, $20, $20, $20, $20, $38, $00	; ([)
Char_092	.byte	$00, $80, $40, $20, $10, $08, $04, $00	; (\)
Char_093	.byte	$38, $08, $08, $08, $08, $08, $38, $00	; (])
Char_094	.byte	$00, $00, $30, $48, $84, $00, $00, $00	; (^)
Char_095	.byte	$00, $00, $00, $00, $00, $00, $00, $FC	; (_)
Char_096	.byte	$10, $10, $08, $00, $00, $00, $00, $00	; (`)
Char_097	.byte	$00, $00, $70, $08, $78, $48, $74, $00	; (a)
Char_098	.byte	$40, $40, $70, $48, $44, $44, $78, $00	; (b)
Char_099	.byte	$00, $00, $3C, $40, $40, $40, $3C, $00	; (c)
Char_100	.byte	$18, $08, $38, $48, $48, $48, $34, $00	; (d)
Char_101	.byte	$00, $00, $38, $44, $7C, $40, $3C, $00	; (e)
Char_102	.byte	$18, $24, $20, $78, $20, $20, $70, $00	; (f)
Char_103	.byte	$00, $00, $34, $48, $48, $38, $08, $70	; (g)
Char_104	.byte	$40, $40, $58, $64, $44, $44, $44, $00	; (h)
Char_105	.byte	$10, $00, $30, $10, $10, $10, $38, $00	; (i)
Char_106	.byte	$04, $00, $0C, $04, $04, $04, $44, $38	; (j)
Char_107	.byte	$40, $40, $44, $48, $70, $48, $44, $00	; (k)
Char_108	.byte	$30, $10, $10, $10, $10, $10, $38, $00	; (l)
Char_109	.byte	$00, $00, $68, $54, $54, $54, $54, $00	; (m)
Char_110	.byte	$00, $00, $78, $44, $44, $44, $44, $00	; (n)
Char_111	.byte	$00, $00, $38, $44, $44, $44, $38, $00	; (o)
Char_112	.byte	$00, $00, $78, $44, $44, $78, $40, $40	; (p)
Char_113	.byte	$00, $00, $38, $48, $48, $38, $08, $08	; (q)
Char_114	.byte	$00, $00, $58, $64, $40, $40, $40, $00	; (r)
Char_115	.byte	$00, $00, $38, $40, $38, $04, $78, $00	; (s)
Char_116	.byte	$20, $20, $70, $20, $20, $24, $18, $00	; (t)
Char_117	.byte	$00, $00, $48, $48, $48, $48, $34, $00	; (u)
Char_118	.byte	$00, $00, $44, $44, $44, $28, $10, $00	; (v)
Char_119	.byte	$00, $00, $44, $44, $44, $54, $28, $00	; (w)
Char_120	.byte	$00, $00, $44, $28, $10, $28, $44, $00	; (x)
Char_121	.byte	$00, $00, $44, $44, $44, $3C, $04, $78	; (y)
Char_122	.byte	$00, $00, $7C, $08, $10, $20, $7C, $00	; (z)
Char_123	.byte	$0C, $10, $10, $60, $10, $10, $0C, $00	; ({)
Char_124	.byte	$10, $10, $10, $10, $10, $10, $10, $10	; (|)
Char_125	.byte	$60, $10, $10, $0C, $10, $10, $60, $00	; (})
Char_126	.byte	$00, $00, $00, $64, $98, $00, $00, $00	; (~)
Char_127	.byte	$00, $00, $10, $28, $44, $44, $7C, $00	; (.)
Char_128	.byte	$38, $44, $80, $80, $44, $38, $04, $38	; (.)
Char_129	.byte	$88, $00, $88, $88, $88, $88, $74, $00	; (.)
Char_130	.byte	$10, $20, $78, $84, $FC, $80, $7C, $00	; (.)
Char_131	.byte	$70, $88, $70, $08, $78, $88, $74, $00	; (.)
Char_132	.byte	$84, $00, $70, $08, $78, $88, $74, $00	; (.)
Char_133	.byte	$20, $10, $70, $08, $78, $88, $74, $00	; (.)
Char_134	.byte	$30, $00, $70, $08, $78, $88, $74, $00	; (.)
Char_135	.byte	$00, $00, $3C, $40, $40, $3C, $08, $38	; (.)
Char_136	.byte	$78, $84, $78, $84, $FC, $80, $7C, $00	; (.)
Char_137	.byte	$84, $00, $78, $84, $FC, $80, $7C, $00	; (.)
Char_138	.byte	$20, $10, $78, $84, $FC, $80, $7C, $00	; (.)
Char_139	.byte	$44, $00, $30, $10, $10, $10, $38, $00	; (.)
Char_140	.byte	$38, $44, $30, $10, $10, $10, $38, $00	; (.)
Char_141	.byte	$20, $10, $30, $10, $10, $10, $38, $00	; (.)
Char_142	.byte	$84, $30, $48, $84, $FC, $84, $84, $00	; (.)
Char_143	.byte	$30, $00, $78, $84, $FC, $84, $84, $00	; (.)
Char_144	.byte	$FE, $82, $82, $82, $82, $82, $FE, $00	; (.)
Char_145	.byte	$FE, $92, $92, $82, $82, $82, $FE, $00	; (.)
Char_146	.byte	$FE, $92, $82, $FE, $82, $92, $FE, $00	; (.)
Char_147	.byte	$78, $84, $78, $84, $84, $84, $78, $00	; (.)
Char_148	.byte	$84, $00, $78, $84, $84, $84, $78, $00	; (.)
Char_149	.byte	$20, $10, $78, $84, $84, $84, $78, $00	; (.)
Char_150	.byte	$70, $88, $00, $88, $88, $88, $74, $00	; (.)
Char_151	.byte	$40, $20, $88, $88, $88, $88, $74, $00	; (.)
Char_152	.byte	$00, $7C, $10, $10, $10, $10, $00, $00	; (.)
Char_153	.byte	$84, $78, $84, $84, $84, $84, $78, $00	; (.)
Char_154	.byte	$84, $48, $84, $84, $84, $84, $78, $00	; (.)
Char_155	.byte	$10, $38, $44, $40, $44, $38, $10, $00	; (.)
Char_156	.byte	$30, $48, $40, $E0, $40, $E4, $98, $00	; (.)
Char_157	.byte	$00, $10, $10, $10, $10, $7C, $00, $00	; (.)
Char_158	.byte	$00, $20, $60, $FE, $60, $20, $00, $00	; (.)
Char_159	.byte	$00, $7C, $10, $10, $10, $7C, $00, $00	; (.)
Char_160	.byte	$10, $20, $70, $08, $78, $88, $74, $00	; (.)
Char_161	.byte	$08, $10, $30, $10, $10, $10, $38, $00	; (.)
Char_162	.byte	$10, $20, $78, $84, $84, $84, $78, $00	; (.)
Char_163	.byte	$10, $20, $88, $88, $88, $88, $74, $00	; (.)
Char_164	.byte	$32, $4C, $00, $78, $44, $44, $44, $00	; (.)
Char_165	.byte	$64, $98, $C4, $E4, $9C, $8C, $84, $00	; (.)
Char_166	.byte	$70, $08, $78, $88, $74, $00, $FC, $00	; (.)
Char_167	.byte	$78, $84, $84, $84, $78, $00, $FC, $00	; (.)
Char_168	.byte	$10, $00, $10, $20, $40, $44, $38, $00	; (.)
Char_169	.byte	$3C, $20, $20, $20, $20, $20, $20, $20	; (.)
Char_170	.byte	$00, $00, $00, $FC, $04, $04, $00, $00	; (.)
Char_171	.byte	$00, $08, $0C, $FE, $0C, $08, $00, $00	; (.)
Char_172	.byte	$00, $84, $84, $84, $84, $78, $00, $00	; (.)
Char_173	.byte	$10, $00, $10, $10, $38, $38, $10, $00	; (.)
Char_174	.byte	$00, $FE, $38, $54, $54, $38, $10, $00	; (.)
Char_175	.byte	$00, $10, $38, $54, $54, $38, $FE, $00	; (.)
Char_176	.byte	$22, $88, $22, $88, $22, $88, $22, $88	; (.)
Char_177	.byte	$55, $AA, $55, $AA, $55, $AA, $55, $AA	; (.)
Char_178	.byte	$EE, $BB, $EE, $BB, $EE, $BB, $EE, $BB	; (.)
Char_179	.byte	$10, $10, $10, $10, $10, $10, $10, $10	; (.)
Char_180	.byte	$10, $10, $10, $10, $F0, $10, $10, $10	; (.)
Char_181	.byte	$10, $10, $10, $F0, $10, $F0, $10, $10	; (.)
Char_182	.byte	$28, $28, $28, $28, $E8, $28, $28, $28	; (.)
Char_183	.byte	$00, $00, $00, $00, $F8, $28, $28, $28	; (.)
Char_184	.byte	$00, $00, $00, $F0, $10, $F0, $10, $10	; (.)
Char_185	.byte	$28, $28, $28, $E8, $08, $E8, $28, $28	; (.)
Char_186	.byte	$28, $28, $28, $28, $28, $28, $28, $28	; (.)
Char_187	.byte	$00, $00, $00, $F8, $08, $E8, $28, $28	; (.)
Char_188	.byte	$28, $28, $28, $E8, $08, $F8, $00, $00	; (.)
Char_189	.byte	$28, $28, $28, $28, $F8, $00, $00, $00	; (.)
Char_190	.byte	$10, $10, $10, $F0, $10, $F0, $00, $00	; (.)
Char_191	.byte	$00, $00, $00, $00, $F0, $10, $10, $10	; (.)
Char_192	.byte	$10, $10, $10, $10, $1F, $00, $00, $00	; (.)
Char_193	.byte	$10, $10, $10, $10, $FF, $00, $00, $00	; (.)
Char_194	.byte	$00, $00, $00, $00, $FF, $10, $10, $10	; (.)
Char_195	.byte	$10, $10, $10, $10, $1F, $10, $10, $10	; (.)
Char_196	.byte	$00, $00, $00, $00, $FF, $00, $00, $00	; (.)
Char_197	.byte	$10, $10, $10, $10, $FF, $10, $10, $10	; (.)
Char_198	.byte	$10, $10, $10, $1F, $10, $1F, $10, $10	; (.)
Char_199	.byte	$28, $28, $28, $28, $2F, $28, $28, $28	; (.)
Char_200	.byte	$28, $28, $28, $2F, $20, $3F, $00, $00	; (.)
Char_201	.byte	$00, $00, $00, $3F, $20, $2F, $28, $28	; (.)
Char_202	.byte	$28, $28, $28, $EF, $00, $FF, $00, $00	; (.)
Char_203	.byte	$00, $00, $00, $FF, $00, $EF, $28, $28	; (.)
Char_204	.byte	$28, $28, $28, $2F, $20, $2F, $28, $28	; (.)
Char_205	.byte	$00, $00, $00, $FF, $00, $FF, $00, $00	; (.)
Char_206	.byte	$28, $28, $28, $EF, $00, $EF, $28, $28	; (.)
Char_207	.byte	$10, $10, $10, $FF, $00, $FF, $00, $00	; (.)
Char_208	.byte	$28, $28, $28, $28, $FF, $00, $00, $00	; (.)
Char_209	.byte	$00, $00, $00, $FF, $00, $FF, $10, $10	; (.)
Char_210	.byte	$00, $00, $00, $00, $FF, $28, $28, $28	; (.)
Char_211	.byte	$28, $28, $28, $28, $3F, $00, $00, $00	; (.)
Char_212	.byte	$10, $10, $10, $1F, $10, $1F, $00, $00	; (.)
Char_213	.byte	$00, $00, $00, $1F, $10, $1F, $10, $10	; (.)
Char_214	.byte	$00, $00, $00, $00, $3F, $28, $28, $28	; (.)
Char_215	.byte	$28, $28, $28, $28, $FF, $28, $28, $28	; (.)
Char_216	.byte	$10, $10, $10, $FF, $10, $FF, $10, $10	; (.)
Char_217	.byte	$10, $10, $10, $10, $F0, $00, $00, $00	; (.)
Char_218	.byte	$00, $00, $00, $00, $1F, $10, $10, $10	; (.)
Char_219	.byte	$FF, $FF, $FF, $FF, $FF, $FF, $FF, $FF	; (.)
Char_220	.byte	$00, $00, $00, $00, $FF, $FF, $FF, $FF	; (.)
Char_221	.byte	$F0, $F0, $F0, $F0, $F0, $F0, $F0, $F0	; (.)
Char_222	.byte	$0F, $0F, $0F, $0F, $0F, $0F, $0F, $0F	; (.)
Char_223	.byte	$FF, $FF, $FF, $FF, $00, $00, $00, $00	; (.)
Char_224	.byte	$00, $00, $72, $8C, $8C, $72, $00, $00	; (.)
Char_225	.byte	$38, $44, $44, $78, $44, $64, $D8, $00	; (.)
Char_226	.byte	$00, $7C, $80, $80, $80, $7C, $00, $00	; (.)
Char_227	.byte	$00, $F8, $04, $04, $04, $F8, $00, $00	; (.)
Char_228	.byte	$00, $78, $84, $CC, $B4, $84, $84, $00	; (.)
Char_229	.byte	$64, $98, $00, $30, $48, $84, $00, $00	; (.)
Char_230	.byte	$00, $1C, $22, $22, $32, $2C, $A0, $40	; (.)
Char_231	.byte	$64, $98, $00, $84, $48, $30, $00, $00	; (.)
Char_232	.byte	$10, $7C, $92, $92, $92, $7C, $10, $00	; (.)
Char_233	.byte	$00, $7C, $82, $FE, $82, $7C, $00, $00	; (.)
Char_234	.byte	$00, $7C, $82, $82, $82, $7C, $00, $00	; (.)
Char_235	.byte	$00, $00, $84, $48, $30, $00, $00, $00	; (.)
Char_236	.byte	$00, $20, $20, $20, $24, $18, $00, $00	; (.)
Char_237	.byte	$80, $7C, $A2, $92, $8A, $7C, $02, $00	; (.)
Char_238	.byte	$00, $38, $40, $70, $40, $38, $00, $00	; (.)
Char_239	.byte	$00, $78, $84, $84, $84, $84, $00, $00	; (.)
Char_240	.byte	$02, $04, $08, $FE, $20, $40, $80, $00	; (.)
Char_241	.byte	$80, $40, $20, $FE, $08, $04, $02, $00	; (.)
Char_242	.byte	$20, $10, $08, $10, $20, $00, $78, $00	; (.)
Char_243	.byte	$08, $10, $20, $10, $08, $00, $3C, $00	; (.)
Char_244	.byte	$02, $04, $FC, $10, $20, $FC, $40, $80	; (.)
Char_245	.byte	$00, $00, $48, $30, $30, $48, $00, $00	; (.)
Char_246	.byte	$10, $10, $00, $FE, $00, $10, $10, $00	; (.)
Char_247	.byte	$30, $30, $48, $48, $84, $FC, $00, $FC	; (.)
Char_248	.byte	$00, $30, $48, $48, $30, $00, $00, $00	; (.)
Char_249	.byte	$00, $48, $84, $B4, $B4, $48, $00, $00	; (.)
Char_250	.byte	$FE, $82, $64, $D6, $AC, $28, $10, $00	; (.)
Char_251	.byte	$10, $38, $38, $54, $54, $92, $FE, $10	; (.)
Char_252	.byte	$10, $FE, $92, $54, $54, $38, $38, $10	; (.)
Char_253	.byte	$00, $FC, $00, $00, $00, $00, $00, $00	; (.)
Char_254	.byte	$00, $84, $84, $00, $00, $00, $00, $00	; (.)
Char_255	.byte	$00, $00, $00, $10, $08, $00, $00, $00	; (.)
