FredericSegard/MH6502_v4/Misc/ASCII-PETSCII-hybrid.asm

; Font: Hybrid ASCII-PETSCII (C64)

Char_000	.byte	$00, $00, $00, $00, $00, $00, $00, $00	; (Nothing)
Char_001	.byte	$3E, $63, $63, $63, $36, $14, $77, $00	; (Omega - Ohm)
Char_002	.byte	$00, $00, $66, $99, $99, $66, $00, $00	; (Infinity)
Char_003	.byte	$00, $00, $03, $3E, $76, $36, $36, $00	; (Pi)
Char_004	.byte	$00, $00, $66, $66, $66, $66, $7C, $60	; (Micro)
Char_005	.byte	$1C, $08, $3E, $6B, $6B, $3E, $08, $1C	; (Phi)
Char_006	.byte	$18, $18, $7E, $18, $18, $00, $7E, $00	; (Plus or minus)
Char_007	.byte	$30, $18, $0C, $18, $30, $00, $7C, $00	; (Greater or equal to)
Char_008	.byte	$18, $30, $60, $30, $18, $00, $7C, $00	; (Less or equal to)
Char_009	.byte	$00, $76, $DC, $00, $76, $DC, $00, $00	; (Approximately)
Char_010	.byte	$00, $18, $00, $7E, $00, $18, $00, $00	; (Division)
Char_011	.byte	$0F, $0C, $0C, $0C, $CC, $6C, $3C, $00	; (Root)
Char_012	.byte	$F0, $30, $60, $C0, $F0, $00, $00, $00	; (Square)
Char_013	.byte	$F0, $10, $70, $10, $F0, $00, $00, $00	; (Cube)
Char_014	.byte	$38, $6C, $38, $00, $00, $00, $00, $00	; (Degree)
Char_015	.byte	$01, $03, $06, $6C, $78, $70, $60, $00	; (Check)
Char_016	.byte	$18, $18, $24, $66, $42, $C3, $FF, $00	; (Delta)
Char_017	.byte	$0F, $07, $0F, $7D, $CC, $CC, $CC, $78	; (Male)
Char_018	.byte	$3C, $66, $66, $66, $3C, $18, $7E, $18	; (Female)
Char_019	.byte	$04, $06, $05, $05, $04, $3C, $78, $00	; (Note 1)
Char_020	.byte	$0C, $0A, $0D, $0B, $39, $71, $07, $0E	; (Note 2)
Char_021	.byte	$08, $2A, $1C, $77, $1C, $2A, $08, $00	; (Star)
Char_022	.byte	$20, $30, $38, $3C, $3C, $38, $30, $20	; (Big arrow right)
Char_023	.byte	$04, $0C, $1C, $3C, $3C, $1C, $0C, $04	; (Big arrow left)
Char_024	.byte	$00, $18, $3C, $7E, $18, $18, $18, $18	; (Up arrow)
Char_025	.byte	$18, $18, $18, $18, $7E, $3C, $18, $00	; (Down arrow)
Char_026	.byte	$00, $08, $0C, $FE, $FE, $0C, $08, $00	; (Right arrow)
Char_027	.byte	$00, $10, $30, $7F, $7F, $30, $10, $00	; (Left arrow)
Char_028	.byte	$18, $3C, $7E, $18, $18, $7E, $3C, $18	; (Up-down arrow)
Char_029	.byte	$00, $24, $66, $FF, $FF, $66, $24, $00	; (Left-right arrow)
Char_030	.byte	$00, $00, $18, $3C, $7E, $FF, $00, $00	; (Big arrow up)
Char_031	.byte	$00, $00, $FF, $7E, $3C, $18, $00, $00	; (Big arrow down)
Char_032	.byte	$00, $00, $00, $00, $00, $00, $00, $00	; ( )
Char_033	.byte	$18, $18, $18, $18, $00, $00, $18, $00	; (!)
Char_034	.byte	$66, $66, $66, $00, $00, $00, $00, $00	; (")
Char_035	.byte	$66, $66, $FF, $66, $FF, $66, $66, $00	; (#)
Char_036	.byte	$18, $3E, $60, $3C, $06, $7C, $18, $00	; ($)
Char_037	.byte	$62, $66, $0C, $18, $30, $66, $46, $00	; (%)
Char_038	.byte	$3C, $66, $3C, $38, $67, $66, $3F, $00	; (&)
Char_039	.byte	$06, $0C, $18, $00, $00, $00, $00, $00	; (')
Char_040	.byte	$0C, $18, $30, $30, $30, $18, $0C, $00	; (()
Char_041	.byte	$30, $18, $0C, $0C, $0C, $18, $30, $00	; ())
Char_042	.byte	$00, $66, $3C, $FF, $3C, $66, $00, $00	; (*)
Char_043	.byte	$00, $18, $18, $7E, $18, $18, $00, $00	; (+)
Char_044	.byte	$00, $00, $00, $00, $00, $18, $18, $30	; (,)
Char_045	.byte	$00, $00, $00, $7E, $00, $00, $00, $00	; (-)
Char_046	.byte	$00, $00, $00, $00, $00, $18, $18, $00	; (.)
Char_047	.byte	$00, $03, $06, $0C, $18, $30, $60, $00	; (/)
Char_048	.byte	$3C, $66, $6E, $76, $66, $66, $3C, $00	; (0)
Char_049	.byte	$18, $18, $38, $18, $18, $18, $7E, $00	; (1)
Char_050	.byte	$3C, $66, $06, $0C, $30, $60, $7E, $00	; (2)
Char_051	.byte	$3C, $66, $06, $1C, $06, $66, $3C, $00	; (3)
Char_052	.byte	$06, $0E, $1E, $66, $7F, $06, $06, $00	; (4)
Char_053	.byte	$7E, $60, $7C, $06, $06, $66, $3C, $00	; (5)
Char_054	.byte	$3C, $66, $60, $7C, $66, $66, $3C, $00	; (6)
Char_055	.byte	$7E, $66, $0C, $18, $18, $18, $18, $00	; (7)
Char_056	.byte	$3C, $66, $66, $3C, $66, $66, $3C, $00	; (8)
Char_057	.byte	$3C, $66, $66, $3E, $06, $66, $3C, $00	; (9)
Char_058	.byte	$00, $00, $18, $00, $00, $18, $00, $00	; (:)
Char_059	.byte	$00, $00, $18, $00, $00, $18, $18, $30	; (;)
Char_060	.byte	$0E, $18, $30, $60, $30, $18, $0E, $00	; (<)
Char_061	.byte	$00, $00, $7E, $00, $7E, $00, $00, $00	; (=)
Char_062	.byte	$70, $18, $0C, $06, $0C, $18, $70, $00	; (>)
Char_063	.byte	$3C, $66, $06, $0C, $18, $00, $18, $00	; (?)
Char_064	.byte	$3C, $66, $6E, $6E, $60, $62, $3C, $00	; (@)
Char_065	.byte	$18, $3C, $66, $7E, $66, $66, $66, $00	; (A)
Char_066	.byte	$7C, $66, $66, $7C, $66, $66, $7C, $00	; (B)
Char_067	.byte	$3C, $66, $60, $60, $60, $66, $3C, $00	; (C)
Char_068	.byte	$78, $6C, $66, $66, $66, $6C, $78, $00	; (D)
Char_069	.byte	$7E, $60, $60, $78, $60, $60, $7E, $00	; (E)
Char_070	.byte	$7E, $60, $60, $78, $60, $60, $60, $00	; (F)
Char_071	.byte	$3C, $66, $60, $6E, $66, $66, $3C, $00	; (G)
Char_072	.byte	$66, $66, $66, $7E, $66, $66, $66, $00	; (H)
Char_073	.byte	$3C, $18, $18, $18, $18, $18, $3C, $00	; (I)
Char_074	.byte	$1E, $0C, $0C, $0C, $0C, $6C, $38, $00	; (J)
Char_075	.byte	$66, $6C, $78, $70, $78, $6C, $66, $00	; (K)
Char_076	.byte	$60, $60, $60, $60, $60, $60, $7E, $00	; (L)
Char_077	.byte	$63, $77, $7F, $6B, $63, $63, $63, $00	; (M)
Char_078	.byte	$66, $76, $7E, $7E, $6E, $66, $66, $00	; (N)
Char_079	.byte	$3C, $66, $66, $66, $66, $66, $3C, $00	; (O)
Char_080	.byte	$7C, $66, $66, $7C, $60, $60, $60, $00	; (P)
Char_081	.byte	$3C, $66, $66, $66, $66, $3C, $0E, $00	; (Q)
Char_082	.byte	$7C, $66, $66, $7C, $78, $6C, $66, $00	; (R)
Char_083	.byte	$3C, $66, $60, $3C, $06, $66, $3C, $00	; (S)
Char_084	.byte	$7E, $18, $18, $18, $18, $18, $18, $00	; (T)
Char_085	.byte	$66, $66, $66, $66, $66, $66, $3C, $00	; (U)
Char_086	.byte	$66, $66, $66, $66, $66, $3C, $18, $00	; (V)
Char_087	.byte	$63, $63, $63, $6B, $7F, $77, $63, $00	; (W)
Char_088	.byte	$66, $66, $3C, $18, $3C, $66, $66, $00	; (X)
Char_089	.byte	$66, $66, $66, $3C, $18, $18, $18, $00	; (Y)
Char_090	.byte	$7E, $06, $0C, $18, $30, $60, $7E, $00	; (Z)
Char_091	.byte	$3C, $30, $30, $30, $30, $30, $3C, $00	; ([)
Char_092	.byte	$00, $60, $30, $18, $0C, $06, $03, $00	; (\)
Char_093	.byte	$3C, $0C, $0C, $0C, $0C, $0C, $3C, $00	; (])
Char_094	.byte	$08, $1C, $36, $63, $00, $00, $00, $00	; (^)
Char_095	.byte	$00, $00, $00, $00, $00, $00, $00, $FF	; (_)
Char_096	.byte	$30, $20, $10, $00, $00, $00, $00, $00	; (`)
Char_097	.byte	$00, $00, $3C, $06, $3E, $66, $3E, $00	; (a)
Char_098	.byte	$00, $60, $60, $7C, $66, $66, $7C, $00	; (b)
Char_099	.byte	$00, $00, $3C, $60, $60, $60, $3C, $00	; (c)
Char_100	.byte	$00, $06, $06, $3E, $66, $66, $3E, $00	; (d)
Char_101	.byte	$00, $00, $3C, $66, $7E, $60, $3C, $00	; (e)
Char_102	.byte	$00, $0E, $18, $3E, $18, $18, $18, $00	; (f)
Char_103	.byte	$00, $00, $3E, $66, $66, $3E, $06, $7C	; (g)
Char_104	.byte	$00, $60, $60, $7C, $66, $66, $66, $00	; (h)
Char_105	.byte	$00, $18, $00, $38, $18, $18, $3C, $00	; (i)
Char_106	.byte	$00, $06, $00, $06, $06, $06, $06, $3C	; (j)
Char_107	.byte	$00, $60, $60, $6C, $78, $6C, $66, $00	; (k)
Char_108	.byte	$00, $38, $18, $18, $18, $18, $3C, $00	; (l)
Char_109	.byte	$00, $00, $66, $7F, $7F, $6B, $63, $00	; (m)
Char_110	.byte	$00, $00, $7C, $66, $66, $66, $66, $00	; (n)
Char_111	.byte	$00, $00, $3C, $66, $66, $66, $3C, $00	; (o)
Char_112	.byte	$00, $00, $7C, $66, $66, $7C, $60, $60	; (p)
Char_113	.byte	$00, $00, $3E, $66, $66, $3E, $06, $06	; (q)
Char_114	.byte	$00, $00, $7C, $66, $60, $60, $60, $00	; (r)
Char_115	.byte	$00, $00, $3E, $60, $3C, $06, $7C, $00	; (s)
Char_116	.byte	$00, $18, $7E, $18, $18, $18, $0E, $00	; (t)
Char_117	.byte	$00, $00, $66, $66, $66, $66, $3E, $00	; (u)
Char_118	.byte	$00, $00, $66, $66, $66, $3C, $18, $00	; (v)
Char_119	.byte	$00, $00, $63, $6B, $7F, $3E, $36, $00	; (w)
Char_120	.byte	$00, $00, $66, $3C, $18, $3C, $66, $00	; (x)
Char_121	.byte	$00, $00, $66, $66, $66, $3E, $0C, $78	; (y)
Char_122	.byte	$00, $00, $7E, $0C, $18, $30, $7E, $00	; (z)
Char_123	.byte	$0E, $18, $18, $30, $18, $18, $0E, $00	; ({)
Char_124	.byte	$18, $18, $18, $00, $18, $18, $18, $00	; (|)
Char_125	.byte	$E0, $30, $30, $18, $30, $30, $E0, $00	; (})
Char_126	.byte	$00, $00, $00, $32, $4C, $00, $00, $00	; (~)
Char_127	.byte	$00, $00, $00, $00, $00, $00, $00, $00	; (Nothing)
Char_128	.byte	$00, $00, $00, $1F, $1F, $18, $18, $18	; (Border, single, middle, upper-left)
Char_129	.byte	$00, $00, $00, $F8, $F8, $18, $18, $18	; (Border, single, middle, upper-right)
Char_130	.byte	$18, $18, $18, $1F, $1F, $00, $00, $00	; (Border, single, middle, lower-left)
Char_131	.byte	$18, $18, $18, $F8, $F8, $00, $00, $00	; (Border, single, middle, lower-right)
Char_132	.byte	$00, $00, $00, $FF, $FF, $00, $00, $00	; (Border, single, middle, horizontal)
Char_133	.byte	$18, $18, $18, $18, $18, $18, $18, $18	; (Border, single, middle, vertical)
Char_134	.byte	$18, $18, $18, $FF, $FF, $18, $18, $18	; (Border, single, middle, crossing horz & vert)
Char_135	.byte	$18, $18, $18, $1F, $1F, $18, $18, $18	; (Border, single, middle, vert-across, horiz-right)
Char_136	.byte	$18, $18, $18, $F8, $F8, $18, $18, $18	; (Border, single, middle, vert-across, horiz-left)
Char_137	.byte	$00, $00, $00, $FF, $FF, $18, $18, $18	; (Border, single, middle, horiz-across, vert-down)
Char_138	.byte	$18, $18, $18, $FF, $FF, $00, $00, $00	; (Border, single, middle, horiz-across, vert-up)
Char_139	.byte	$F0, $F0, $F0, $F0, $00, $00, $00, $00	; (Quarter cube, upper-left)
Char_140	.byte	$0F, $0F, $0F, $0F, $00, $00, $00, $00	; (Quarter cube, upper-right)
Char_141	.byte	$00, $00, $00, $00, $F0, $F0, $F0, $F0	; (Quarter cube, lower-left)
Char_142	.byte	$00, $00, $00, $00, $0F, $0F, $0F, $0F	; (Quarter cube, lower-right)
Char_143	.byte	$F0, $F0, $F0, $F0, $0F, $0F, $0F, $0F	; (Dual quarter cube, upper-left, lower-right)
Char_144	.byte	$33, $99, $CC, $66, $33, $99, $CC, $66	; (.)
Char_145	.byte	$CC, $99, $33, $66, $CC, $99, $33, $66	; (.)
Char_146	.byte	$33, $33, $CC, $CC, $33, $33, $CC, $CC	; (.)
Char_147	.byte	$30, $30, $C0, $C0, $30, $30, $C0, $C0	; (.)
Char_148	.byte	$03, $03, $0C, $0C, $03, $03, $0C, $0C	; (.)
Char_149	.byte	$33, $33, $CC, $CC, $00, $00, $00, $00	; (.)
Char_150	.byte	$00, $00, $00, $00, $33, $33, $CC, $CC	; (.)
Char_151	.byte	$80, $80, $80, $80, $80, $80, $80, $80	; (.)
Char_152	.byte	$C0, $C0, $C0, $C0, $C0, $C0, $C0, $C0	; (.)
Char_153	.byte	$E0, $E0, $E0, $E0, $E0, $E0, $E0, $E0	; (.)
Char_154	.byte	$F0, $F0, $F0, $F0, $F0, $F0, $F0, $F0	; (.)
Char_155	.byte	$F8, $F8, $F8, $F8, $F8, $F8, $F8, $F8	; (.)
Char_156	.byte	$FC, $FC, $FC, $FC, $FC, $FC, $FC, $FC	; (.)
Char_157	.byte	$FE, $FE, $FE, $FE, $FE, $FE, $FE, $FE	; (.)
Char_158	.byte	$FF, $FF, $FF, $FF, $FF, $FF, $FF, $FF	; (.)
Char_159	.byte	$7F, $7F, $7F, $7F, $7F, $7F, $7F, $7F	; (.)
Char_160	.byte	$3F, $3F, $3F, $3F, $3F, $3F, $3F, $3F	; (.)
Char_161	.byte	$1F, $1F, $1F, $1F, $1F, $1F, $1F, $1F	; (.)
Char_162	.byte	$0F, $0F, $0F, $0F, $0F, $0F, $0F, $0F	; (.)
Char_163	.byte	$03, $03, $03, $03, $03, $03, $03, $03	; (.)
Char_164	.byte	$01, $01, $01, $01, $01, $01, $01, $01	; (.)
Char_165	.byte	$00, $00, $00, $00, $00, $00, $00, $FF	; (.)
Char_166	.byte	$00, $00, $00, $00, $00, $00, $FF, $FF	; (.)
Char_167	.byte	$00, $00, $00, $00, $FF, $FF, $FF, $FF	; (.)
Char_168	.byte	$00, $00, $00, $FF, $FF, $FF, $FF, $FF	; (.)
Char_169	.byte	$00, $00, $FF, $FF, $FF, $FF, $FF, $FF	; (.)
Char_170	.byte	$00, $FF, $FF, $FF, $FF, $FF, $FF, $FF	; (.)
Char_171	.byte	$FF, $FF, $FF, $FF, $FF, $FF, $FF, $00	; (.)
Char_172	.byte	$FF, $FF, $FF, $FF, $FF, $FF, $00, $00	; (.)
Char_173	.byte	$FF, $FF, $FF, $FF, $FF, $00, $00, $00	; (.)
Char_174	.byte	$FF, $FF, $FF, $FF, $00, $00, $00, $00	; (.)
Char_175	.byte	$FF, $FF, $FF, $00, $00, $00, $00, $00	; (.)
Char_176	.byte	$FF, $FF, $00, $00, $00, $00, $00, $00	; (.)
Char_177	.byte	$FF, $00, $00, $00, $00, $00, $00, $00	; (.)
Char_178	.byte	$00, $00, $FF, $FF, $00, $00, $00, $00	; (.)
Char_179	.byte	$00, $FF, $FF, $00, $00, $00, $00, $00	; (.)
Char_180	.byte	$00, $00, $00, $00, $FF, $FF, $00, $00	; (.)
Char_181	.byte	$00, $00, $00, $00, $00, $FF, $FF, $00	; (.)
Char_182	.byte	$30, $30, $30, $30, $30, $30, $30, $30	; (.)
Char_183	.byte	$60, $60, $60, $60, $60, $60, $60, $60	; (.)
Char_184	.byte	$0C, $0C, $0C, $0C, $0C, $0C, $0C, $0C	; (.)
Char_185	.byte	$06, $06, $06, $06, $06, $06, $06, $06	; (.)
Char_186	.byte	$C0, $E0, $70, $38, $1C, $0E, $07, $03	; (.)
Char_187	.byte	$03, $07, $0E, $1C, $38, $70, $E0, $C0	; (.)
Char_188	.byte	$C3, $E7, $7E, $3C, $3C, $7E, $E7, $C3	; (.)
Char_189	.byte	$FF, $FF, $C0, $C0, $C0, $C0, $C0, $C0	; (.)
Char_190	.byte	$FF, $FF, $03, $03, $03, $03, $03, $03	; (.)
Char_191	.byte	$C0, $C0, $C0, $C0, $C0, $C0, $FF, $FF	; (.)
Char_192	.byte	$03, $03, $03, $03, $03, $03, $FF, $FF	; (.)
Char_193	.byte	$FF, $81, $81, $81, $81, $81, $81, $FF	; (.)
Char_194	.byte	$FF, $FF, $C3, $C3, $C3, $C3, $FF, $FF	; (.)
Char_195	.byte	$FF, $FF, $FF, $E7, $E7, $FF, $FF, $FF	; (.)
Char_196	.byte	$FF, $81, $BD, $A5, $A5, $BD, $81, $FF	; (.)
Char_197	.byte	$00, $00, $00, $07, $0F, $1C, $18, $18	; (.)
Char_198	.byte	$00, $00, $00, $E0, $F0, $38, $18, $18	; (.)
Char_199	.byte	$18, $18, $1C, $0F, $07, $00, $00, $00	; (.)
Char_200	.byte	$18, $18, $38, $F0, $E0, $00, $00, $00	; (.)
Char_201	.byte	$00, $3C, $7E, $66, $66, $7E, $3C, $00	; (.)
Char_202	.byte	$00, $00, $00, $18, $18, $00, $00, $00	; (.)
Char_203	.byte	$00, $00, $3C, $3C, $3C, $3C, $00, $00	; (.)
Char_204	.byte	$00, $7E, $7E, $7E, $7E, $7E, $7E, $00	; (.)
Char_205	.byte	$36, $7F, $7F, $7F, $3E, $1C, $08, $00	; (Heart)
Char_206	.byte	$08, $1C, $3E, $7F, $3E, $1C, $08, $00	; (Diamond)
Char_207	.byte	$18, $18, $66, $66, $18, $18, $3C, $00	; (Clover)
Char_208	.byte	$08, $1C, $3E, $7F, $7F, $1C, $3E, $00	; (Spade)
Char_209	.byte	$7E, $81, $A5, $81, $A5, $BD, $81, $7E	; (Face, happy)
Char_210	.byte	$00, $00, $18, $3C, $3C, $18, $00, $00	; (.)
Char_211	.byte	$00, $3C, $7E, $7E, $7E, $7E, $3C, $00	; (.)
Char_212	.byte	$3C, $7E, $FF, $FF, $FF, $FF, $7E, $3C	; (.)
Char_213	.byte	$00, $00, $18, $24, $24, $18, $00, $00	; (.)
Char_214	.byte	$00, $3C, $66, $42, $42, $66, $3C, $00	; (.)
Char_215	.byte	$3C, $66, $C3, $81, $81, $C3, $66, $3C	; (.)
Char_216	.byte	$7E, $81, $A5, $81, $BD, $A5, $81, $7E	; (Face, sad)
Char_217	.byte	$55, $AA, $55, $AA, $55, $AA, $55, $AA	; (.)
Char_218	.byte	$00, $2A, $54, $2A, $54, $2A, $54, $00	; (.)
Char_219	.byte	$00, $00, $14, $28, $14, $28, $00, $00	; (.)
Char_220	.byte	$00, $00, $00, $08, $10, $00, $00, $00	; (.)
Char_221	.byte	$00, $00, $00, $10, $08, $00, $00, $00	; (.)
Char_222	.byte	$00, $00, $28, $14, $28, $14, $00, $00	; (.)
Char_223	.byte	$00, $54, $2A, $54, $2A, $54, $2A, $00	; (.)
Char_224	.byte	$7E, $81, $A5, $81, $BD, $99, $81, $7E	; (Face, tongue out)
Char_225	.byte	$FE, $FC, $F8, $F0, $E0, $C0, $80, $00	; (.)
Char_226	.byte	$7F, $3F, $1F, $0F, $07, $03, $01, $00	; (.)
Char_227	.byte	$00, $01, $03, $07, $0F, $1F, $3F, $7F	; (.)
Char_228	.byte	$00, $80, $C0, $E0, $F0, $F8, $FC, $FE	; (.)
Char_229	.byte	$FF, $FE, $FC, $F8, $F0, $E0, $C0, $80	; (.)
Char_230	.byte	$FF, $7F, $3F, $1F, $0F, $07, $03, $01	; (.)
Char_231	.byte	$01, $03, $07, $0F, $1F, $3F, $7F, $FF	; (.)
Char_232	.byte	$80, $C0, $E0, $F0, $F8, $FC, $FE, $FF	; (.)
Char_233	.byte	$FF, $FF, $00, $00, $FF, $FF, $00, $00	; (.)
Char_234	.byte	$00, $00, $FF, $FF, $00, $00, $FF, $FF	; (.)
Char_235	.byte	$CC, $CC, $CC, $CC, $CC, $CC, $CC, $CC	; (.)
Char_236	.byte	$33, $33, $33, $33, $33, $33, $33, $33	; (.)
Char_237	.byte	$FF, $FF, $C0, $C0, $CF, $CF, $CC, $CC	; (.)
Char_238	.byte	$FF, $FF, $03, $03, $F3, $F3, $33, $33	; (.)
Char_239	.byte	$CC, $CC, $CF, $CF, $C0, $C0, $FF, $FF	; (.)
Char_240	.byte	$33, $33, $F3, $F3, $03, $03, $FF, $FF	; (.)
Char_241	.byte	$FF, $FF, $C3, $C3, $C3, $C3, $C3, $C3	; (.)
Char_242	.byte	$FF, $FF, $03, $03, $03, $03, $FF, $FF	; (.)
Char_243	.byte	$C3, $C3, $C3, $C3, $C3, $C3, $FF, $FF	; (.)
Char_244	.byte	$FF, $FF, $C0, $C0, $C0, $C0, $FF, $FF	; (.)
Char_245	.byte	$C3, $C3, $00, $00, $00, $00, $C3, $C3	; (.)
Char_246	.byte	$FF, $FF, $00, $00, $00, $00, $FF, $FF	; (.)
Char_247	.byte	$C3, $C3, $C3, $C3, $C3, $C3, $C3, $C3	; (.)
Char_248	.byte	$FF, $FF, $00, $00, $00, $00, $C3, $C3	; (.)
Char_249	.byte	$C3, $C3, $03, $03, $03, $03, $C3, $C3	; (.)
Char_250	.byte	$C3, $C3, $00, $00, $00, $00, $FF, $FF	; (.)
Char_251	.byte	$C3, $C3, $C0, $C0, $C0, $C0, $C3, $C3	; (.)
Char_252	.byte	$7E, $81, $A5, $81, $B1, $8D, $81, $7E	; (Face, confuzed)
Char_253	.byte	$7E, $81, $A5, $81, $85, $BD, $81, $7E	; (Face, smirk)
Char_254	.byte	$7E, $81, $A5, $81, $81, $BD, $81, $7E	; (Face, meh)
Char_255	.byte	$7E, $81, $A5, $81, $99, $99, $81, $7E	; (Face, surprised)
